eduarbo/flan/docs/frame-proposals.md

# Selected frames

[Open the mobile gallery](https://flankbd.com/frame-proposals/).

The collection contains only **Talavera, Game Boy, SNES, Phone, iPod and Hanafuda**. Their artwork and palettes remain unchanged. No new proposals await approval.

Each gallery card includes an enlarged preview, dimensions and a 1:1 SVG. All designs use solid colors and flush details on the current 24 × 56 mm frame.

All six designs are installed in the current assembly, explorer and print exports. The native archive retains earlier geometry. [Current selection record](../design/frame-selection.json).
