eduarbo/flan/ATTRIBUTION.md

# Credits and licenses

Flan36 is inspired by Piantor by beekeeb and keeps Piantor's 36 key centres and angles, translated per half without change. Flan42 and Flan54 add Piantor's outer pinky column (K00/K10/K20). That key layout is the part of Flan derived from Piantor, under GPL-3.0. The wireless PCBs and their routing, the case outline rule, the cases, frames, firmware and branding are original work by Eduardo Ruiz. Imported reference files and third-party component meshes are credited individually below. There is no implied affiliation or certification by beekeeb or component manufacturers.

| Material | Author / source | License and changes |
|---|---|---|
| `sources/piantor/*.kicad_pcb` | beekeeb / Leo, [Piantor](https://github.com/beekeeb/piantor), commit `cd847afb4f9a86e8c1c8e36f243140644013afb2` | GPL-3.0; unchanged original copies |
| Choc footprint `keyswitches:Kailh_socket_PG1350_optional` | daprice, [keyswitches.pretty](https://github.com/daprice/keyswitches.pretty) | CC-BY-SA-4.0; notice in [LICENSES/Keyswitches.md](LICENSES/Keyswitches.md) |
| `Keebio-Parts:TRRS-PJ-320A` footprint | [Keebio](https://github.com/keebio/Keebio-Parts.pretty), commit `063565dcba9a8ee807d49772de0ed75ecaedcc26` | MIT; copyright/permission in [LICENSES/Keebio-MIT.txt](LICENSES/Keebio-MIT.txt) |
| `RPi_Pico:RPi_Pico_SMD_TH` footprint | [TPCWare / Nicola Carandini](https://github.com/ncarandini/KiCad-RP-Pico), commit `dc6f9b9f213dc36eebce626aa9ee72a333fa0db3` | [TPCWare license](LICENSES/TPCWare-KiCad.txt): CC-BY-SA-4.0 with design exception |
| Standard KiCad footprints, including `Resistor_SMD:R_1206_3216Metric_Pad1.30x1.75mm_HandSolder` | [KiCad libraries](https://www.kicad.org/libraries/license/) | [CC-BY-SA-4.0 with design exception](LICENSES/KiCad-Libraries.md) |
| `design/layout.json`, layout diagram; outer-column centres in `design/variants.json` | Key centres and angles of [Piantor](https://github.com/beekeeb/piantor) by beekeeb / Leo, commit `cd847afb4f9a86e8c1c8e36f243140644013afb2`; `source_x`/`source_y` keep the original coordinates | GPL-3.0; translated per half, angles unchanged; Flan36 omits the outer column, Flan42/54 restore it upright |
| `keycaps/*.stl`, `keycaps/variants/*.stl`, KLP meshes in FCStd/viewer/GLB | [KLP Lamé by braindefender](https://github.com/braindefender/KLP-Lame-Keycaps), commit `4a67a824232d3054c61599ea047c56a340faaba2` | CC-BY-SA-4.0; unchanged meshes, placed and colored. RevG catalogs all 38 Choc-stem files, Choc/MX body sizes. [Original three sources](keycaps/sources.json), [complete pinned sources](keycaps/variants-source.json) |
| `docs/images/revE-*.png` through `revI-*.png`, including case screenshots, and `docs/images/viewer-*.png` | Original Flan36 CAD renders incorporating credited KLP Lamé meshes | CC-BY-SA-4.0; calculated from attributed meshes, no image retouching |
| `docs/marketing/assets/` product renders, cards and teaser videos; `docs/assets/home-og*.png` and `viewer/home/home-og.png` | Eduardo Ruiz / Flan CAD renders incorporating KLP Lamé by braindefender; composition and typography from `viewer/marketing/` | CC-BY-SA-4.0 for the rendered compositions, matching the existing CAD-render license; see [asset notice](docs/marketing/ASSET-LICENSE.md). Avatar/logo retain their existing GPL-3.0-or-later and trademark terms. |
| Original CAD, project tools and original documentation | Eduardo Ruiz / Flan36 contributors | GPL-3.0-or-later, except identified materials above |
| Embedded 3D engine | [Three.js](https://github.com/mrdoob/three.js), 0.180.0 | MIT; full [notice](LICENSES/Three-MIT.txt) also embedded in offline HTML |
| Home page model packs, `docs/assets/home-*.bin` | Viewer scene meshes, including KLP Lamé keycaps, simplified within a stated error with [meshoptimizer](https://github.com/zeux/meshoptimizer) 1.2.0 | Keycap meshes stay CC-BY-SA-4.0 as simplified adaptations; meshoptimizer is MIT ([notice](LICENSES/meshoptimizer-MIT.txt)); its decoder is bundled in the home page |
| Explorer mesh files, `docs/explore/assets/geometry-*.bin` | Viewer scene meshes, including KLP Lamé keycaps: positions and triangles unchanged, encoded with [meshoptimizer](https://github.com/zeux/meshoptimizer) 1.2.0; normals stored as 16-bit octahedral vectors | Keycap meshes stay CC-BY-SA-4.0; meshoptimizer is MIT ([notice](LICENSES/meshoptimizer-MIT.txt)); its decoder is bundled in the explorer |
| Home page fonts, `docs/assets/fonts/` | [Fraunces](https://github.com/undercasetype/Fraunces), [Inter](https://github.com/rsms/inter), [JetBrains Mono](https://github.com/JetBrains/JetBrainsMono): Google Fonts latin subsets, served locally | SIL OFL 1.1: [Fraunces](LICENSES/Fraunces-OFL.txt), [Inter](LICENSES/Inter-OFL.txt), [JetBrains Mono](LICENSES/JetBrainsMono-OFL.txt) |
| External product photos in the parts guide | Typeractive, Adafruit and respective rights holders | Linked/embedded from supplier listings; not copied into the asset tree or relicensed under the repository license |

The viewer retains source notices; exported GLB includes attribution and source/license links. Viewer code is under GPL-3.0-or-later; esbuild is a pinned build dependency. Gzip packaging does not alter the underlying geometry, and the explorer's mesh files keep every position and triangle byte for byte.

The three `docs/images/branding/flan36-*-concept.png` boards were generated with OpenAI's built-in image generation tool for Eduardo's Flan36 identity exploration. They are concept art, not renders of the measured CAD. Four additional Caramel refinements (`flan36-caramel-soft.png`, `flan36-caramel-drop.png`, `flan36-caramel-bold.png`, `flan36-caramel-outline.png`) use the selected Caramel board as their reference. Prompts and provenance are retained in `design/branding-prompts.json`, `design/branding-caramel-prompts.json` and `design/branding.json`; their reuse follows the repository's GPL-3.0-or-later terms to the extent applicable.

Full texts: [GPL](LICENSE), [CC-BY-SA-4.0](LICENSES/CC-BY-SA-4.0.txt). Original upstream hashes: [sources/manifest.json](sources/manifest.json).

Libraries under `hardware/revF/libraries` contain KiCad sources with the design exception, daprice’s Choc footprint under CC-BY-SA-4.0, and Flan36 symbols/footprints. STEP files under `hardware/revF/models` are original nominal envelopes, not manufacturer-certified models.

FreeCAD, StepUp, ZMK, Zephyr, nice!nano and nice!view retain their own names/licenses. FreeCAD/StepUp are installed separately; firmware candidates are distributed with pinned sources and [dependency notices](firmware/NOTICE.md). Supplier links do not imply sponsorship.

## Commercial component representations

KiSwitch Choc v1 source CAD is used under its MIT option (copyright 2019–2022 keyswitch-kicad-library contributors). KiCad PCM12, TL3342 and SOD-123 assets use CC-BY-SA-4.0 with the KiCad library exception. See [per-file sources, transformations and limits](components/README.md) and [asset hashes](components/sources.json). nice!nano v2 is an original nominal reconstruction referenced to official photographs and the Woovie community drawing; no official photograph is embedded or relicensed.

The Flan wordmark in `docs/branding/flan/` and on the revI back silkscreen is the word “flan” set in [Fraunces](https://github.com/undercasetype/Fraunces) by Undercase Type (Phaedra Charles and Flavia Zimbardi), © 2018 The Fraunces Project Authors, under the SIL Open Font License 1.1. It was converted to outlines; the font software is not redistributed. The tecla-flan mark is original work under the project's GPL-3.0-or-later.

The `docs/branding/outline/flan36-*.svg` artwork is a deterministic vector conversion of the selected Outline board’s monochrome reference. Letterforms are traced paths, not a bundled or substituted font. Source, reference hash and contour checks are recorded in `tools/build_outline_logo.py`, `validation/branding-outline-trace.json` and `design/branding-outline-vectors.json`. The preview and SVG kit follow GPL-3.0-or-later to the extent applicable.

## Trademarks

The GPL covers the logo artwork as files, not the right to use Flan's names and marks. As an additional term under GPL-3.0 section 7(e), the project's license grants no trademark rights to the names Flan, Flan36, Flan42, Flan46 and Flan54, the Flan wordmark or the tecla-flan mark. See [TRADEMARKS.md](TRADEMARKS.md).

Some theme and frame names refer to other products and works by name, such as Game Boy, NES, SNES, Walkman, iPod and the EVA units of Evangelion. They describe a color palette or a look. Those names belong to their owners; Flan is not affiliated with or endorsed by them, and uses none of their logos or artwork.

## CAD authorship correction · 2026-10-09

Earlier viewer credits, GLB metadata and project descriptions incorrectly described the whole CAD as derived from Piantor. Eduardo Ruiz clarified that the CAD is his original design and Piantor inspired the key count. Current descriptions and exports reflect that correction. Historical coordinate-reference metadata, archived upstream copies and third-party license notices are preserved; no geometry or license terms changed.

## Key layout provenance · 2026-10-18

The 2026-10-09 wording said Piantor only inspired the key count. That understated it: all 36 centres and angles in `design/layout.json` match Piantor's switch footprints in `sources/piantor/` after a constant per-half translation, and Flan42/54 reuse Piantor's outer column. Descriptions now say that the key layout comes from Piantor. The PCBs and routing, the revI case outline rule (`tools/outline.py`), cases, frames and firmware remain Eduardo's original work; only the early RevE case study (`tools/build_case.py`) traced Piantor's board exterior. No geometry or license terms changed.
