eduarbo/flan/docs/cases.md

# Pick a case

Flan42, Flan46 and Flan54 have the same four styles, built from this case; see [their cases](variants.md#cases).

[Open the 3D explorer](https://flankbd.com/explore/) → **Design → Case** → choose a thumbnail. **Per half** applies a style to one half, so the halves can differ.

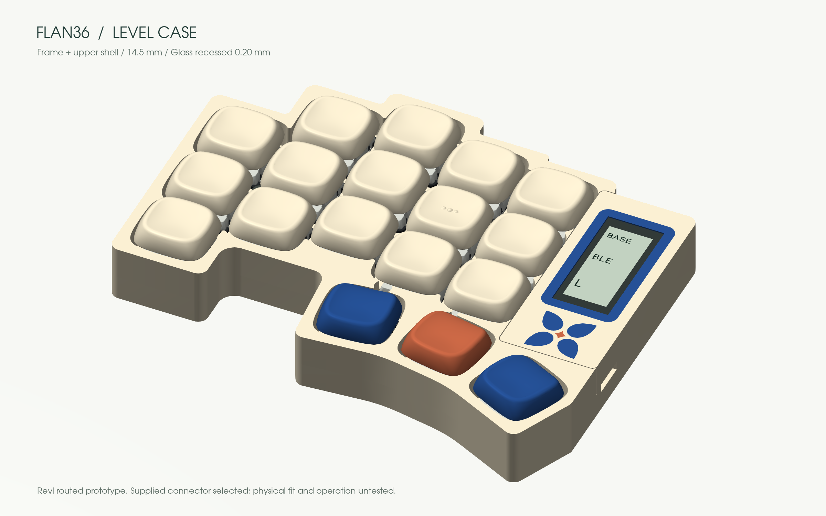
[picture p45: docs/images/revI-level.png]
Level case with flush glass and frame


| Solid | Color rim | Terrace |
|---|---|---|
| Solid | Color rim | Terrace |

| Design | Geometry | Suggested finish |
|---|---|---|
| **Level** | Switch-covering removable upper shell at the 14.50 mm frame plane | Match upper shell and frame |
| **Solid** | Full plate over a continuous sidewall | Deep teal |
| **Color rim** | 0.9 mm wide rim flush with the plate, 1.1 mm plate inset, 0.2 mm joint | Red base + black plate |
| **Terrace** | Two 0.25 mm deep, 0.6 mm high recessed side bands | Sage base + dark plate |

All four follow the same Flan36 key positions. Straight thumb faces stay parallel to their keys; tangent arcs soften their joins. Finger corners use up to R2.4, reduced locally at short steps. The pinky backbone remains 90°. No screw adds an outward bulge, and the thumb flank stays within the display-panel edge.

The shared outline is **116.75 × 94.57 mm per half**. Its 4.75 mm straight-face allowance protects the existing pads on both boards. The Color rim changes the visible plate edge without reducing that PCB budget. Terrace leaves at least 1.05 mm nominal sidewall away from intentional service openings; the 1.4 mm floor stays unchanged.

The **Level** upper shell and frame share the **14.50 mm** plane; the display glass is recessed 0.20 mm at **14.30 mm**. The original 1.3 mm switch-retaining plate is incorporated into the same removable part, using the three existing screws. Remove the caps to reach them. Upper openings are sized from the admitted KLP travel envelopes; the selected caps still reach about 17.87 mm. [Stack dimensions and connector qualification](level-stack.md).

## Open or covered

Uncheck **Printed display cover** to expose the current stack. The display, controller, battery and structural supports remain; the printed cover and its three Ø2 × 4 mm frame magnets are omitted. The three Ø2 × 3 mm base magnets stay in place. Choose any display frame to reinstall it. This is the wireless nice!nano/nice!view stack, not the Raspberry Pi Pico arrangement in the inspiration photo.

Color rim with the display stack exposed

**Eye / Solo** only change visibility. **Printed display cover** changes the saved assembly. Both choices are reversible, but only the assembly choice affects exported GLB and FreeCAD configuration.

## Edit and print

For Flan36, the optional [common M2 screw variant](common-fasteners.md) enlarges the hidden head pockets for ordinary socket-cap screws. Choose it in the explorer under **Build → Buy the parts → Screws**; the low-head reference screws remain the default.

Download [Flan36.FCStd](../mechanical/revI/Flan36.FCStd) and use the [FreeCAD guide](freecad.md). `ActiveTray` and `ActivePlate` link to native `Case_solid`, `Case_rim`, `Case_terrace` or `Case_level` bodies. Edit their source sketches and boolean operations under **Construction**. No custom Python proxy is needed to reopen the document.

[All case parts](../mechanical/revI) use `left-case-{solid,rim,terrace,level}-{base,plate}.{step,stl}` and matching `right-` names. Exported parts retain assembly coordinates. The viewer saves per-half case and cover choices in JSON; import that JSON with the configuration macro. JSON without case settings inherits the current default with covers installed. The assembled GLB includes the selected meshes, including when view layers are hidden.

Print the base and plate separately for contrasting colors; a multicolor printer is optional. Use the existing [fit coupons and rebuilding commands](cad.md) before a full shell. The raised rim and recessed bands are real geometry. Nominal CAD checks do not qualify their printed strength, snap or thread fit, magnetic holding force or actual electronics clearances.
