eduarbo/flan/docs/marketing/alt-text.md

# FLAN · Texto alternativo / Alt text

## ES

- `carousel-es-1.png`: Hazlo tuyo. Un teclado dividido y de código abierto. Casero, como un buen flan. PROTOTIPO · RENDER CAD.
- `carousel-es-2.png`: Pequeño. A tu manera. 36, 42, 46 o 54 teclas. Encuentra la distribución que quieres armar. PROTOTIPO · RENDER CAD.
- `carousel-es-3.png`: Un marco para tu estilo. Seis diseños de marco magnético. Cuatro carcasas. Elige tu combinación. PROTOTIPO · RENDER CAD.
- `carousel-es-4.png`: Cada capa. A la vista. Explora las piezas. Descarga PCB, firmware y archivos de impresión. El diseño es abierto. PROTOTIPO · RENDER CAD.
- `carousel-es-5.png`: De los píxeles a las piezas. Las piezas del primer Flan36 ya están encargadas. Siguen el armado y las pruebas físicas. PROTOTIPO · RENDER CAD.
- `carousel-es-6.png`: ¿Cómo sería el tuyo? 31 temas, colores por tecla y un explorador 3D. Empieza en flankbd.com. PROTOTIPO · RENDER CAD.

`share-es.png`: Render CAD de Flan36 con tema EVA-01, caja Color rim y marcos SNES / 2000s Phone. Pruebas físicas pendientes.

`square-es.png`, `story-es.png`, `youtube-es.png`, `render-hero.png`: Render CAD de Flan36, teclado dividido de 36 teclas, en crema y caramelo con marcos de pantalla Talavera. Prototipo; pruebas físicas pendientes.

## EN

- `carousel-en-1.png`: Make it yours. An open-source split keyboard. Homemade, like a good flan. PROTOTYPE · CAD RENDER.
- `carousel-en-2.png`: Small. Your kind of small. 36, 42, 46 or 54 keys. Find the layout you want to build. PROTOTYPE · CAD RENDER.
- `carousel-en-3.png`: A different frame of mind. Six magnetic display-frame designs. Four case styles. Choose your combination. PROTOTYPE · CAD RENDER.
- `carousel-en-4.png`: Every layer. Out in the open. Explore the parts. Get the PCB, firmware and print files. Build from open source. PROTOTYPE · CAD RENDER.
- `carousel-en-5.png`: From pixels to parts. The first Flan36 parts are ordered. Assembly, fit and wireless tests come next. PROTOTYPE · CAD RENDER.
- `carousel-en-6.png`: What would yours look like? 31 themes, per-key colors and a 3D explorer. Start at flankbd.com. PROTOTYPE · CAD RENDER.

`share-en.png`: CAD render of Flan36 with the EVA-01 theme, Color rim case and SNES / 2000s Phone frames. Physical tests pending.

`square-en.png`, `story-en.png`, `youtube-en.png`, `render-hero.png`: CAD render of Flan36, a 36-key split keyboard in cream and caramel with Talavera display frames. Prototype; physical tests pending.
