eduarbo/flan/docs/marketing/ASSET-LICENSE.md

# FLAN media assets · attribution

Product renders, cards, cover variants and teaser videos in this folder are **CC BY-SA 4.0**, consistent with the project's existing CAD-render license. They show the original Flan CAD by Eduardo Ruiz and include **KLP Lamé keycaps by braindefender**, placed and colored; the key layout follows **Piantor by beekeeb / Leo**. New work: explorer captures, colored backgrounds, typography, captions and sequencing. No physical product photograph is represented.

- Project and editable generation source: https://github.com/eduarbo/flan/tree/main/viewer/marketing
- Flan: https://flankbd.com/
- KLP Lamé: https://github.com/braindefender/KLP-Lame-Keycaps, pinned commit `4a67a824232d3054c61599ea047c56a340faaba2`.
- Piantor: https://github.com/beekeeb/piantor, pinned commit `cd847afb4f9a86e8c1c8e36f243140644013afb2`.
- CC BY-SA 4.0: https://creativecommons.org/licenses/by-sa/4.0/ and `LICENSES/CC-BY-SA-4.0.txt` in the downloadable kit.

Suggested credit / crédito sugerido:

> Flan by Eduardo Ruiz · CAD render with KLP Lamé keycaps by braindefender · CC BY-SA 4.0 · flankbd.com

Retain attribution and the applicable license, and explain edits. The artwork omits prototype labels at the designer’s request; accompanying project copy describes the first-build stage. Screen graphics are illustrative, not a firmware capture. The teaser has no music or borrowed typing sound.

`avatar.png` and the logo SVG kit reproduce the existing Flan mark: GPL-3.0-or-later artwork, with separate trademark terms in `TRADEMARKS.md`; no new trademark permission is granted. Typography uses Fraunces, Inter and JetBrains Mono; notices are in `LICENSES/`. Full component attribution is in the repository's `ATTRIBUTION.md` (included in the archive). That file also links source material which is available in the repository and is not all copied into this media archive.
