eduarbo/flan/docs/marketing/copy.md

# FLAN · Textos EN / ES

Borradores preparados; no publicados ni enviados. Origen: `viewer/marketing/copy.json`.

## ES

### Reddit / comunidad · versión en español

**[ad] Flan: un teclado dividido de código abierto; ya encargué las piezas del primer armado**

Soy Eduardo, el diseñador de Flan. Ya encargué las piezas del primer Flan36 y quiero compartir el diseño mientras llegan.

Es un teclado dividido de perfil bajo, con cuatro distribuciones: 36, 42, 46 y 54 teclas. Quería que su apariencia también fuera parte del proyecto: cuatro carcasas, seis diseños de marco magnético para las pantallas, 31 temas y colores por tecla. El explorador 3D permite probar una combinación, mirar sus piezas y descargar los archivos del prototipo.

Está diseñado para switches Choc v1 con sockets hot-swap, controladores nice!nano v2, ZMK y pantallas nice!view. Hay fuentes de KiCad y FreeCAD, Gerbers, archivos de impresión y firmware compilado. Flan36 conserva las posiciones de teclas de Piantor y usa keycaps KLP Lamé; los créditos están en el repositorio.

Las imágenes son renders CAD. Todavía no he armado ni probado un Flan físico: faltan comprobar ajuste, carga, conexión inalámbrica y autonomía. No estoy ofreciendo kits ni una compra grupal.

¿Qué te gustaría ver comprobado en la bitácora del primer armado?

Explorador: https://flankbd.com/explore/?size=flan36&theme=flan&case=rim&keys=original&frame=talavera
Fuentes y guía: https://github.com/eduarbo/flan

Uso: Usa esta versión en comunidades de habla hispana que permitan proyectos. Para r/ErgoMechKeyboards está preparada la versión EN, con prefijo [ad] y flair de vendor; no más de una promoción cada 14 días.

### Instagram · texto del carrusel

**Hazlo tuyo. Este es Flan.**

Piezas encargadas. Sigue el primer armado.

Este es Flan, un teclado dividido y de código abierto que estoy construyendo: cuatro tamaños, marcos magnéticos para las pantallas y una apariencia que puedes hacer tuya. Desliza para ver las distribuciones, las capas y en qué etapa va.

Las imágenes son renders CAD; el armado y las pruebas físicas vienen después. Ya puedes explorar el diseño y sus archivos en flankbd.com — enlace en mi perfil.

¿Cuántas teclas tendría el tuyo: 36, 42, 46 o 54?

#TecladosMecanicos #SplitKeyboard #DIYKeyboard #OpenSourceHardware #FlanKeyboard

Uso: Sube carousel-es-1 a carousel-es-6, en orden. Coloca flankbd.com como enlace del perfil; una URL en el texto de Instagram no equivale a un enlace pulsable.

### Instagram · Reel / YouTube Short

**Ya encargué las piezas de mi primer Flan**

Un teclado dividido para hacerlo tuyo. Este es Flan: archivos abiertos, cuatro tamaños y marcos magnéticos para las pantallas.

Las piezas del primer Flan36 ya están encargadas. Esto es un render CAD; siguen el armado y las pruebas físicas.

Explora el diseño en flankbd.com.

#TecladosMecanicos #DIYKeyboard #FlanKeyboard

Uso: Archivo: teaser-es.mp4, vertical 1080 × 1920, 30 segundos y sin audio; el texto ya está dentro del video. Subtítulos opcionales: teaser-es.srt. No representa hardware funcionando.

### YouTube · video de presentación

**Flan: así diseñé mi primer teclado dividido de código abierto**

Soy Eduardo y este es Flan: un diseño de teclado dividido y de perfil bajo, con cuatro tamaños y marcos magnéticos. Ya encargué las piezas del primer Flan36. En este video recorro el diseño, el explorador 3D y las pruebas que faltan para el primer armado físico.

Explora: https://flankbd.com/
Fuentes, créditos y guía: https://github.com/eduarbo/flan
Pruebas del primer armado: https://github.com/eduarbo/flan/blob/main/docs/first-build.md

Todas las imágenes del teclado en esta presentación son renders CAD. Todavía no hay un Flan físico armado y probado. No hay kits, preventa ni compra grupal.

Diseño: Eduardo Ruiz. Las posiciones de Flan36 siguen Piantor de beekeeb. Keycaps KLP Lamé de braindefender. Créditos y licencias completos en el repositorio.

#TecladosMecanicos #DIYKeyboard #OpenSourceHardware

Uso: Portada: youtube-es.png. El guion para grabar el video largo está en video.md; el teaser ya entregado dura 30 segundos. Los capítulos se añaden con los tiempos reales de la edición final.

### Grupo de teclados / makers

**Flan · presentación del primer armado**

Hola, soy Eduardo. Estoy diseñando Flan, un teclado dividido de código abierto con carcasas personalizables y marcos magnéticos para las pantallas. Ya encargué las piezas del primer Flan36 y me gustaría compartir el proceso si aquí se permiten publicaciones de proyectos.

Estas imágenes son renders CAD; el teclado físico todavía está pendiente de armado y pruebas. El explorador y los archivos están en https://flankbd.com/. Me interesa saber qué mediciones o fotos serían más útiles durante el primer armado.

Uso: Borrador para el espacio de proyectos autorizado por cada grupo. No se ha verificado membresía ni permiso de administradores y no se ha enviado ningún mensaje.

### Creador / medio · propuesta preparada

**Flan: un proyecto de teclado abierto para documentar su primer armado**

Hola, soy Eduardo Ruiz, el diseñador de Flan. Es un teclado dividido de código abierto con cuatro tamaños, carcasas imprimibles y marcos magnéticos para las pantallas. Tiene un explorador 3D para personalizarlo y descargar los archivos del prototipo.

Ya encargué las piezas del primer Flan36. Las imágenes disponibles son renders y todavía faltan el armado y las pruebas físicas. Si el proceso encaja con tu contenido, aquí puedes revisar el proyecto y su material; más adelante podré compartir resultados medidos cuando existan.

Proyecto: https://flankbd.com/
Fuentes: https://github.com/eduarbo/flan
Material visual: https://flankbd.com/marketing/

Eduardo

Uso: Borrador sin enviar. Personaliza el motivo concreto de relevancia para el destinatario al autorizar el contacto. No promete una muestra, patrocinio, fecha ni resultados de pruebas.

### Biografía · Instagram

**Flan Keyboard**

Teclado dividido de código abierto.
Hazlo tuyo en 3D.
Primer armado: piezas encargadas.
Del render a las piezas.

Uso: Enlace del perfil: https://flankbd.com/. No se han creado cuentas ni se ha verificado la disponibilidad de un handle.

### Respuesta fijada · estado del proyecto

**En qué etapa está**

Estado actual: ya encargué las piezas del primer Flan36. Las imágenes son renders CAD y el armado físico sigue pendiente. Los archivos están disponibles para construir prototipos; no estoy tomando pedidos de kits. Compartiré las mediciones cuando existan. Para reportar un problema del diseño o una configuración: https://github.com/eduarbo/flan/issues

Uso: Úsala cuando alguien interprete la presentación como un producto terminado o una venta.

## EN

### Reddit · r/ErgoMechKeyboards

**[ad] Flan: an open-source split with magnetic display frames — first build parts ordered**

I’m Eduardo, the designer of Flan. I’ve ordered the parts for the first Flan36 build, and I’m sharing the design while I wait for them to arrive.

Flan is a low-profile split keyboard with four layouts: 36, 42, 46 and 54 keys. I wanted the appearance to be something you can change as part of the build: four case styles, six magnetic display-frame designs, 31 themes and per-key colors. The browser explorer lets you try a combination, inspect its parts and download the corresponding prototype files.

The intended hardware is Choc v1 hot-swap, nice!nano v2 controllers, ZMK and nice!view displays. Editable KiCad and FreeCAD sources, Gerbers, print files and compiled firmware are available. Flan36 follows the Piantor key positions; keycaps use KLP Lamé. Credits and licenses are in the repository.

These images are CAD renders. I have not assembled or tested a physical Flan yet, so fit, charging, wireless behavior and battery life are still open. There is no kit or group buy on offer.

What would you want to see checked in the first assembly log?

Explorer: https://flankbd.com/explore/?size=flan36&theme=flan&case=rim&keys=original&frame=talavera
Source and build guide: https://github.com/eduarbo/flan

Uso: Prepared draft. Apply the vendor flair for this promotional post. The verified rule allows at most one promotional post per rolling 14 days and four promotional comments per rolling seven days. No cross-post blast. Check the rules and account eligibility again when posting.

### Instagram · carousel caption

**Make it yours. Meet Flan.**

Parts ordered. First build next.

This is Flan, an open-source split keyboard I’m building: four sizes, magnetic display frames and a look you can make your own. Swipe to see the layouts, the layers and where the project stands.

The images are CAD renders; physical assembly and testing are still ahead. You can already explore the design and its prototype files at flankbd.com — link in bio.

Which layout would you try: 36, 42, 46 or 54 keys?

#SplitKeyboard #MechanicalKeyboard #DIYKeyboard #OpenSourceHardware #FlanKeyboard

Uso: Use carousel-en-1 through carousel-en-6, in order. The caption URL is plain text: put the real destination in the profile link. Hashtags are descriptive choices, not a reach guarantee.

### Instagram · Reel / YouTube Short

**I ordered the parts for my first Flan keyboard**

A split keyboard you can make your own. This is Flan: open-source files, four sizes and magnetic display frames.

The first Flan36 parts are ordered. These are CAD renders; assembly and physical tests come next.

Explore the design at flankbd.com.

#SplitKeyboard #DIYKeyboard #FlanKeyboard

Uso: Upload teaser-en.mp4: 1080 × 1920, 30 seconds, silent, text already visible. Optional captions: teaser-en.srt. This is a rendered teaser, not footage of working hardware. Use a profile link on IG; on YouTube say the domain aloud if adding narration.

### YouTube · first design video

**Flan: designing my first open-source split keyboard**

I’m Eduardo, and this is Flan: an open-source, low-profile split keyboard design with four sizes and magnetic display frames. I’ve ordered the parts for the first Flan36 build. In this video I walk through the design, the 3D explorer and the tests the first physical build still needs.

Explore: https://flankbd.com/
Source, credits and build guide: https://github.com/eduarbo/flan
First-build checklist: https://github.com/eduarbo/flan/blob/main/docs/first-build.md

All keyboard visuals in this design preview are CAD renders. No physical Flan has been assembled and tested yet. No kits, preorder or group buy are available.

Design: Eduardo Ruiz. Flan36 key positions follow Piantor by beekeeb. KLP Lamé keycaps by braindefender. Full third-party attribution and licensing are in the repository.

#SplitKeyboard #DIYKeyboard #OpenSourceHardware

Uso: Use youtube-en.png for the design-video thumbnail. The longer video is a recording script in video.md; the delivered playable teaser is 30 seconds. Add chapters only after the final recording has actual timings.

### Community / maker group

**Flan · first-build preview**

Hi, I’m Eduardo and I’m sharing a keyboard I designed: Flan, an open-source split with customizable cases and magnetic display frames. The parts for my first Flan36 are ordered. I’d like to document the build here if project posts are welcome.

The images are CAD renders, and the hardware is still untested. The files and 3D explorer are at https://flankbd.com/. I’m interested in practical feedback about what to measure or photograph during the first assembly.

Uso: Use only in a group whose rules permit project promotion. Group access and admin permission are not verified; no message has been sent. Do not send unsolicited individual DMs.

### KBD.news · prepared editorial pitch

**Flan: open-source split keyboard with interchangeable magnetic display frames**

Hi, I’m Eduardo Ruiz, the designer of Flan. I’m sharing an open-source keyboard project that may fit your prototype/design coverage.

Flan combines four split layouts (36/42/46/54 keys), four printable case styles and six magnetic display-frame designs with a browser-based 3D explorer. The source includes KiCad, FreeCAD, Gerbers, printable parts and ZMK firmware.

I’ve ordered the first Flan36 parts; the design is still awaiting physical assembly and testing. The media kit clearly labels its CAD renders, and I would be happy to provide a measured build update once it exists.

Project: https://flankbd.com/
Source: https://github.com/eduarbo/flan
Images and project summary: https://flankbd.com/marketing/

Thanks,
Eduardo

Uso: Draft only. The publisher’s contact page invites keyboard-project submissions; direct page access was blocked during this review, so verify the current contact method before sending. No sample, sponsorship, launch date or coverage commitment is offered.

### Profile bio · Instagram

**Flan Keyboard**

Open-source split keyboard.
Make it yours in 3D.
First build: parts ordered.
CAD renders → real build next.

Uso: Profile link: https://flankbd.com/. Existing account names, handles and access have not been verified; this is copy, not a created account.

### Pinned reply · project status

**Where the project stands**

Quick status: the first Flan36 parts are ordered. The images here are CAD renders, and physical assembly/testing is still pending. The files are available for prototype builders; I’m not taking orders for kits. I’ll report measured results as the build progresses. Technical issues with a design/configuration: https://github.com/eduarbo/flan/issues

Uso: Use as the first clarification when a post is mistaken for a finished product or sale.
