eduarbo/flan/docs/marketing/video.md

# Video y captura

**Entregado:** `teaser-en.mp4` y `teaser-es.mp4`, 30 segundos, 1080 × 1920, H.264/yuv420p, sin sonido. Seis escenas de renders CAD con texto visible; subtítulos SRT separados. No es una demostración de un teclado funcionando. Los gráficos de pantalla del render son ilustrativos, no una captura del firmware.

## Voz opcional para el teaser

**ES:** «Este es Flan, un teclado dividido de código abierto para hacerlo tuyo. Puedes elegir entre cuatro tamaños, personalizar la carcasa y cambiar los marcos de las pantallas. El explorador muestra las piezas y permite descargar los archivos del prototipo. Ya encargué las piezas del primer Flan36. Ahora vienen el armado y las pruebas físicas. Mientras tanto, puedes probar tu combinación en flankbd.com.»

**EN:** “This is Flan, an open-source split keyboard you can make your own. Choose from four sizes, customize the case and change the display frames. The explorer shows the parts and lets you download the prototype files. I’ve ordered the parts for the first Flan36. Assembly and physical testing come next. Meanwhile, you can try your own combination at flankbd.com.”

Grabar con la voz real de Eduardo, ajustando el ritmo a los 30 segundos. El teaser funciona sin voz: no hace falta posponerlo ni agregar música para usarlo.

## Video de diseño · guion de 2–3 minutos

| Bloque | Imagen a grabar | ES | EN |
|---|---|---|---|
| Apertura | Eduardo o render completo, con rótulo de prototipo | «Quería un teclado pequeño que pudiera construir y personalizar. Este es Flan. Ya encargué las piezas del primer armado.» | “I wanted a small keyboard I could build and make my own. This is Flan. The first build’s parts are ordered.” |
| Distribución | Cambiar 36 → 42 → 46 → 54 en el sitio | «El diseño tiene cuatro tamaños. Flan36 será mi primer armado; los otros tamaños todavía necesitan sus propias pruebas.» | “There are four sizes. Flan36 is my first build; the others still need their own hardware tests.” |
| Apariencia | Talavera/Hanafuda, un tema, un color por tecla | «Puedo elegir carcasa, marco magnético y colores por tecla. Esta combinación se puede guardar y compartir.» | “I can choose the case, magnetic frame and individual key colors, then save or share the combination.” |
| Construcción | Abrir Parts, separar capas y abrir Build | «Aquí se ven las piezas, la lista de compra y los archivos. Las fuentes están disponibles para quien quiera explorar el diseño o construir un prototipo.» | “Here are the parts, shopping list and files. The sources are available to explore or build a prototype.” |
| Estado | Volver al teclado completo; rótulo «pruebas pendientes» | «Todavía tengo que comprobar el ajuste, el teclado, las pantallas, la carga y la conexión inalámbrica. No tengo una cifra de autonomía medida.» | “I still need to test fit, every key, the displays, charging and wireless behavior. I don’t have a measured battery-life figure.” |
| Cierre | Dominio legible, una sola invitación | «Puedes probar tu diseño en flankbd.com. Voy a documentar lo que funcione y lo que tenga que corregir.» | “Try your design at flankbd.com. I’ll document what works and what needs fixing.” |

Esta tabla es un guion preparado, no una grabación terminada. Usa la portada YouTube del idioma correspondiente y la descripción del kit. No añadir sonido de tipeo hasta grabar el teclado real. Los capítulos requieren los tiempos del montaje final.

## Cuando lleguen las piezas

Fotografiar/filmar con luz lateral suave, fondo limpio y una regla en las tomas de medidas. Tomar: ambas PCB por cada cara; componentes antes del montaje; una unión de soldadura en detalle; cupones/ajuste de impresión; polaridad antes de conectar batería; primer USB/tecla; ambas mitades y pantallas; encaje y retirada del marco; teclado completo sobre la mesa; una secuencia de tipeo sin música. Ocultar etiquetas de envío y datos de pedido.

Mantener los archivos originales. Registrar el ID de build, configuración y la prueba realizada junto a cada resultado en [first-build.md](../first-build.md). Una foto de encendido no acredita autonomía ni fiabilidad BLE. Tras la aceptación física, sustituir el render principal por una foto real y actualizar únicamente las afirmaciones medidas.
