eduarbo/flan/docs/proposals/home-r2/a.html

Flan

Flan Keyboard

# Make it yours.Hazlo tuyo.

A low-profile wireless split keyboard. Pick a size, a theme, a case and keycaps; every part is open, from PCB to print.Un teclado dividido inalámbrico de perfil bajo. Elige tamaño, tema, caja y keycaps; cada pieza es abierta, del PCB a la impresión.

Explore this in 3D →Explorar esto en 3D →

### SizeTamaño

### ThemeTema

### Case

### Keycaps

14.5 mmLow profile: Choc v1 hot-swap under a flush frame.Perfil bajo: Choc v1 hot-swap bajo un marco al ras.

WirelessInalámbriconice!nano v2 and ZMK, a nice!view on each half.nice!nano v2 y ZMK, una nice!view en cada mitad.

36–54Keys in four sizes, with the same thumbs.Teclas en cuatro tamaños, con los mismos pulgares.

28Themes, plus six magnetic display frames.Temas, más seis marcos magnéticos para la pantalla.

OpenAbiertoKiCad, FreeCAD, Gerbers and print files. GPL-3.0.KiCad, FreeCAD, Gerbers y archivos de impresión. GPL-3.0.

bypor eduarbo (https://eduarbo.com) PartsPiezas (https://github.com/eduarbo/flan/blob/main/docs/parts.md)Order PCBsPedir PCB (https://github.com/eduarbo/flan/blob/main/docs/electronics.md#order-the-two-pcbs)Firmware (https://github.com/eduarbo/flan/blob/main/docs/firmware.md)GitHub (https://github.com/eduarbo/flan) Digital prototype: routed PCBs, printable cases and compiled firmware. Physical tests in progress.Prototipo digital: PCB ruteados, cajas imprimibles y firmware compilado. Pruebas físicas en curso.
