eduarbo/flan/docs/proposals/home-r2/b.html

Flan

Flan Keyboard · open hardwarehardware abierto

# One keyboard, every way you like it.Un teclado, como más te guste.

Low-profile, wireless and split. Try a size, theme, case and keycaps here, then open your build in 3D.Perfil bajo, inalámbrico y dividido. Prueba aquí tamaño, tema, caja y keycaps, y abre tu versión en 3D.

Open in 3D →Abrir en 3D →

### SizeTamaño

### ThemeTema

### Case

### Keycaps

Frame planePlano del marco14.50 mmChoc v1 hot-swap, flush glass.Choc v1 hot-swap, cristal al ras.

ControllerControladornice!nano v2Bluetooth, ZMK, nice!view display.Bluetooth, ZMK, pantalla nice!view.

LooksEstilos28 · 6 · 4Themes, magnetic frames, case styles.Temas, marcos magnéticos, estilos de caja.

SourcesFuentesKiCad · FreeCADGerbers, STEP, STL and 3MF. GPL-3.0.Gerbers, STEP, STL y 3MF. GPL-3.0.

bypor eduarbo (https://eduarbo.com) PartsPiezas (https://github.com/eduarbo/flan/blob/main/docs/parts.md)Order PCBsPedir PCB (https://github.com/eduarbo/flan/blob/main/docs/electronics.md#order-the-two-pcbs)Firmware (https://github.com/eduarbo/flan/blob/main/docs/firmware.md) Digital prototype · physical tests in progressPrototipo digital · pruebas físicas en curso
