eduarbo/flan/docs/proposals/home-r1/a.html

Flan

# Small keyboard. Personal by design.Teclado pequeño. Personal por diseño.

A low-profile wireless split keyboard you can print, build and make yours. Open hardware, in four sizes.Un teclado dividido inalámbrico de perfil bajo que puedes imprimir, armar y hacer tuyo. Hardware abierto, en cuatro tamaños.

Choose your sizeElige tu tamaño Explore in 3DExplorar en 3D

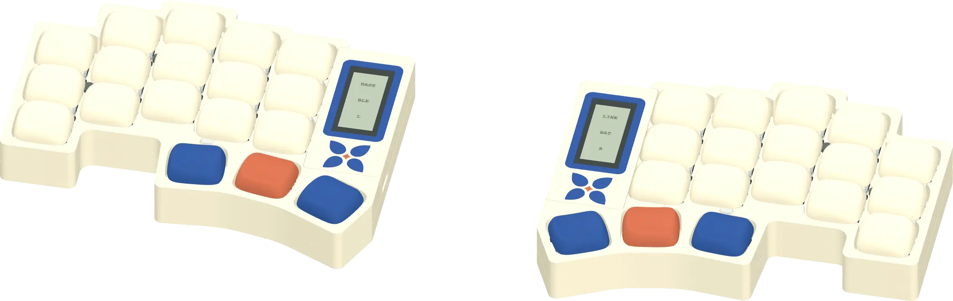
[picture p49: docs/images/home/flan36-3d.webp]
Flan36, both halves, in the Level case with Talavera frames


14.5 mmLow profile: Choc v1 hot-swap under a flush frame.Perfil bajo: Choc v1 hot-swap bajo un marco al ras.

WirelessInalámbriconice!nano v2 and ZMK, a nice!view on each half.nice!nano v2 y ZMK, una nice!view en cada mitad.

36–54Keys, in four sizes with the same thumbs.Teclas, en cuatro tamaños con los mismos pulgares.

4 · 6 · 28Case styles, magnetic frames and themes.Estilos de caja, marcos magnéticos y temas.

OpenAbiertoKiCad, FreeCAD, Gerbers and print files. GPL-3.0.KiCad, FreeCAD, Gerbers y archivos de impresión. GPL-3.0.

## Choose your FlanElige tu Flan

Every size keeps the same thumbs, electronics and display. Pick one to open it in 3D.Todos los tamaños comparten pulgares, electrónica y pantalla. Elige uno para abrirlo en 3D.

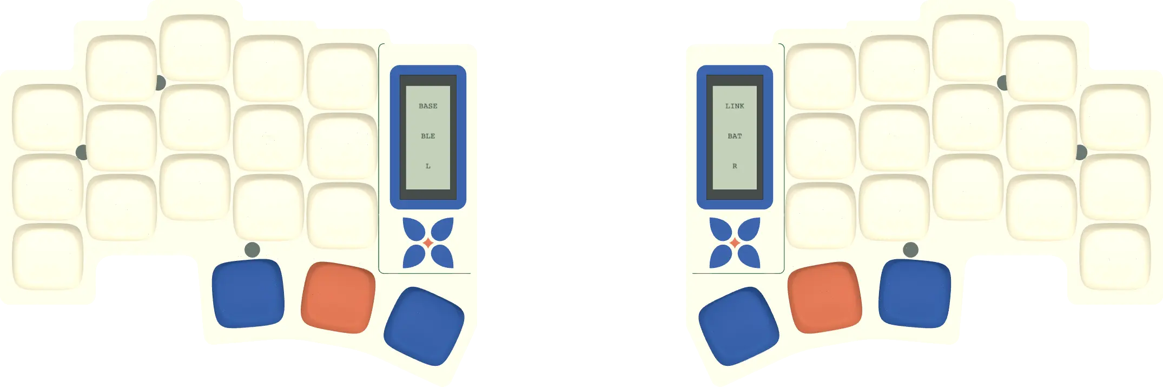
[picture p50: docs/images/home/flan36-top.webp]


Flan3636 keysteclas · 3 × 5 + 3The essential split.El esencial.Explore →Explorar →

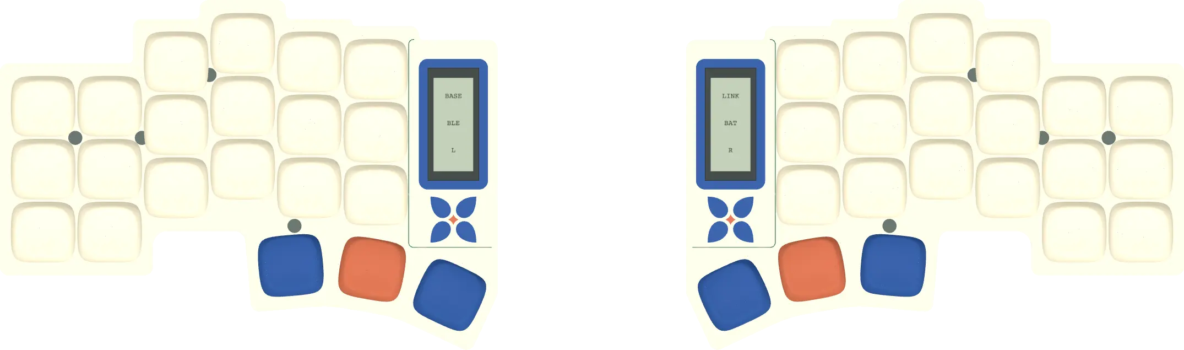
[picture p51: docs/images/home/flan42-top.webp]


Flan4242 keysteclas · 3 × 6 + 3Adds an outer pinky column.Suma una columna exterior para el meñique.Explore →Explorar →

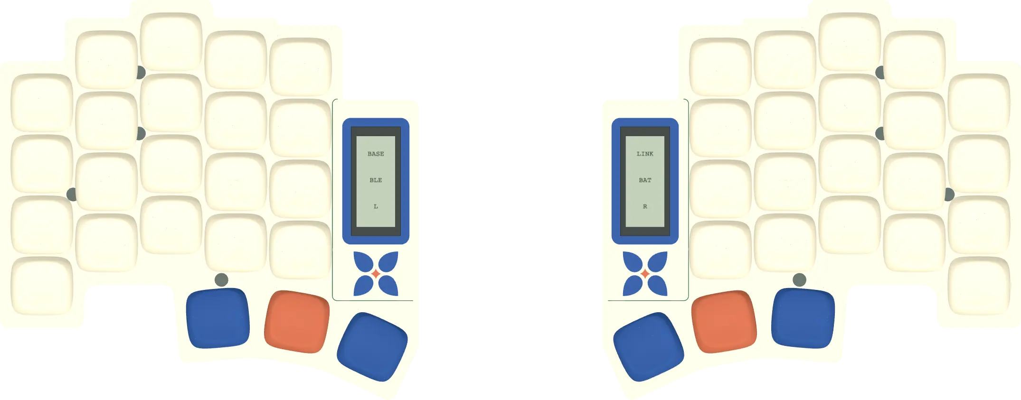
[picture p52: docs/images/home/flan46-top.webp]


Flan4646 keysteclas · 4 × 5 + 3Adds a number row.Suma una fila de números.Explore →Explorar →

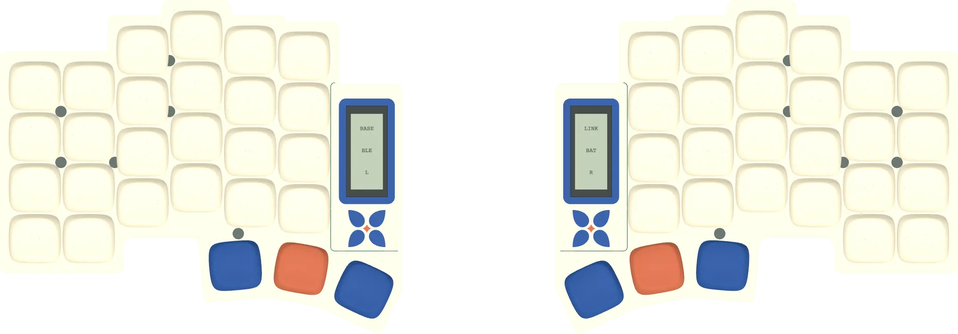
[picture p53: docs/images/home/flan54-top.webp]


Flan5454 keysteclas · 4 × 6 + 3Number row and outer column.Fila de números y columna exterior.Explore →Explorar →

bypor eduarbo (https://eduarbo.com) PartsPiezas (https://github.com/eduarbo/flan/blob/main/docs/parts.md)Order PCBsPedir PCB (https://github.com/eduarbo/flan/blob/main/docs/electronics.md#order-the-two-pcbs)Firmware (https://github.com/eduarbo/flan/blob/main/docs/firmware.md)GitHub (https://github.com/eduarbo/flan) Digital prototype: routed PCBs, printable cases and compiled firmware. Physical tests in progress.Prototipo digital: PCB ruteados, cajas imprimibles y firmware compilado. Pruebas físicas en curso.
