eduarbo/flan/docs/proposals/home-r1/b.html

Flan

Open hardware · Rev IHardware abierto · Rev I

# Low, wireless, split. Drawn to the millimetre.Bajo, inalámbrico, dividido. Dibujado al milímetro.

Flan is a split keyboard with routed PCBs, printable cases and ZMK firmware. Every part is open, measured and ready to build.Flan es un teclado dividido con PCB ruteados, cajas imprimibles y firmware ZMK. Cada pieza es abierta, está medida y lista para armar.

Choose a sizeElige un tamaño GitHub (https://github.com/eduarbo/flan)

Flan36 in the Level case

Flan36 · Level · Talavera116.75 × 94.57 mm

Frame planePlano del marco14.50 mmChoc v1 hot-swap, flush glass.Choc v1 hot-swap, cristal al ras.

ControllerControladornice!nano v2Bluetooth, ZMK, nice!view display.Bluetooth, ZMK, pantalla nice!view.

SizesTamaños36 · 42 · 46 · 54Same thumbs, bay and battery.Mismos pulgares, bahía y batería.

SourcesFuentesKiCad · FreeCADGerbers, STEP, STL and 3MF. GPL-3.0.Gerbers, STEP, STL y 3MF. GPL-3.0.

The familyLa familia

## Pick a size to explore in 3DElige un tamaño para explorarlo en 3D

Flan36  3 × 5 + 3 · 36 keysteclas116.75 × 94.57 mmOpen →Abrir → Flan42  3 × 6 + 3 · 42 keysteclas134.75 × 94.57 mmOpen →Abrir → Flan46  4 × 5 + 3 · 46 keysteclas116.75 × 111.57 mmOpen →Abrir → Flan54  4 × 6 + 3 · 54 keysteclas134.75 × 111.57 mmOpen →Abrir →

bypor eduarbo (https://eduarbo.com) PartsPiezas (https://github.com/eduarbo/flan/blob/main/docs/parts.md)Order PCBsPedir PCB (https://github.com/eduarbo/flan/blob/main/docs/electronics.md#order-the-two-pcbs)Firmware (https://github.com/eduarbo/flan/blob/main/docs/firmware.md) Digital prototype · physical tests in progressPrototipo digital · pruebas físicas en curso
