eduarbo/flan/docs/proposals/home-r1/c.html

Flan ENES

# Pick your Flan.Elige tu Flan.

A low-profile wireless split keyboard, open from PCB to case. Four sizes, the same thumbs. Open one in 3D and make it yours.Un teclado dividido inalámbrico de perfil bajo, abierto del PCB a la caja. Cuatro tamaños, los mismos pulgares. Abre uno en 3D y hazlo tuyo.

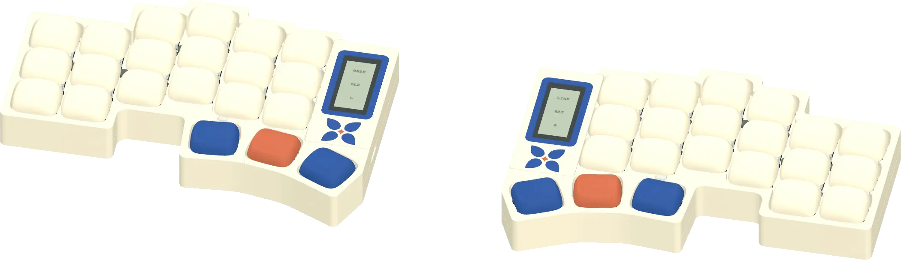
[picture p54: docs/images/home/flan42-3d.webp]
Flan42
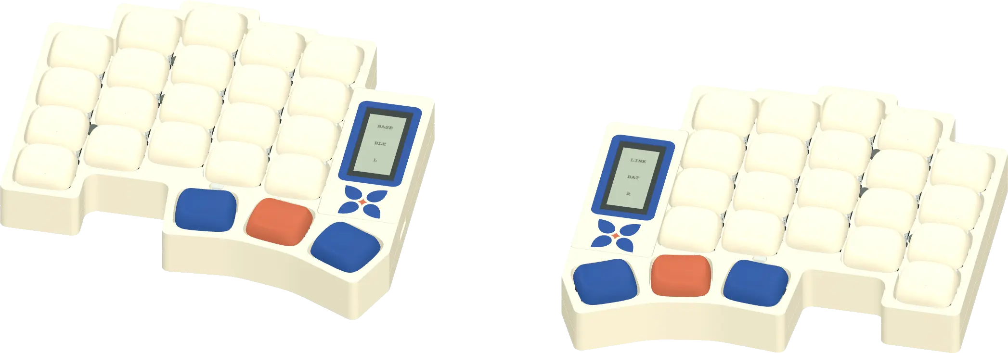
[picture p55: docs/images/home/flan46-3d.webp]
Flan46
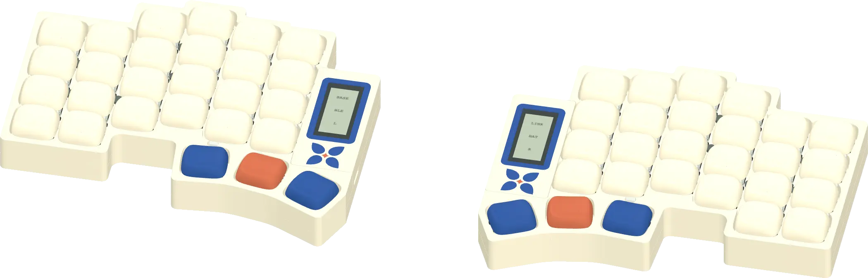
[picture p56: docs/images/home/flan54-3d.webp]
Flan54
Start hereEmpieza aquí Flan36 Flan3636 keysteclas · 3 × 5 + 3Explore in 3D →Explorar en 3D →  Flan4242 keys · outer pinky columnteclas · columna exteriorExplore in 3D →Explorar en 3D →  Flan4646 keys · number rowteclas · fila de númerosExplore in 3D →Explorar en 3D →  Flan5454 keys · bothteclas · ambasExplore in 3D →Explorar en 3D →

14.5 mm low profilede perfil Bluetooth · ZMK · nice!view Choc v1 hot-swap 4 casescajas · 6 magnetic framesmarcos magnéticos · 28 themestemas Open sourceCódigo abierto · KiCad · FreeCAD

bypor eduarbo (https://eduarbo.com) Build guideGuía de armado (https://github.com/eduarbo/flan/blob/main/docs/build.md)Order PCBsPedir PCB (https://github.com/eduarbo/flan/blob/main/docs/electronics.md#order-the-two-pcbs)GitHub (https://github.com/eduarbo/flan) Digital prototype: physical tests in progress.Prototipo digital: pruebas físicas en curso.
