eduarbo/flan/docs/launch.md

# Flan · kit de lanzamiento

**Listo para preparar la primera presentación del proyecto.** Piezas del primer Flan36 encargadas; armado y pruebas físicas pendientes. Este kit no constituye una preventa ni una campaña publicada.

**[Abrir el kit visual y copiar textos →](https://flankbd.com/marketing/)** · **[Descargar todos los archivos →](https://flankbd.com/marketing/flan-launch-kit.zip)** · **[Textos EN/ES](marketing/copy.md)**

## Usar ahora

1. Abrir el kit y elegir EN o ES. El render principal muestra Flan36 en crema/caramelo y marco Talavera; [abre esa combinación](https://flankbd.com/explore/?size=flan36&theme=flan&case=rim&keys=original&frame=talavera).
2. Elegir el canal. Instagram: seis imágenes de carrusel en orden, caption y enlace del perfil. Reddit: post técnico con autoría, estado y reglas al lado. Reel/Short: MP4 vertical de 30 segundos, sin sonido. YouTube largo: portada, descripción y guion para grabar.
3. Usar la [secuencia por hitos](marketing/plan.md), registrar el enlace y atender las preguntas. Ver [canales y reglas](marketing/channels.md) antes de publicar. No hay publicaciones, envíos, cuentas nuevas ni anuncios pagados realizados por esta preparación.

## Material

| Entrega | Archivos |
|---|---|
| Vista al compartir · EVA-01 | `assets/share-en.png`, `assets/share-es.png` · 1200×630 |
| Carrusel | `assets/carousel-{en,es}-{1…6}.png` · 1080×1350 |
| Feed cuadrado | `assets/square-{en,es}.png` · 1080×1080 |
| Story / portada vertical | `assets/story-{en,es}.png` · 1080×1920 |
| Teaser | `assets/teaser-{en,es}.mp4` · 1080×1920, 30 s; SRT separado |
| Portada YouTube | `assets/youtube-{en,es}.png` · 1280×720 |
| Avatar | `assets/avatar.png` · 800×800 |
| Renders sin texto | `assets/render-*.png` · capturas del explorador, fondo transparente |
| Copy y operación | [Textos](marketing/copy.md), [FAQ](marketing/faq.md), [guion y tomas](marketing/video.md), [canales](marketing/channels.md), [plan y registro](marketing/plan.md) |

Los nombres de la tabla se resuelven dentro de `docs/marketing/`. Por petición de Eduardo, las imágenes no llevan rótulo de prototipo; el texto que las acompaña conserva el estado del primer armado. Los renders proceden de la geometría real del explorador; sus gráficos de pantalla son ilustrativos. El video entregado es un teaser con renders, no una grabación de hardware funcionando. No se usó música ni sonido de tipeo ajeno.

## Posicionamiento y límites

Flan es un diseño abierto de teclado dividido y de perfil bajo, con cuatro tamaños y personalización de carcasas, marcos y colores. El primer armado será Flan36. Invitar a explorar, seguir el proceso y dar feedback técnico. No afirmar duración de batería, ajuste impreso, comodidad, carga o fiabilidad BLE antes de medirlos; tampoco ofrecer kits ni una fecha de envío. La altura nominal de 14.50 mm describe el techo de Level/marco y excluye patas y keycaps; no es la altura total del teclado.

Las fuentes, licencias y créditos están en [ATTRIBUTION.md](../ATTRIBUTION.md). El nombre/logo se rige por [TRADEMARKS.md](../TRADEMARKS.md). Las referencias visuales a otros productos no implican afiliación. Conservar atribución a Piantor y KLP Lamé cuando corresponda.

## Destino y seguimiento

Entrada principal: [flankbd.com](https://flankbd.com/). Acción: explorar una combinación. Progreso real: [primer armado](first-build.md). Feedback reproducible: [GitHub Issues](https://github.com/eduarbo/flan/issues). No se agregó una lista de correo, píxel ni servicio de analítica. Los resultados se anotan manualmente con las métricas que sí expone cada plataforma.

El sitio contiene metadatos Open Graph/X, dirección canónica, datos estructurados sin oferta de venta, robots y sitemap. La tarjeta se publica con un nombre derivado de sus bytes; se conserva la dirección anterior para consumidores que ya la tengan en caché. [Verificación técnica y reproducción](marketing/verification.md). La vista exacta en apps de terceros sólo se considera verificada cuando se observe allí; el HTTP correcto no demuestra que una caché ajena se haya actualizado.

**Variantes de portada:** EVA-01/Color rim, Matcha/Terrace, Hanafuda/Level y Flan/Solid, con marcos distintos. [Ver combinaciones](marketing/variants/README.md) · [Descargar variantes](https://flankbd.com/marketing/flan-cover-variants.zip).
