eduarbo/flan/docs/marketing/channels.md

# Canales y reglas

**Primera etapa: compartir el diseño y documentar el primer Flan36.** Revisión pública: 13 de noviembre de 2026. No se han publicado posts, contactado administradores ni verificado cuentas. La prioridad es una hipótesis de afinidad, no una promesa de alcance.

| Prioridad | Lugar | Pieza y propósito | Regla / evidencia / siguiente paso |
|---|---|---|---|
| 1 | [r/ErgoMechKeyboards](https://www.reddit.com/r/ErgoMechKeyboards/) | Post técnico EN con render, autoría, estado real y una pregunta de pruebas. | [Reglas oficiales](https://www.reddit.com/r/ErgoMechKeyboards/wiki/rules/): el split es pertinente; autopromoción con prefijo `[ad]` y flair de vendor; máximo una promoción cada 14 días y cuatro comentarios promocionales cada siete días. No compraventa. Confirmar flair y elegibilidad antes de publicar. |
| 1 | Instagram propio | Carrusel de seis imágenes; Reel de 30 s; story con enlace al explorador. | Material EN/ES listo. Handle y acceso no verificados. Usar el idioma habitual de la cuenta y un enlace real en el perfil. Los grupos privados requieren sus reglas y acceso: no se consideran canales ya habilitados. |
| 1 | YouTube propio | Short del diseño ahora; bitácora del primer armado después. | [YouTube](https://support.google.com/youtube/answer/15424877?hl=en) admite Shorts cuadrados o verticales de hasta tres minutos; entregado 9:16 de 30 s. El video largo necesita grabación/voz real. Sin música ni audio ajeno en los archivos. |
| 2 | [KeebTalk](https://www.keebtalk.com/) | Un diario de proyecto que se actualice con resultados y fotos. | [Guía oficial](https://www.keebtalk.com/guidelines): categoría pertinente, contexto y nada de spam. Confirmar la categoría vigente para proyectos; no abrir duplicados del mismo diario. |
| 2 | [KBD.news](https://kbd.news/contact) | Propuesta editorial corta + kit de renders, identificando la etapa. | Su resultado de búsqueda oficial invita proyectos de teclados; la página directa respondió 403 durante la revisión. Método de envío actual pendiente de verificar. Borrador listo, no enviado. Mejor seguimiento: primer armado documentado. |
| 2 | [LatamKeys](https://linktr.ee/latamkeys) | Comunidad de habla hispana; post de proceso en el canal de proyectos permitido. | El directorio oficial enlaza Instagram y Discord. Membresía, invitación vigente y reglas internas no verificadas. No asumir que una cuenta de IG ofrece un grupo abierto. |
| 3 | [Ben Vallack](https://benvallack.com/) / [Joe Scotto](https://ko-fi.com/joe_scotto) | Posibles interlocutores para diseño/DIY después de obtener pruebas y fotos reales. | Afinidad temática observada en sus páginas; no se ha verificado disposición a cubrir Flan, recibir muestras ni canal de contacto. No prometer cobertura o mandar una muestra. |
| En reserva | [r/MechanicalKeyboards](https://www.reddit.com/r/MechanicalKeyboards/) | Evaluar cuando exista el primer armado. | [Anuncio oficial](https://www.reddit.com/r/MechanicalKeyboards/comments/1niq537/rules_update_media_only_post_typing_apps_games/): las imágenes requieren contexto y los builds, componentes. [Moderación reciente](https://www.reddit.com/r/MechanicalKeyboards/comments/1xmozcl/removed/) rechaza código/contenido generado con IA. Este kit tiene asistencia de IA: no pegarlo allí ni disimular su origen; confirmar elegibilidad del proyecto antes de preparar una publicación para ese destino. |
| Descartado para la primera ola | r/olkb, r/mechmarket, grupos generales masivos | Sin pieza inicial. | Flan usa ZMK y es columnar, no un lanzamiento de OLKB/QMK; no hay producto en venta para mechmarket. El encaje de un contenido técnico futuro se revisa por separado. |

## Publicación y conversación

Publicar primero en un solo espacio, responder las preguntas concretas y corregir cualquier dato equivocado en el mismo hilo. No repetir el mismo anuncio en varias comunidades el mismo día. En r/ErgoMechKeyboards respetar la ventana de 14 días incluso si el plan propone antes otra pieza para Instagram o YouTube. No pedir votos, inventar testimonios ni presentar un render como una foto.

La ayuda de IA en textos/herramientas no acredita ni invalida por sí sola el diseño: las reglas del destino deciden qué permiten. Si lo preguntan, describir la asistencia real sin ocultarla. Los renders provienen del modelo CAD del proyecto; no son imágenes de hardware generado por IA.

## Destinos

Usar el enlace limpio `https://flankbd.com/` en comunidades; el explorador del look mostrado está enlazado en el kit. Instagram necesita enlace de perfil o sticker de story. Un parámetro UTM no crea medición: actualmente no se ha instalado analítica ni captación de correo. Registrar los resultados nativos en [plan.md](plan.md); añadir instrumentación requiere una decisión posterior sobre herramienta y privacidad.
