eduarbo/flan/docs/marketing/plan.md

# Secuencia de lanzamiento

**Preparación para publicar, sin publicaciones programadas.** La llegada de piezas no tiene fecha confirmada. Las fases siguientes dependen de evidencia, no de un calendario automático. Responsable editorial: Eduardo; soporte de archivos y mediciones: agente del proyecto.

| Momento | Acción preparada | Material | Resultado que observar |
|---|---|---|---|
| Día de presentación elegido | Un post técnico en r/ErgoMechKeyboards, sujeto a flair y reglas actuales. | Texto EN, render completo y capas. | Preguntas de construcción concretas; registrar URL y dudas. |
| Siguiente día disponible | Carrusel en Instagram propio, en el idioma de su audiencia. | Seis imágenes + caption. | Guardados, visitas al perfil y preguntas sobre tamaños. |
| 2–4 días después | Reel/Short del diseño y story con enlace. | Teaser 30 s + portada + caption. | Retención nativa del video y personas que preguntan por el proyecto. |
| Tras las primeras respuestas | Contestar en el hilo original y convertir la duda más frecuente en una story. | FAQ y respuestas. | Si la aclaración resuelve la duda; actualizar la página si era confusa. |
| Al recibir las piezas | Unboxing breve y fotos reales; sin afirmar funcionamiento. | Shot list de video.md. | Inventario recibido y condición visible. |
| Primer montaje y pruebas | Bitácora de una prueba concreta, con resultados y fallos. | Guía de primer armado y guion. | Evidencia registrada por cada gate físico. |
| Tras aceptación física | Video largo de armado, fotos del teclado y propuesta editorial. | Guion, portada y pitch de KBD.news. | Evidencia pública de funcionamiento y feedback útil. |

La secuencia no autoriza otro anuncio en el mismo subreddit dentro de los 14 días. Actualizar el hilo original con información pertinente y responder preguntas concretas; no usar comentarios como anuncios encubiertos. Reservar 15–20 minutos al publicar para atender la conversación, y una revisión breve a las 48 horas y a los siete días. Son revisiones manuales sugeridas, no recordatorios creados.

## Registro mínimo

No hay datos iniciales ni objetivos de conversión inventados. Crear una fila al publicar; `—` significa no disponible, no cero. Recoger solamente cifras agregadas y enlaces públicos, sin datos personales.

| Fecha | Canal / URL pública | Pieza / idioma | Vistas nativas | Guardados | Preguntas útiles | Visitas/clics si la plataforma los muestra | Próxima mejora |
|---|---|---|---:|---:|---:|---:|---|
| Pendiente | — | — | — | — | — | — | — |

Comparar por canal, formato y tiempo transcurrido; vistas de distintas plataformas no son la misma métrica. Priorizar los comentarios que revelen confusión de estado, dificultad de montaje o interés por un tamaño. No inferir ventas, visitas al sitio o intención de compra a partir de likes. Repetir una pieza sólo si aporta algo nuevo y lo permiten las reglas. Sin datos propios no se promete «la mejor hora».

## Preparado frente a pendiente

Preparado: archivos visuales, teaser, copy EN/ES, bios, FAQ, lista de destinos, plan y guion. El sitio y el kit se verifican en la entrega técnica.

Dependencias reales: cuentas de publicación y sus handles no comprobados; acceso/permisos de grupos privados no comprobados; grabación del video largo y fotos reales dependen de Eduardo y del armado; funcionamiento físico se acepta con docs/first-build.md. Publicar, enviar pitches, abrir cuentas, comprar anuncios o tomar preventas no forma parte de esta preparación.
