eduarbo/flan/docs/proposals/home-r1/index.html

# Home page · R1

Tres direcciones para la página de inicio de Flan. Todas en inglés con botón ES, logo arriba, capacidades sin ruido y un selector de tamaño que abre el visor con esa variante. Las imágenes son renders reales del visor.

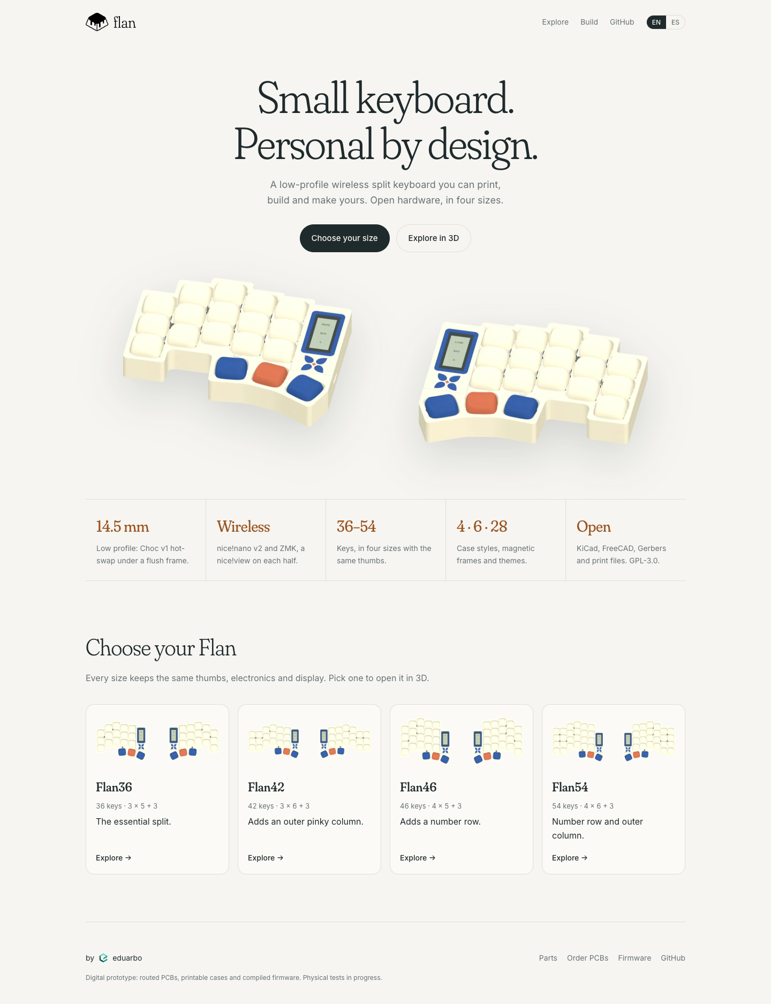
[picture p60: docs/proposals/home-r1/shots/a-desktop.png]
Propuesta A


## A · Quiet product

Cálida y editorial. El teclado al centro, cinco cifras clave y cuatro tarjetas para elegir tamaño.

AbrirTeléfonoES

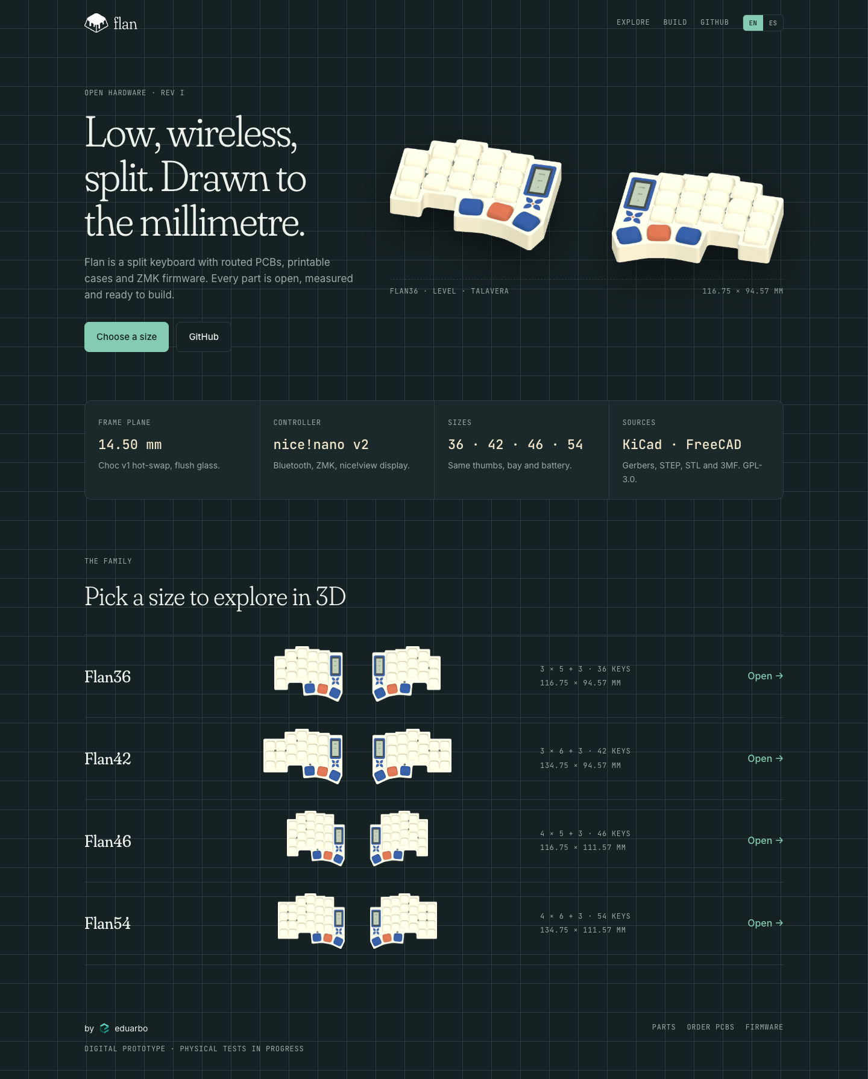
[picture p61: docs/proposals/home-r1/shots/b-desktop.png]
Propuesta B


## B · Blueprint

Oscura y técnica: retícula, medidas reales en monoespaciada y la familia como lista de planos.

AbrirTeléfono

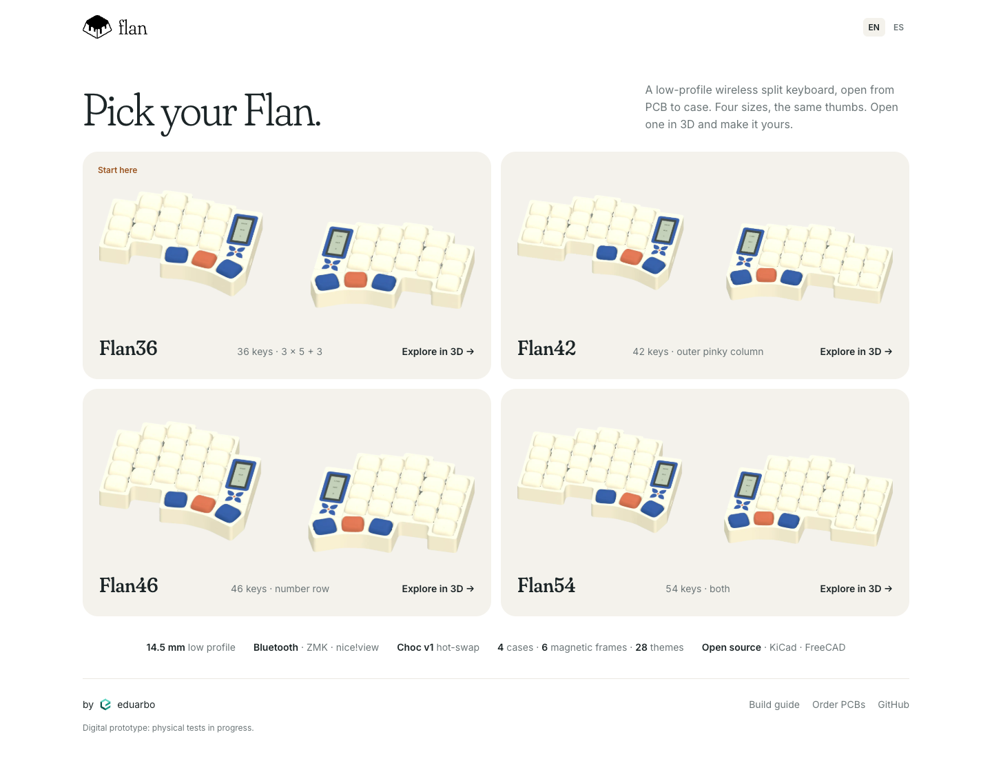
[picture p62: docs/proposals/home-r1/shots/c-desktop.png]
Propuesta C


## C · Choose first

La más directa: un titular y cuatro mosaicos grandes para entrar al visor. Las capacidades caben en una línea.

AbrirTeléfono

## Al elegir una

1. El home pasa a la raíz del sitio y el visor a /explore/. Elegir un tamaño abre /explore/#flan42, ya con esa variante cargada, y los enlaces actuales al visor se redirigen.
2. El visor muestra el logo de Flan en su barra, con enlace al home.
3. Cambiar de tamaño se vuelve rápido: las mallas de cada variante se preparan al construir el sitio, no en tu navegador, y la variante del enlace se carga mientras abre el visor.
4. En el visor, el selector de tamaño queda visible fuera de la pestaña Case.
