eduarbo/flan/design/proposals/explorer-r1/assets/pcb-sayagata.png

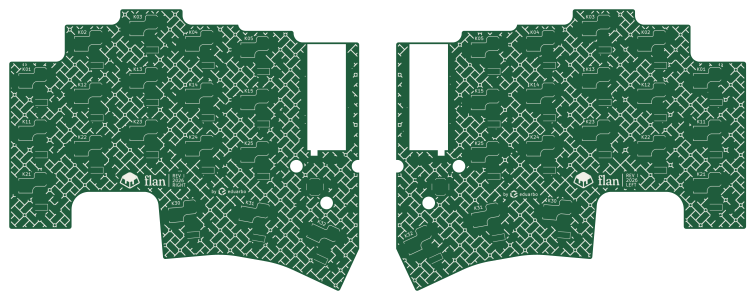
design/proposals/explorer-r1/assets/pcb-sayagata.png
