eduarbo/flan/design/proposals/explorer-r1/assets/phone-art-art-display.png

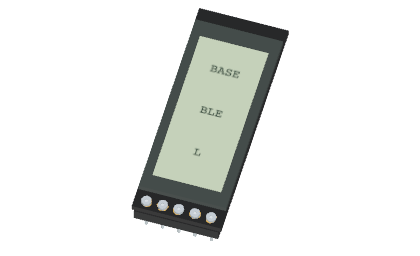
design/proposals/explorer-r1/assets/phone-art-art-display.png
