eduarbo/flan/design/proposals/explorer-r1/assets/phone-art-art-frames.png

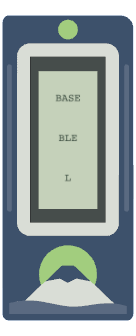
design/proposals/explorer-r1/assets/phone-art-art-frames.png
