eduarbo/flan/design/proposals/explorer-r1/assets/phone-art-art-layout.png

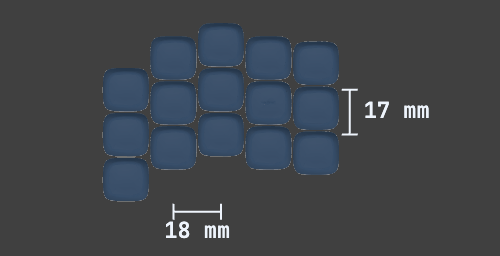
design/proposals/explorer-r1/assets/phone-art-art-layout.png
