eduarbo/flan/design/proposals/explorer-r1/assets/phone-art-art-pcb.png

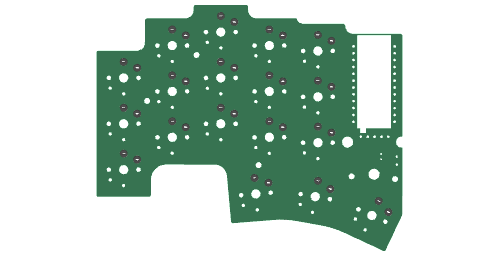
design/proposals/explorer-r1/assets/phone-art-art-pcb.png
