eduarbo/flan/design/proposals/explorer-r1/assets/phone-art-art-profile.png

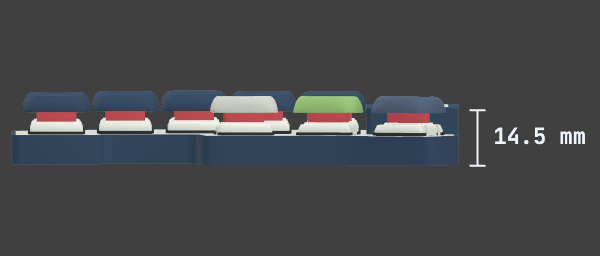
design/proposals/explorer-r1/assets/phone-art-art-profile.png
