eduarbo/flan/design/proposals/explorer-r1/assets/phone-art-art-stack.png

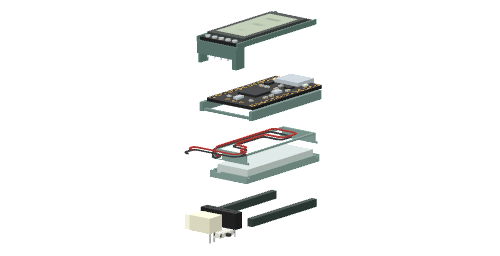
design/proposals/explorer-r1/assets/phone-art-art-stack.png
