eduarbo/flan/design/proposals/explorer-r1/assets/phone-case-level.png

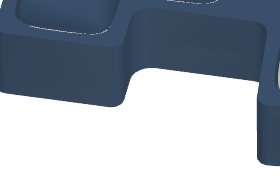
design/proposals/explorer-r1/assets/phone-case-level.png
