eduarbo/flan/design/proposals/explorer-r1/assets/phone-case-rim.png

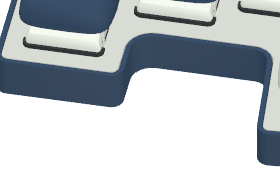
design/proposals/explorer-r1/assets/phone-case-rim.png
