eduarbo/flan/design/proposals/explorer-r1/assets/phone-case-solid.png

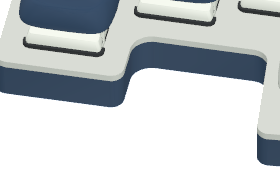
design/proposals/explorer-r1/assets/phone-case-solid.png
