eduarbo/flan/design/proposals/explorer-r1/assets/phone-frame-gameboy.png

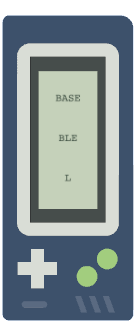
design/proposals/explorer-r1/assets/phone-frame-gameboy.png
