eduarbo/flan/design/proposals/explorer-r1/assets/phone-frame-phone.png

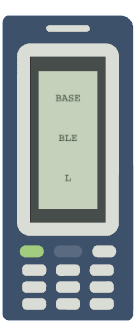
design/proposals/explorer-r1/assets/phone-frame-phone.png
