eduarbo/flan/design/proposals/explorer-r1/assets/phone-frame-snes.png

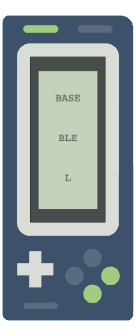
design/proposals/explorer-r1/assets/phone-frame-snes.png
