eduarbo/flan/design/proposals/explorer-r1/assets/phone-frame-talavera.png

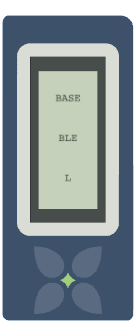
design/proposals/explorer-r1/assets/phone-frame-talavera.png
