eduarbo/flan/design/proposals/explorer-r1/assets/phone-keys-normal.png

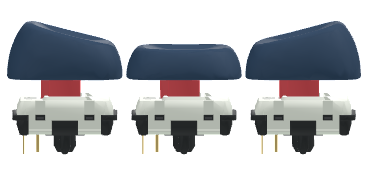
design/proposals/explorer-r1/assets/phone-keys-normal.png
