eduarbo/flan/design/proposals/explorer-r1/assets/phone-keys-original.png

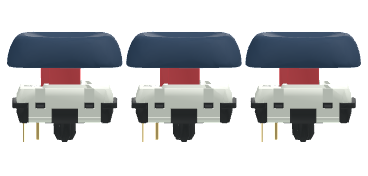
design/proposals/explorer-r1/assets/phone-keys-original.png
