eduarbo/flan/design/proposals/explorer-r1/assets/phone-model-apart.png

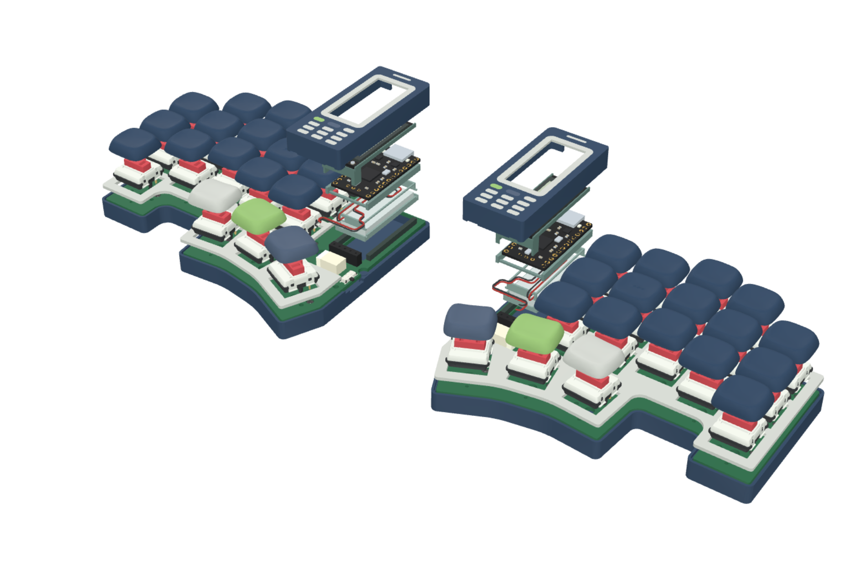
design/proposals/explorer-r1/assets/phone-model-apart.png
