eduarbo/flan/design/proposals/explorer-r1/assets/phone-model-together.png

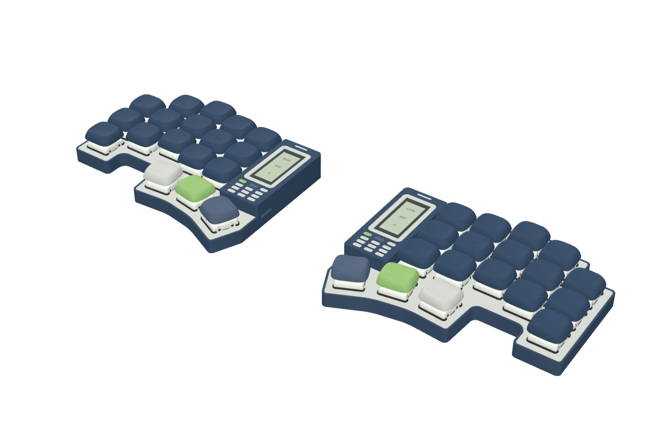
design/proposals/explorer-r1/assets/phone-model-together.png
