eduarbo/flan/design/proposals/explorer-r1/assets/phone-size-flan36.png

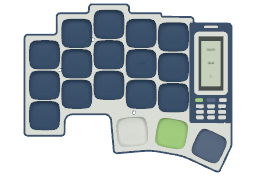
design/proposals/explorer-r1/assets/phone-size-flan36.png
