eduarbo/flan/design/proposals/explorer-r1/assets/phone-size-flan42.png

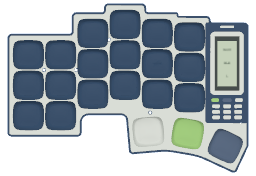
design/proposals/explorer-r1/assets/phone-size-flan42.png
