eduarbo/flan/design/proposals/explorer-r1/assets/phone-size-flan46.png

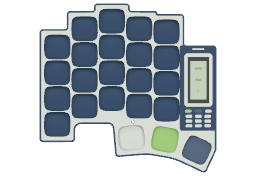
design/proposals/explorer-r1/assets/phone-size-flan46.png
