eduarbo/flan/design/proposals/explorer-r1/assets/phone-size-flan54.png

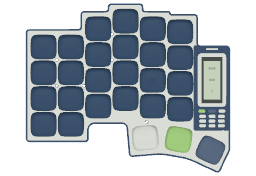
design/proposals/explorer-r1/assets/phone-size-flan54.png
