eduarbo/flan/design/proposals/explorer-r1/assets/snes-art-art-controller.png

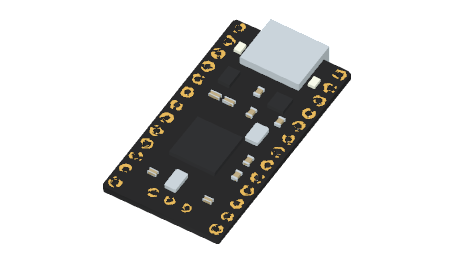
design/proposals/explorer-r1/assets/snes-art-art-controller.png
