eduarbo/flan/design/proposals/explorer-r1/assets/snes-art-art-frames.png

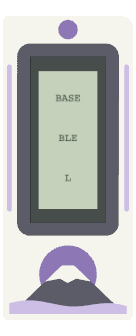
design/proposals/explorer-r1/assets/snes-art-art-frames.png
