eduarbo/flan/design/proposals/explorer-r1/assets/snes-art-art-layout.png

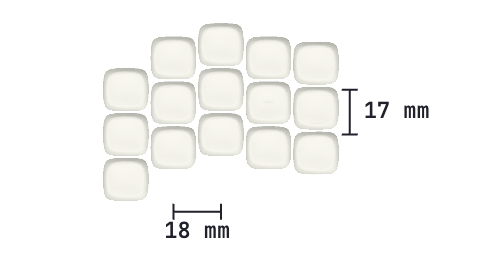
design/proposals/explorer-r1/assets/snes-art-art-layout.png
