eduarbo/flan/design/proposals/explorer-r1/assets/snes-art-art-profile.png

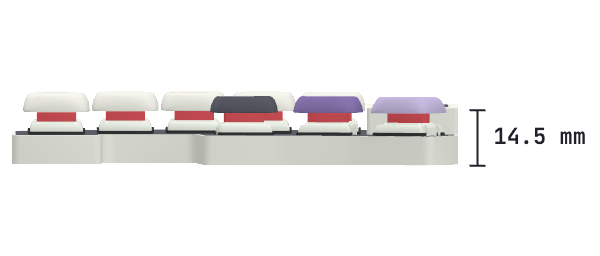
design/proposals/explorer-r1/assets/snes-art-art-profile.png
