eduarbo/flan/design/proposals/explorer-r1/assets/snes-case-level.png

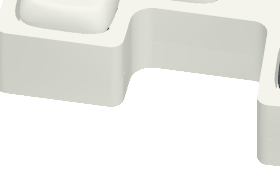
design/proposals/explorer-r1/assets/snes-case-level.png
