eduarbo/flan/design/proposals/explorer-r1/assets/snes-case-rim.png

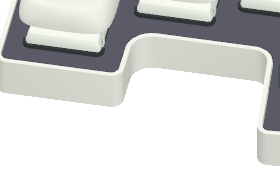
design/proposals/explorer-r1/assets/snes-case-rim.png
