eduarbo/flan/design/proposals/explorer-r1/assets/snes-case-solid.png

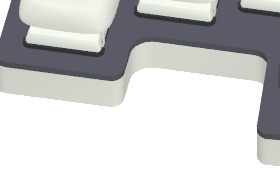
design/proposals/explorer-r1/assets/snes-case-solid.png
