eduarbo/flan/design/proposals/explorer-r1/assets/snes-frame-gameboy.png

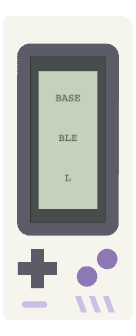
design/proposals/explorer-r1/assets/snes-frame-gameboy.png
