eduarbo/flan/design/proposals/explorer-r1/assets/snes-frame-phone.png

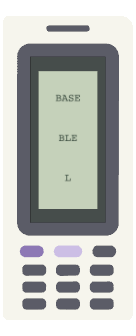
design/proposals/explorer-r1/assets/snes-frame-phone.png
