eduarbo/flan/design/proposals/explorer-r1/assets/snes-frame-snes.png

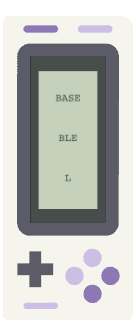
design/proposals/explorer-r1/assets/snes-frame-snes.png
