eduarbo/flan/design/proposals/explorer-r1/assets/snes-frame-talavera.png

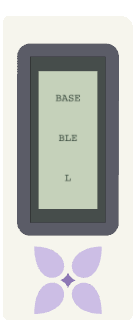
design/proposals/explorer-r1/assets/snes-frame-talavera.png
