eduarbo/flan/design/proposals/explorer-r1/assets/snes-model-apart.png

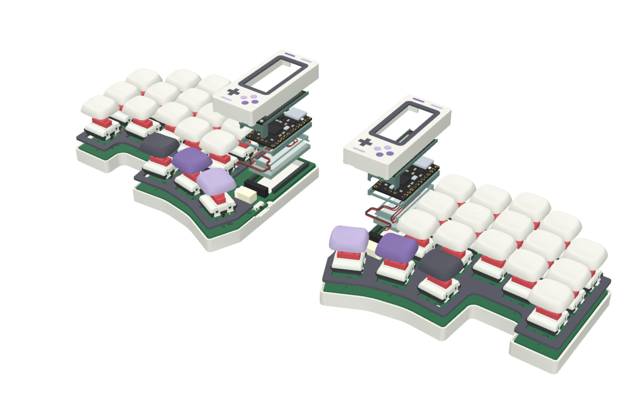
design/proposals/explorer-r1/assets/snes-model-apart.png
