eduarbo/flan/design/proposals/explorer-r1/assets/snes-model-together.png

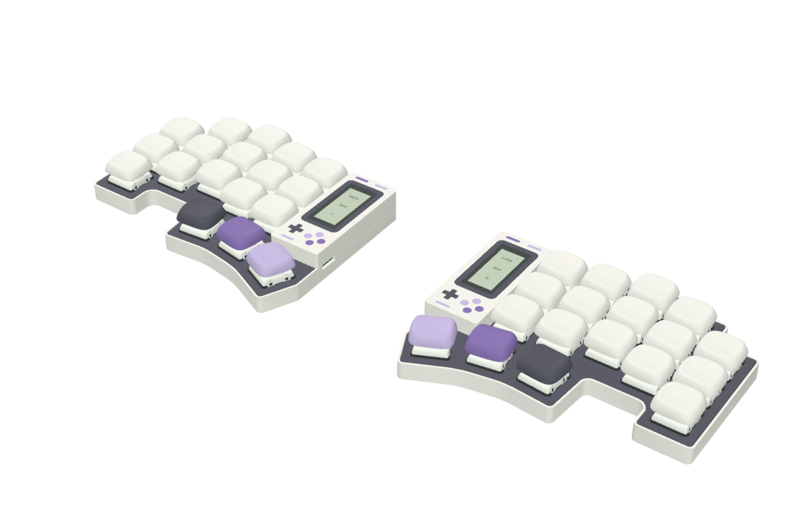
design/proposals/explorer-r1/assets/snes-model-together.png
