eduarbo/flan/design/proposals/explorer-r1/assets/snes-size-flan36.png

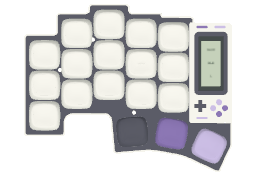
design/proposals/explorer-r1/assets/snes-size-flan36.png
