eduarbo/flan/design/proposals/explorer-r1/assets/snes-size-flan42.png

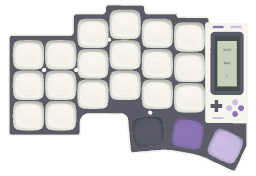
design/proposals/explorer-r1/assets/snes-size-flan42.png
