eduarbo/flan/design/proposals/explorer-r1/assets/snes-size-flan46.png

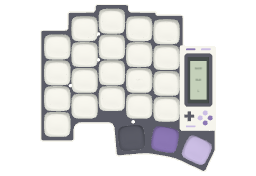
design/proposals/explorer-r1/assets/snes-size-flan46.png
