eduarbo/flan/design/proposals/explorer-r1/assets/snes-size-flan54.png

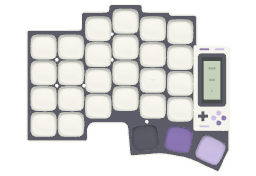
design/proposals/explorer-r1/assets/snes-size-flan54.png
