eduarbo/flan/design/proposals/home-r3/a-dock.png

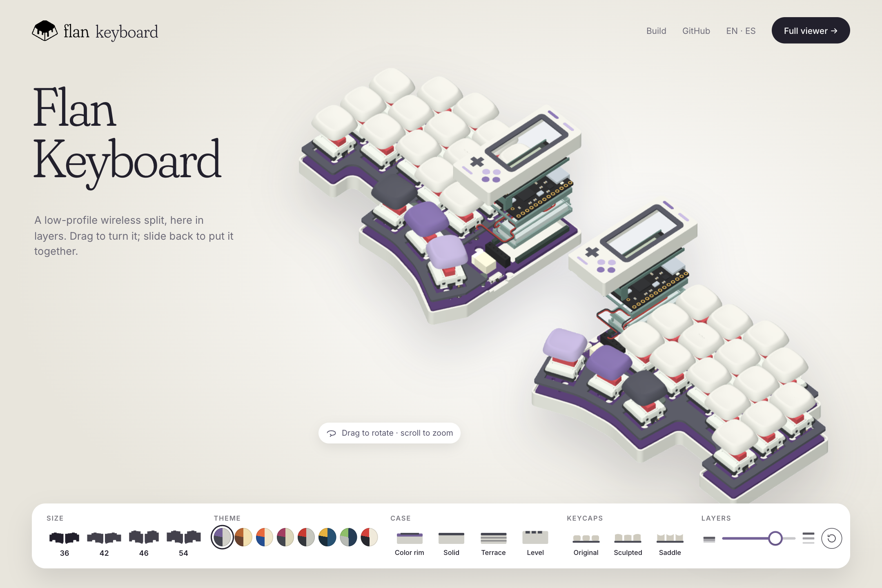
design/proposals/home-r3/a-dock.png
