eduarbo/flan/design/proposals/home-r3/assets/anim-1.png

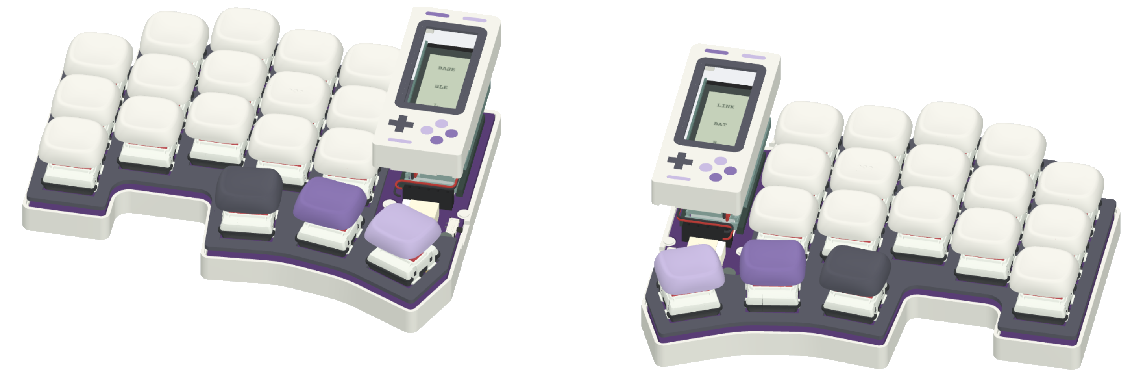
design/proposals/home-r3/assets/anim-1.png
