eduarbo/flan/design/proposals/home-r3/assets/anim-2.png

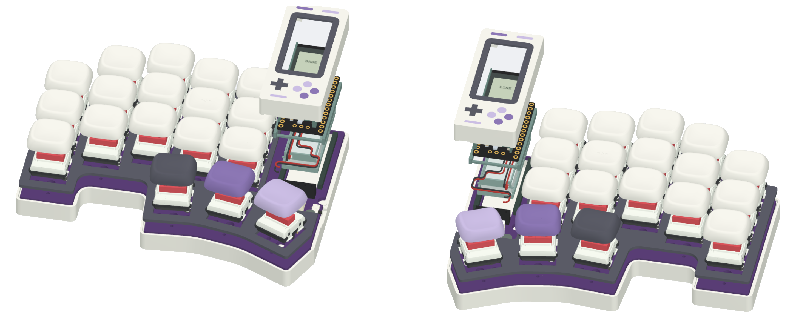
design/proposals/home-r3/assets/anim-2.png
