eduarbo/flan/design/proposals/home-r3/assets/anim-3.png

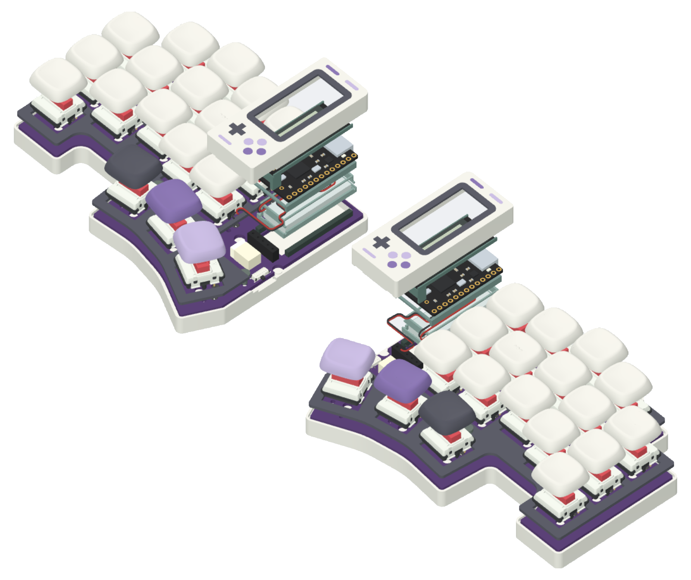
design/proposals/home-r3/assets/anim-3.png
