eduarbo/flan/design/proposals/home-r3/b-rail.png

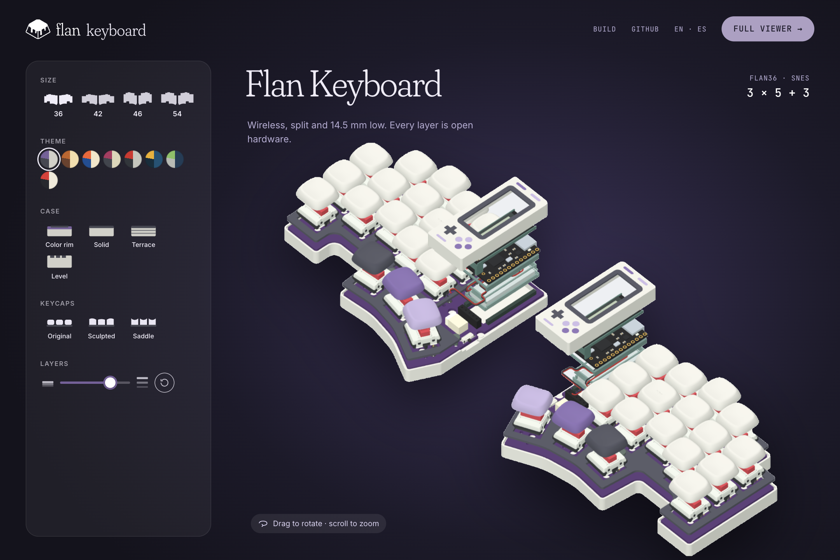
design/proposals/home-r3/b-rail.png
