eduarbo/flan/design/proposals/home-r3/c-immersive.png

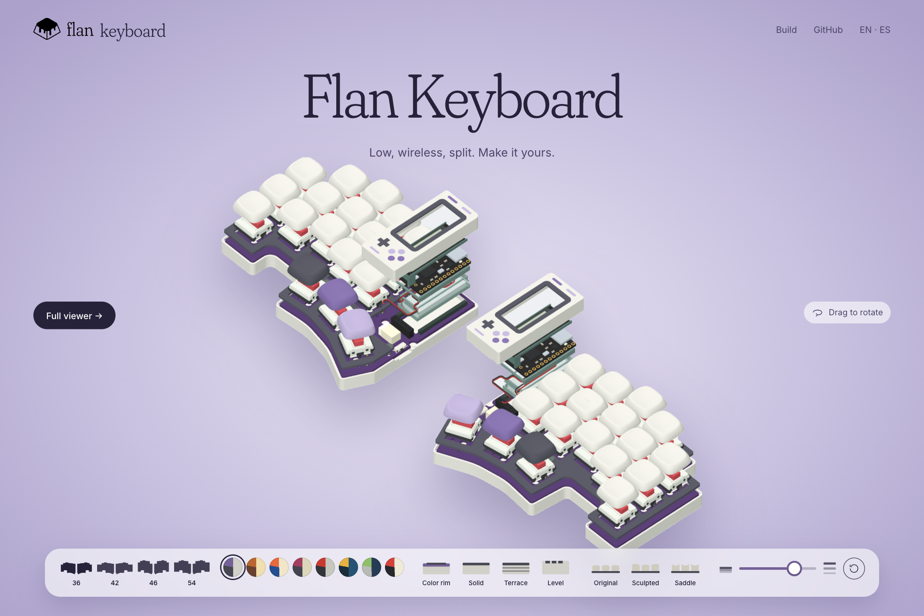
design/proposals/home-r3/c-immersive.png
