eduarbo/flan/design/proposals/home-r3/d-storyboard.png

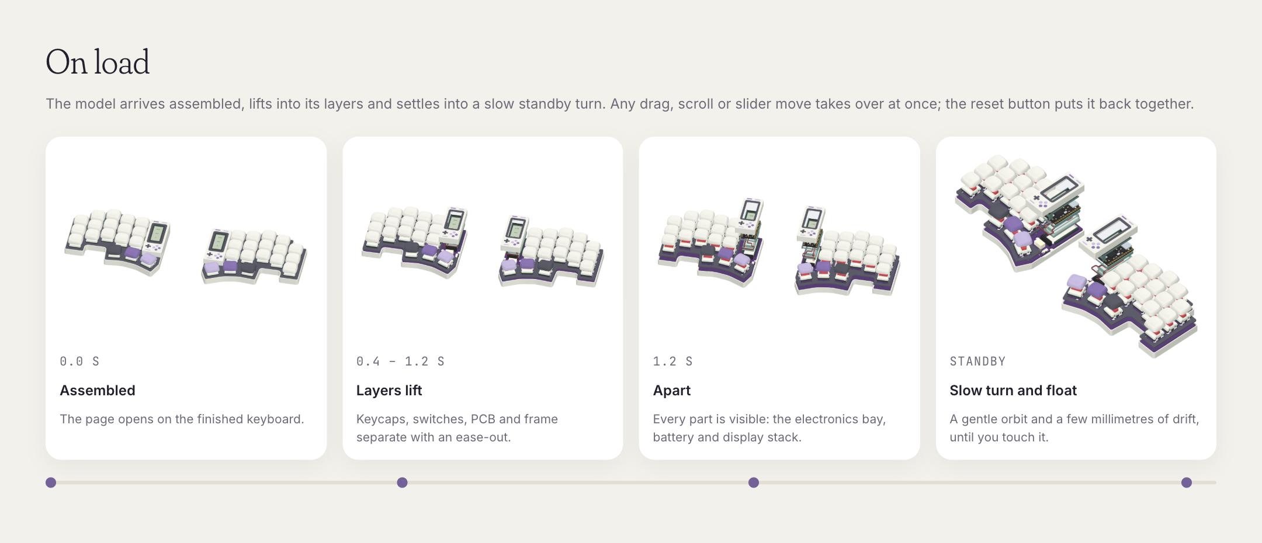
design/proposals/home-r3/d-storyboard.png
