eduarbo/flan/design/proposals/home-r3/e-phone.png

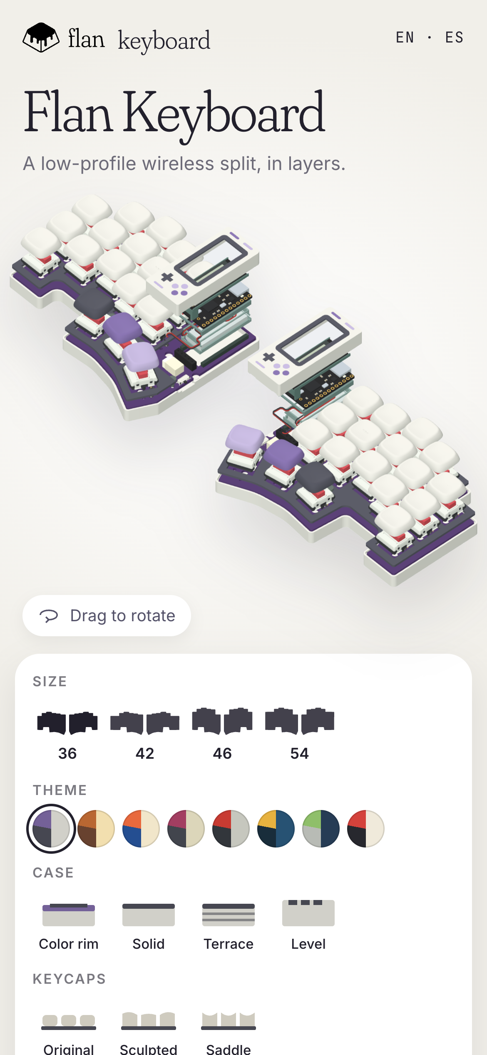
design/proposals/home-r3/e-phone.png
