eduarbo/flan/design/proposals/home-r4/assets/case-gameboy-level.png

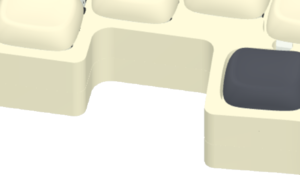
design/proposals/home-r4/assets/case-gameboy-level.png
