eduarbo/flan/design/proposals/home-r4/assets/case-gameboy-rim.png

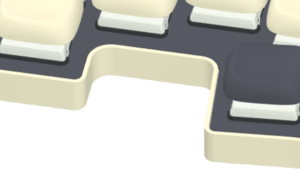
design/proposals/home-r4/assets/case-gameboy-rim.png
