eduarbo/flan/design/proposals/home-r4/assets/case-snes-level.png

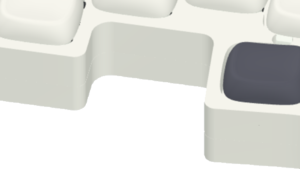
design/proposals/home-r4/assets/case-snes-level.png
