eduarbo/flan/design/proposals/home-r4/assets/frame-gameboy-gameboy.png

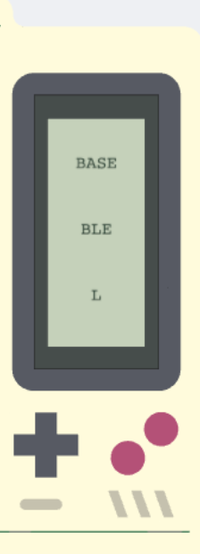
design/proposals/home-r4/assets/frame-gameboy-gameboy.png
