eduarbo/flan/design/proposals/home-r4/assets/frame-gameboy-hanafuda.png

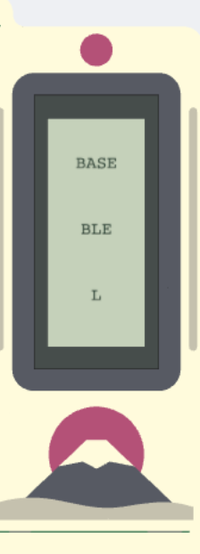
design/proposals/home-r4/assets/frame-gameboy-hanafuda.png
