eduarbo/flan/design/proposals/home-r4/assets/frame-gameboy-ipod.png

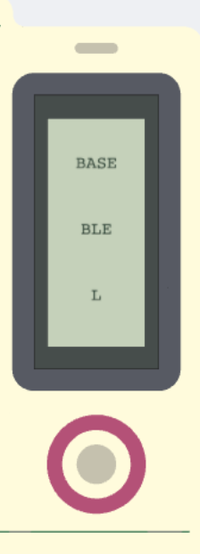
design/proposals/home-r4/assets/frame-gameboy-ipod.png
