eduarbo/flan/design/proposals/home-r4/assets/frame-gameboy-phone.png

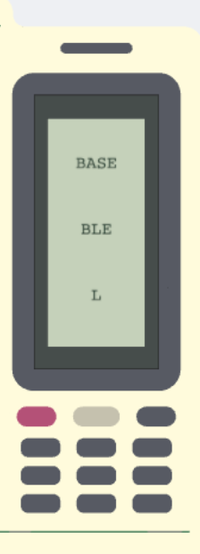
design/proposals/home-r4/assets/frame-gameboy-phone.png
