eduarbo/flan/design/proposals/home-r4/assets/frame-gameboy-snes.png

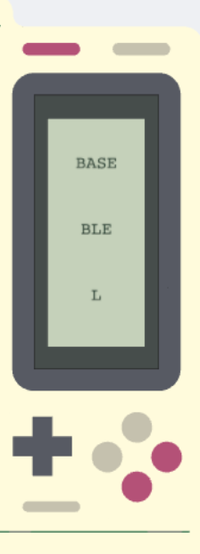
design/proposals/home-r4/assets/frame-gameboy-snes.png
