eduarbo/flan/design/proposals/home-r4/assets/frame-gameboy-talavera.png

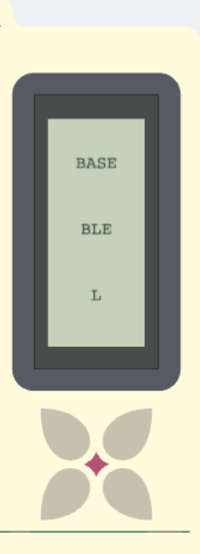
design/proposals/home-r4/assets/frame-gameboy-talavera.png
