eduarbo/flan/design/proposals/home-r4/assets/frame-snes-gameboy.png

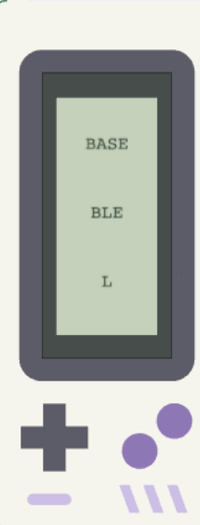
design/proposals/home-r4/assets/frame-snes-gameboy.png
