eduarbo/flan/design/proposals/home-r4/assets/frame-snes-hanafuda.png

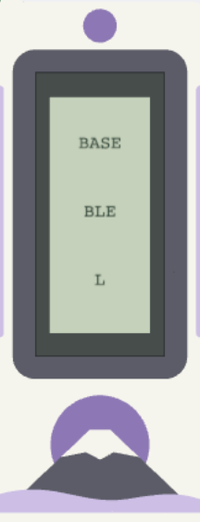
design/proposals/home-r4/assets/frame-snes-hanafuda.png
