eduarbo/flan/design/proposals/home-r4/assets/frame-snes-ipod.png

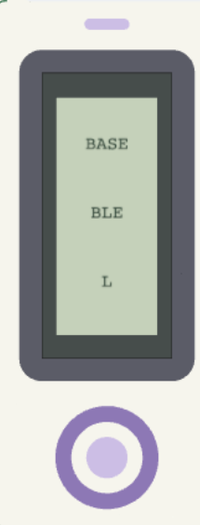
design/proposals/home-r4/assets/frame-snes-ipod.png
