eduarbo/flan/design/proposals/home-r4/assets/frame-snes-phone.png

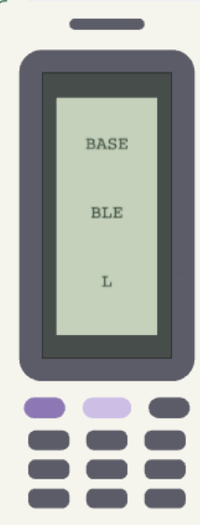
design/proposals/home-r4/assets/frame-snes-phone.png
