eduarbo/flan/design/proposals/home-r4/assets/size-gameboy-flan36.png

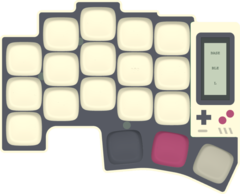
design/proposals/home-r4/assets/size-gameboy-flan36.png
