eduarbo/flan/design/proposals/home-r4/assets/size-gameboy-flan42.png

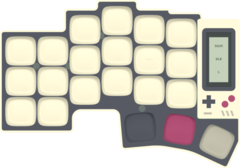
design/proposals/home-r4/assets/size-gameboy-flan42.png
