eduarbo/flan/design/proposals/home-r4/assets/size-gameboy-flan46.png

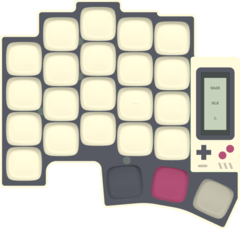
design/proposals/home-r4/assets/size-gameboy-flan46.png
