eduarbo/flan/design/proposals/home-r4/assets/size-gameboy-flan54.png

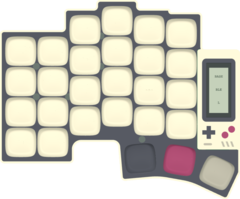
design/proposals/home-r4/assets/size-gameboy-flan54.png
