eduarbo/flan/design/proposals/home-r4/assets/size-snes-flan42.png

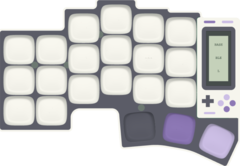
design/proposals/home-r4/assets/size-snes-flan42.png
