eduarbo/flan/design/proposals/home-r4/assets/size-snes-flan54.png

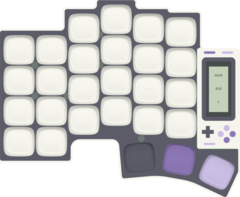
design/proposals/home-r4/assets/size-snes-flan54.png
