eduarbo/flan/design/proposals/silkscreen-r1/barrido-left-front.png

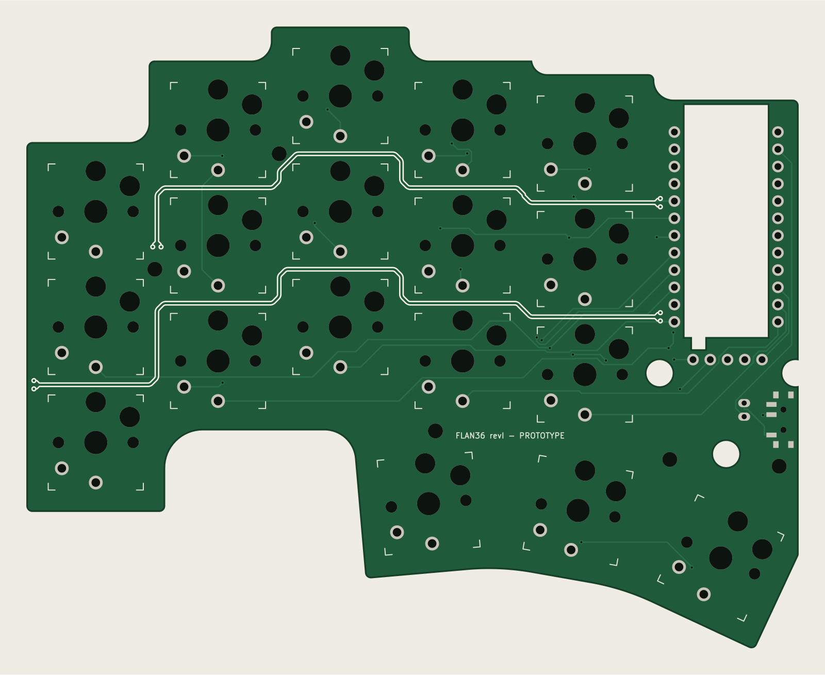
design/proposals/silkscreen-r1/barrido-left-front.png
