eduarbo/flan/design/proposals/silkscreen-r1/barrido-right-front.png

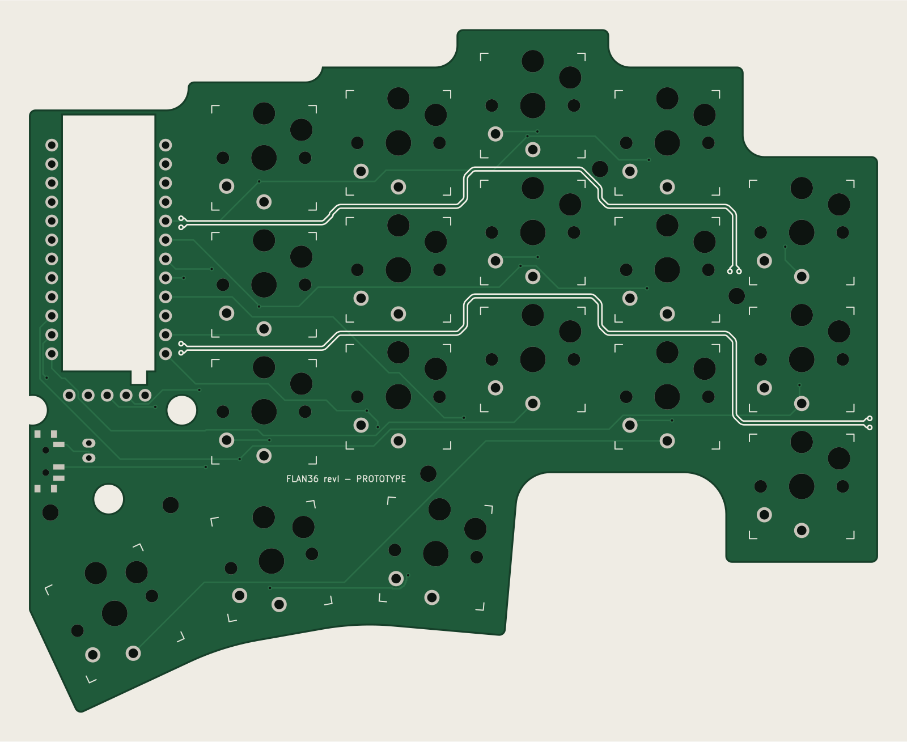
design/proposals/silkscreen-r1/barrido-right-front.png
