eduarbo/flan/design/proposals/silkscreen-r1/caramelo-left-front.png

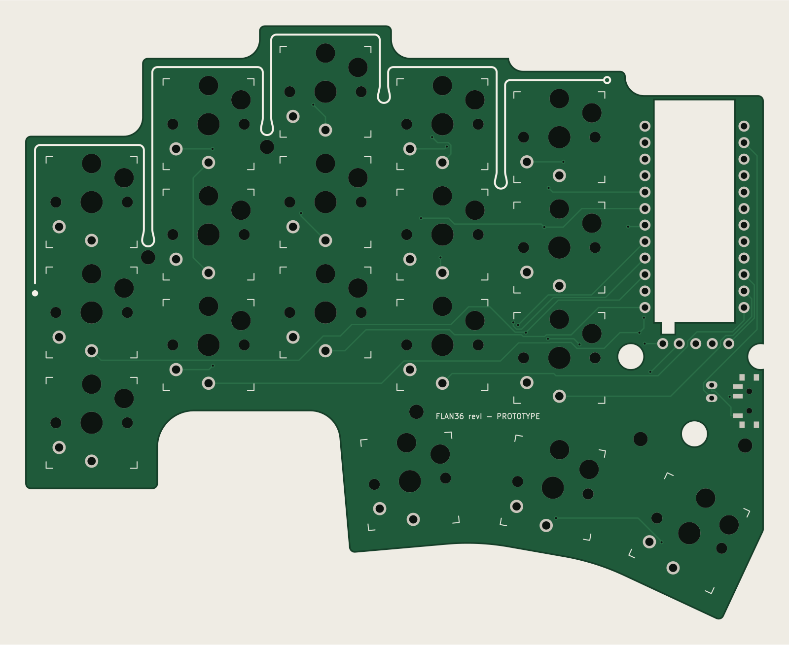
design/proposals/silkscreen-r1/caramelo-left-front.png
