eduarbo/flan/design/proposals/silkscreen-r1/contorno-left-front.png

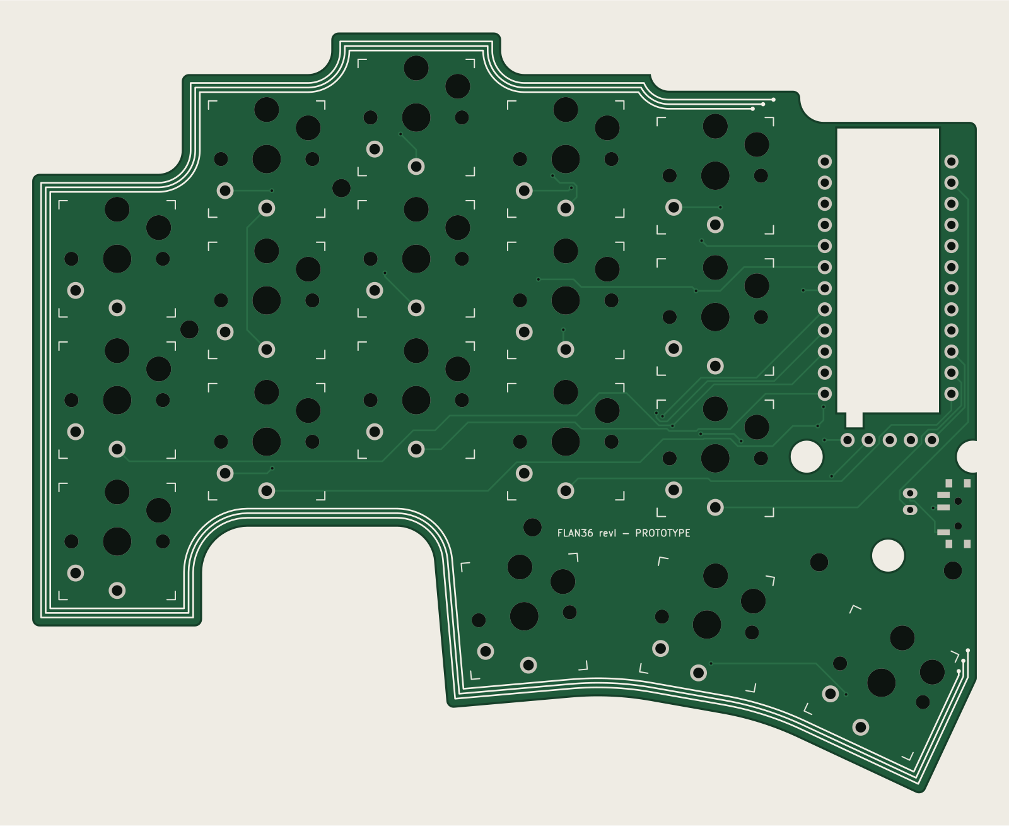
design/proposals/silkscreen-r1/contorno-left-front.png
