eduarbo/flan/design/proposals/silkscreen-r1/contorno-right-front.png

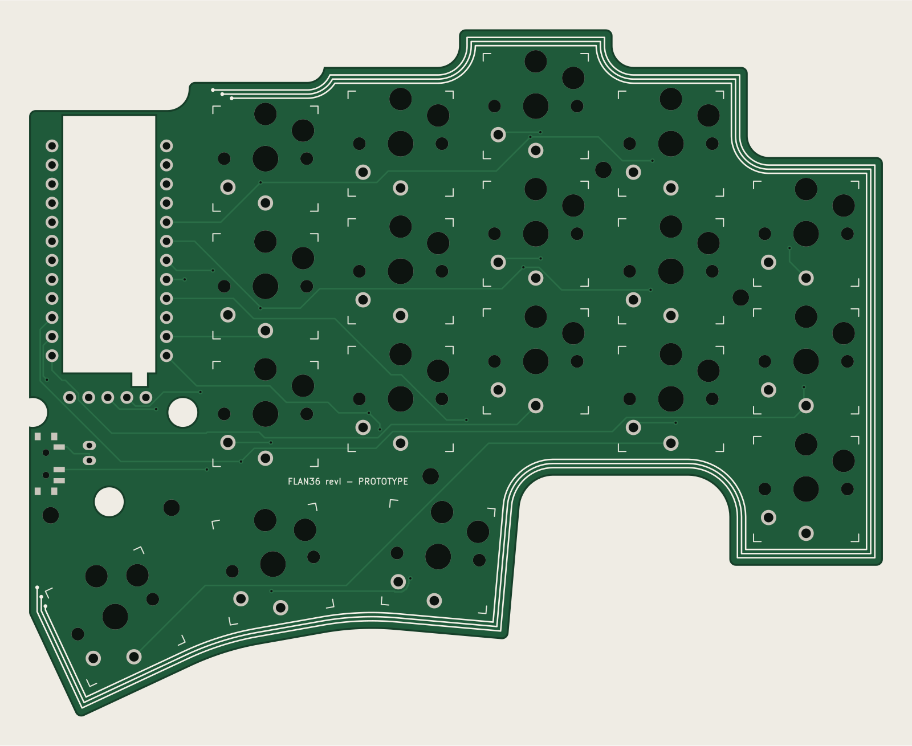
design/proposals/silkscreen-r1/contorno-right-front.png
