eduarbo/flan/design/proposals/silkscreen-r1/plate-left-back.png

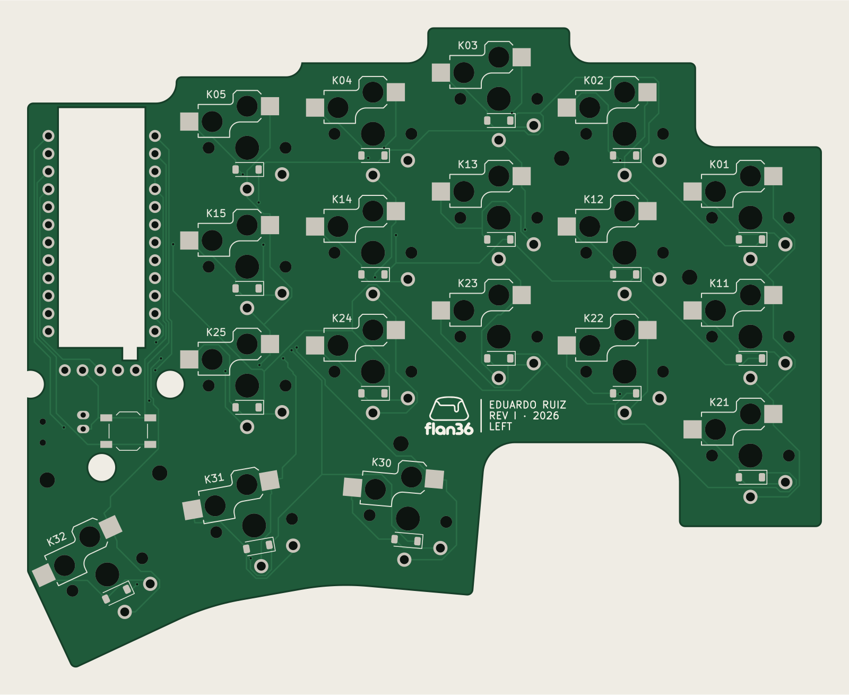
design/proposals/silkscreen-r1/plate-left-back.png
