eduarbo/flan/design/proposals/silkscreen-r1/plate-right-back.png

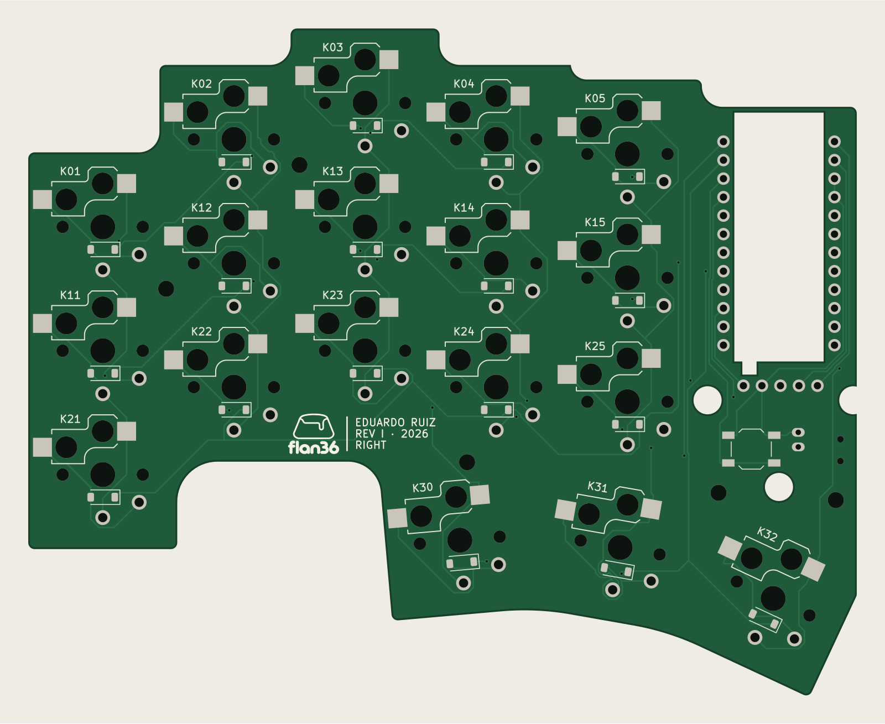
design/proposals/silkscreen-r1/plate-right-back.png
