eduarbo/flan/docs/assets/home-poster-800.webp

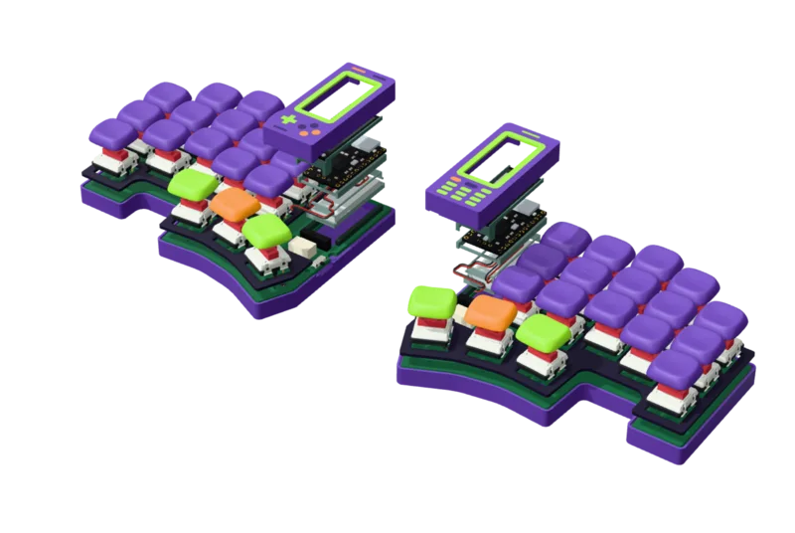
docs/assets/home-poster-800.webp
