eduarbo/flan/docs/images/editions/flan42/meandro.png

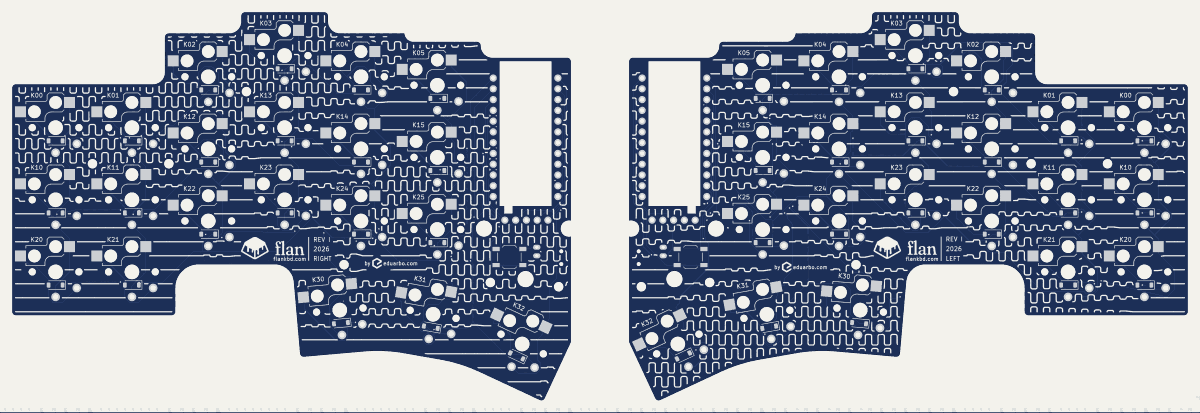
docs/images/editions/flan42/meandro.png
