eduarbo/flan/docs/images/editions/flan42/vias.png

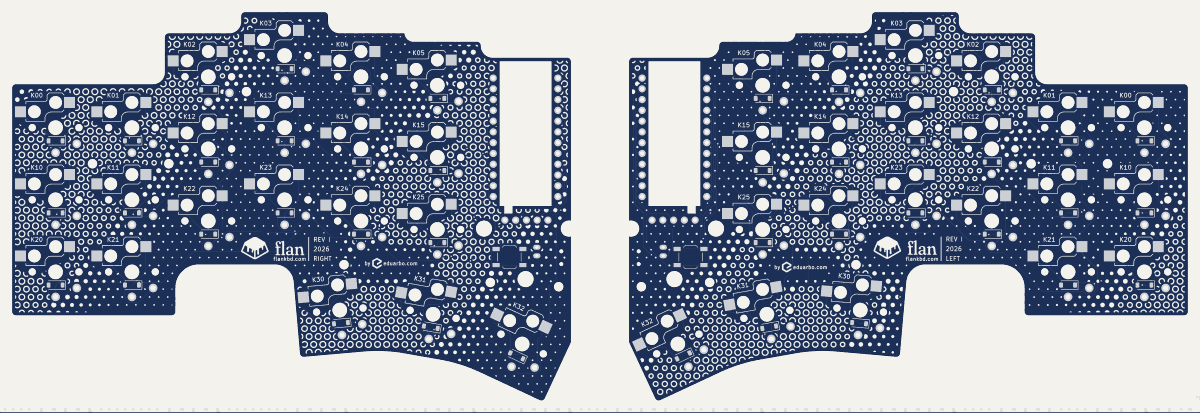
docs/images/editions/flan42/vias.png
