eduarbo/flan/docs/images/editions/flan46/kikko.png

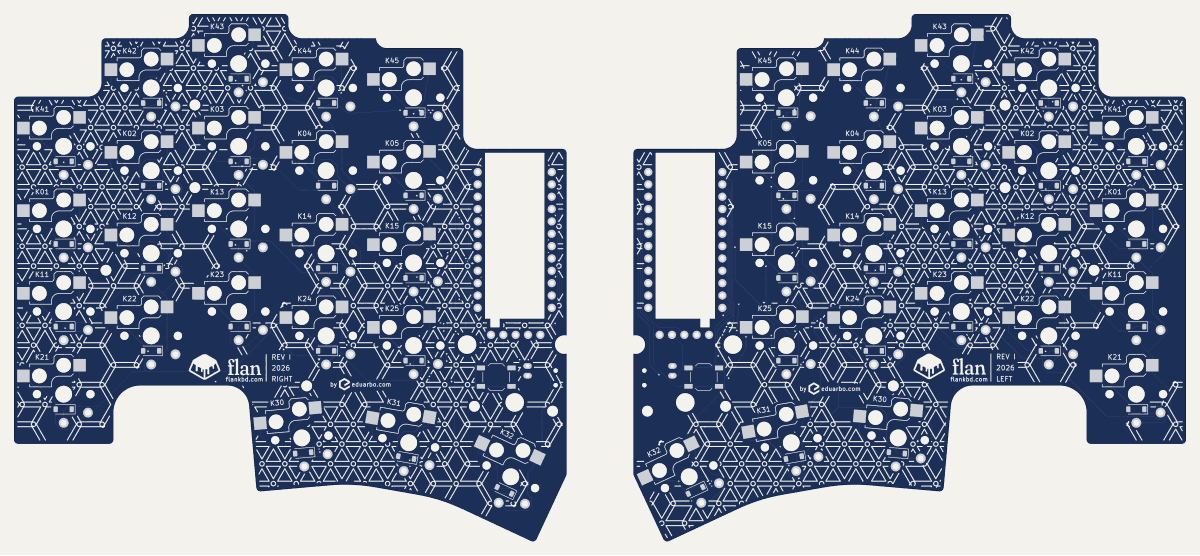
docs/images/editions/flan46/kikko.png
