eduarbo/flan/docs/images/editions/flan54/seigaiha.png

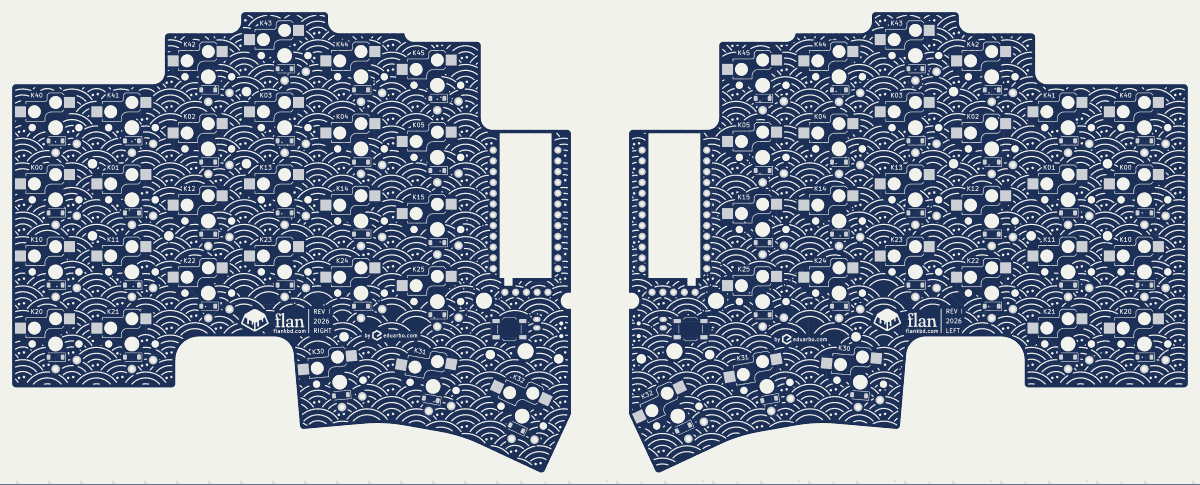
docs/images/editions/flan54/seigaiha.png
