eduarbo/flan/docs/images/editions/flan54/vias.png

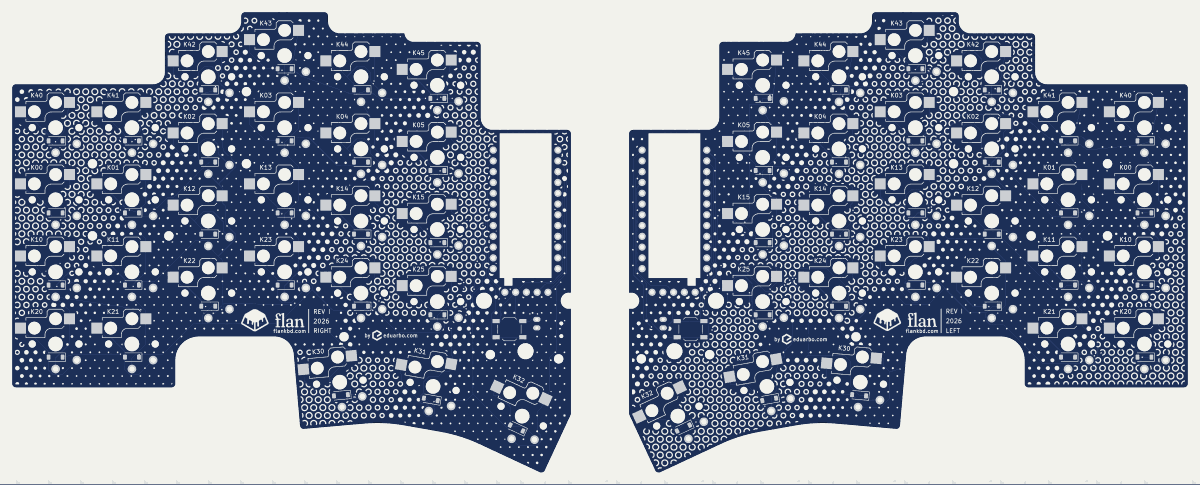
docs/images/editions/flan54/vias.png
