eduarbo/flan/docs/images/revI-detail.png

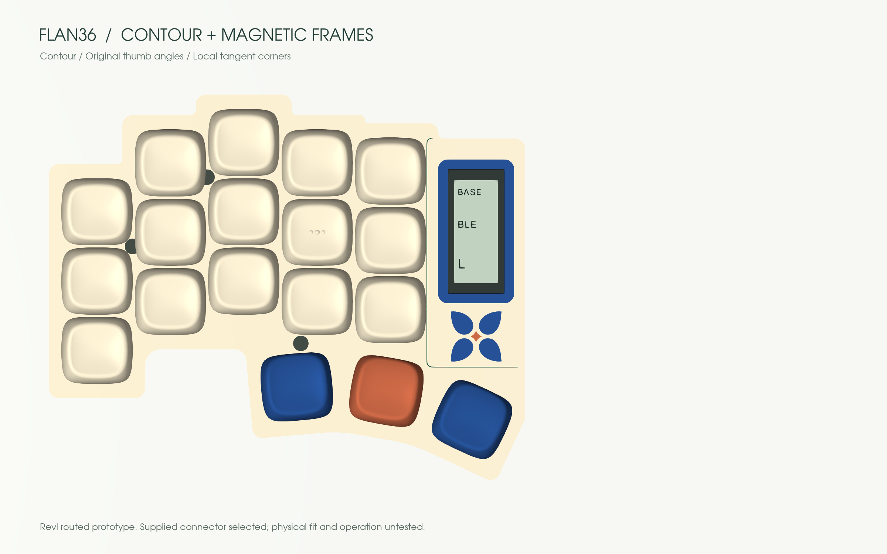
docs/images/revI-detail.png
