eduarbo/flan/docs/images/showcase/flan36/flan-original-level.webp

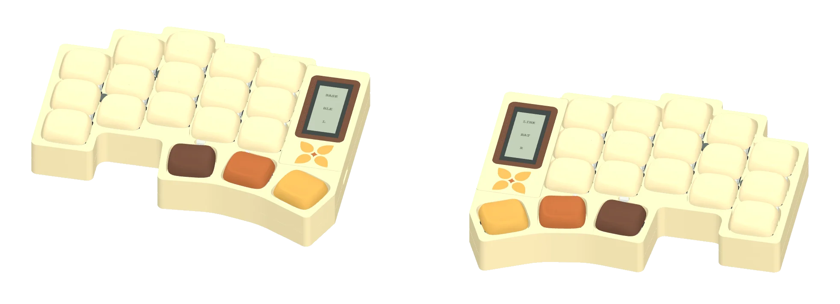
docs/images/showcase/flan36/flan-original-level.webp
