eduarbo/flan/docs/images/showcase/flan36/flan-original-solid.webp

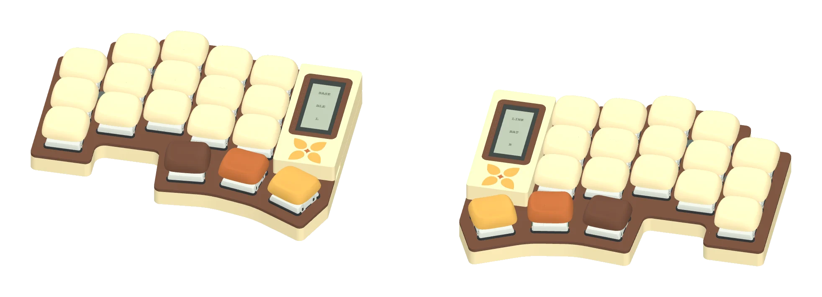
docs/images/showcase/flan36/flan-original-solid.webp
