eduarbo/flan/docs/images/showcase/flan36/flan-saddle-level.webp

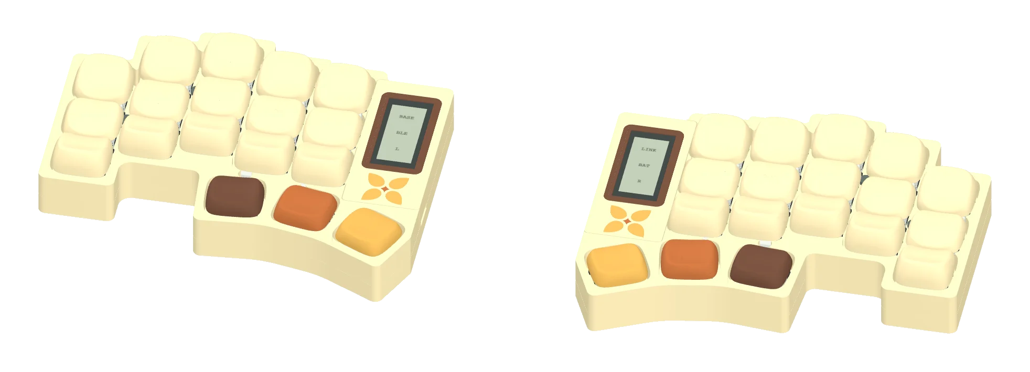
docs/images/showcase/flan36/flan-saddle-level.webp
