eduarbo/flan/docs/images/showcase/flan36/phone-normal-rim.webp

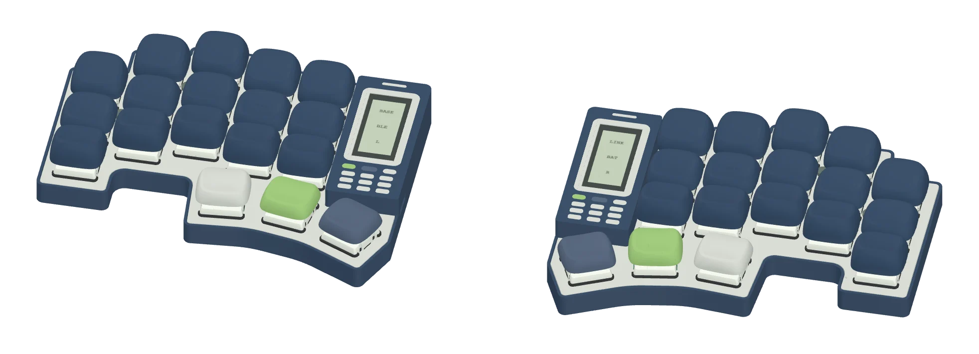
docs/images/showcase/flan36/phone-normal-rim.webp
