eduarbo/flan/docs/images/showcase/flan36/phone-saddle-level.webp

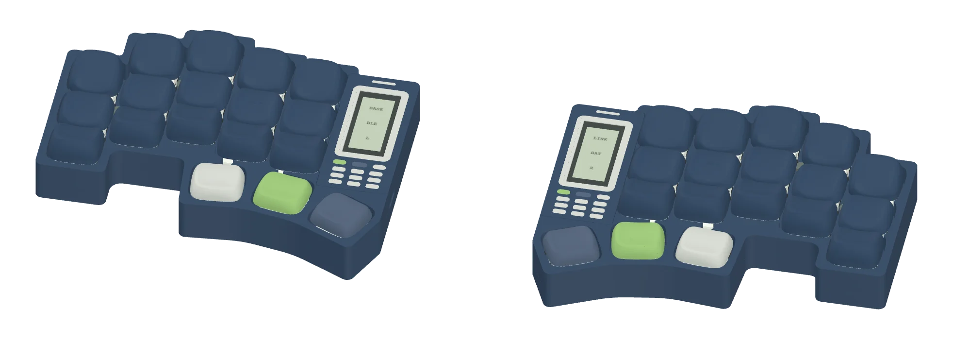
docs/images/showcase/flan36/phone-saddle-level.webp
