eduarbo/flan/docs/images/showcase/flan36/walkman-original-rim.webp

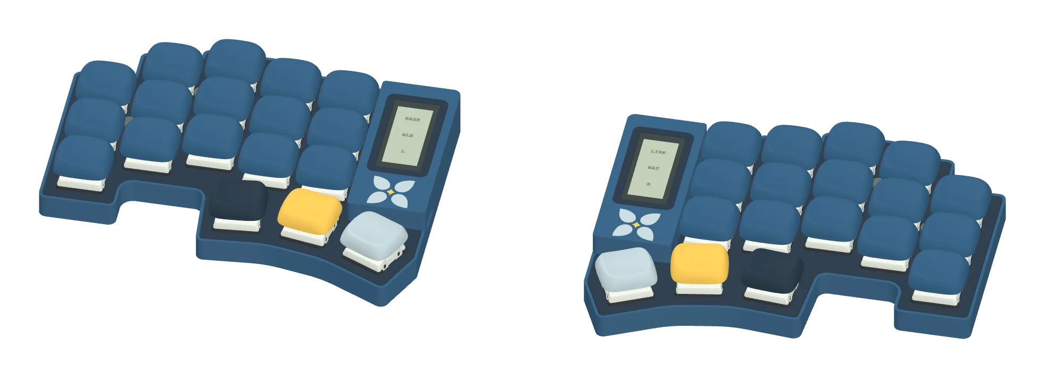
docs/images/showcase/flan36/walkman-original-rim.webp
