eduarbo/flan/docs/images/showcase/flan42/flan-normal-solid.webp

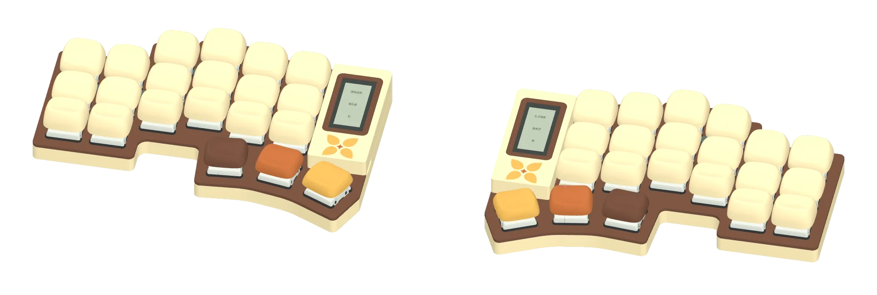
docs/images/showcase/flan42/flan-normal-solid.webp
