eduarbo/flan/docs/images/showcase/flan42/flan-original-level.webp

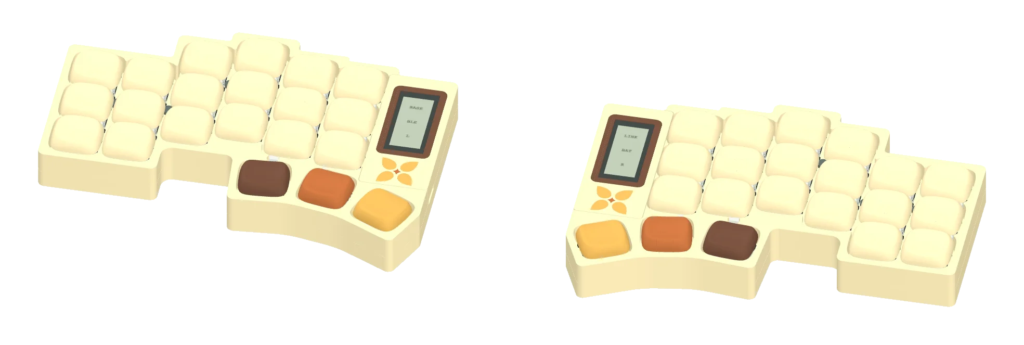
docs/images/showcase/flan42/flan-original-level.webp
