eduarbo/flan/docs/images/showcase/flan42/phone-normal-rim.webp

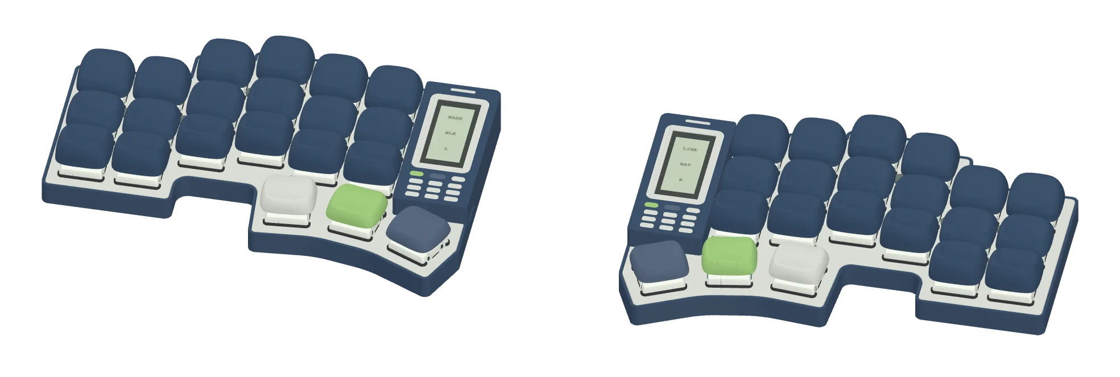
docs/images/showcase/flan42/phone-normal-rim.webp
