eduarbo/flan/docs/images/showcase/flan42/walkman-original-level.webp

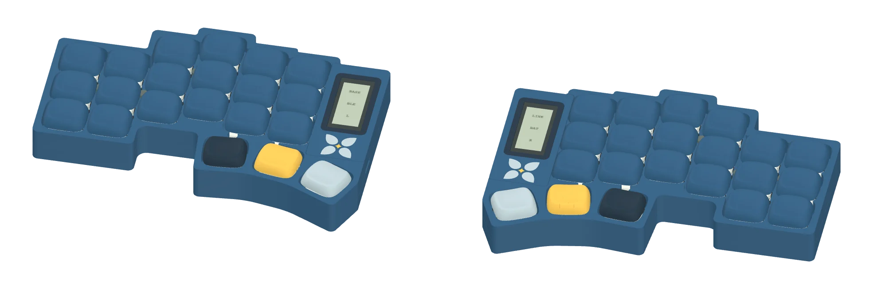
docs/images/showcase/flan42/walkman-original-level.webp
