eduarbo/flan/docs/images/showcase/flan46/flan-normal-level.webp

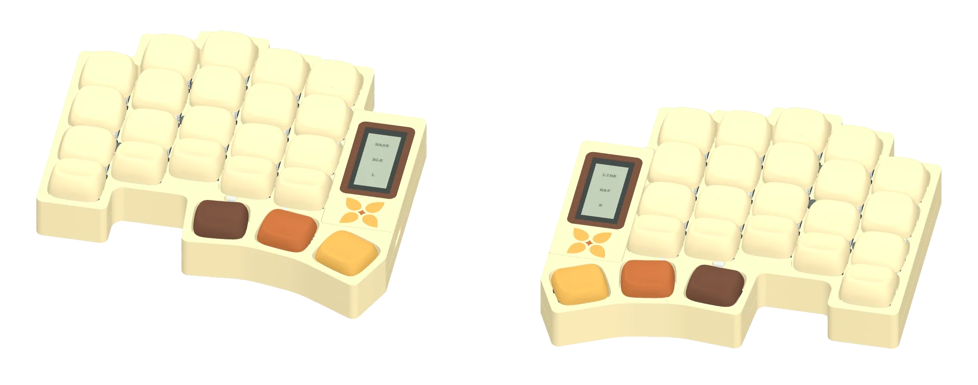
docs/images/showcase/flan46/flan-normal-level.webp
