eduarbo/flan/docs/images/showcase/flan46/gameboy-normal-terrace.webp

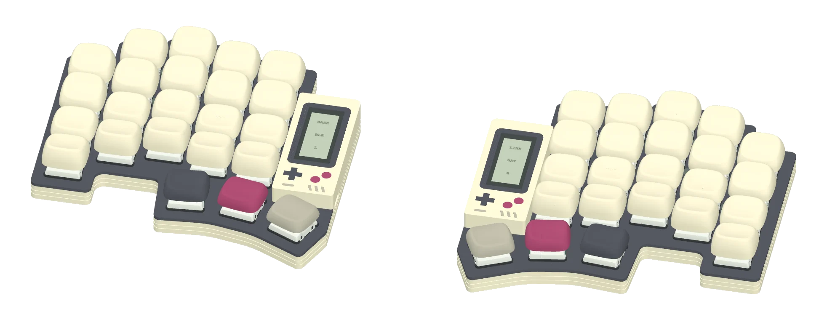
docs/images/showcase/flan46/gameboy-normal-terrace.webp
