eduarbo/flan/docs/images/showcase/flan46/phone-saddle-level.webp

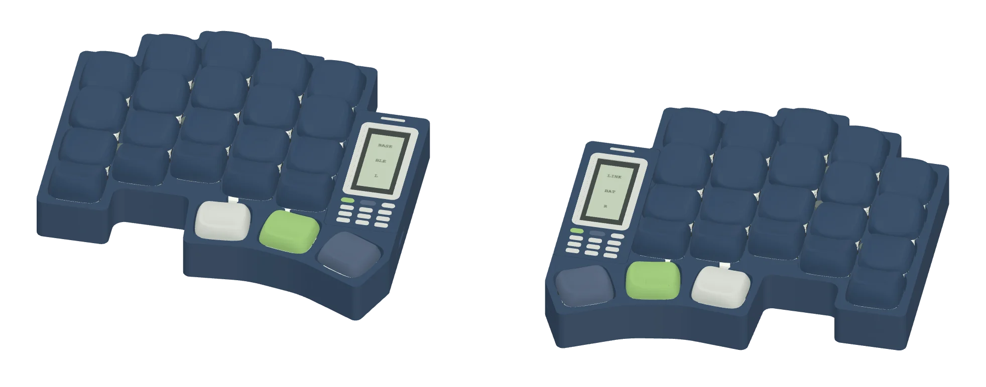
docs/images/showcase/flan46/phone-saddle-level.webp
