eduarbo/flan/docs/images/showcase/flan46/phone-saddle-solid.webp

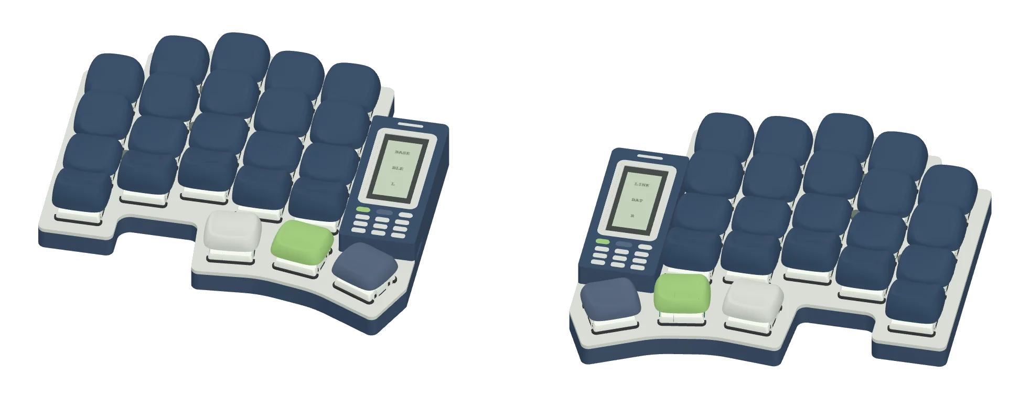
docs/images/showcase/flan46/phone-saddle-solid.webp
