eduarbo/flan/docs/images/showcase/flan46/talavera-normal-level.webp

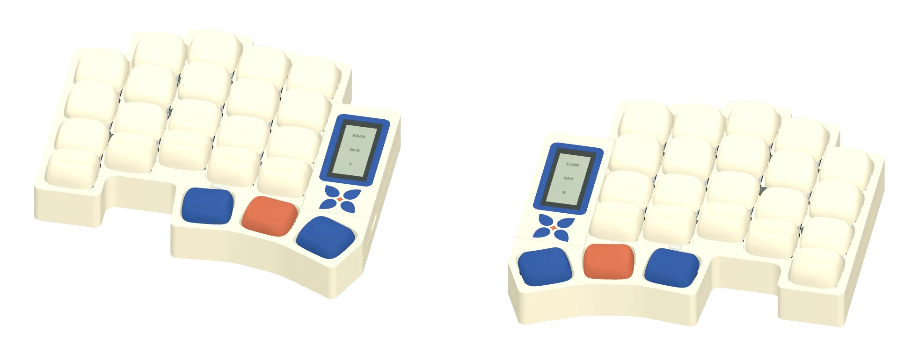
docs/images/showcase/flan46/talavera-normal-level.webp
