eduarbo/flan/docs/images/showcase/flan54/flan-original-terrace.webp

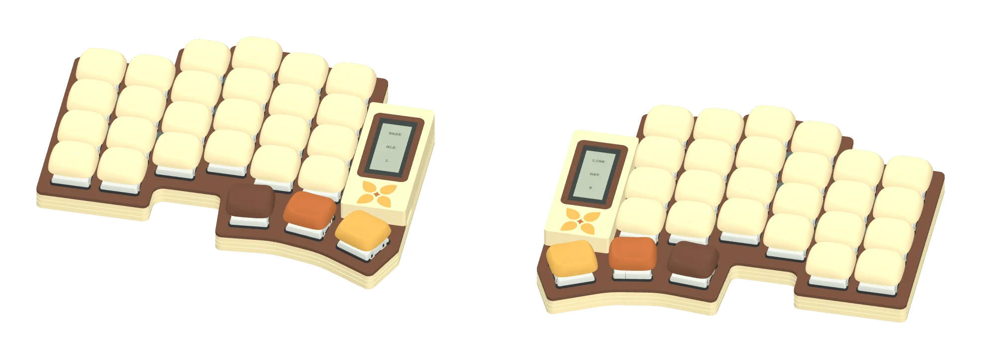
docs/images/showcase/flan54/flan-original-terrace.webp
