eduarbo/flan/docs/images/showcase/flan54/gameboy-saddle-level.webp

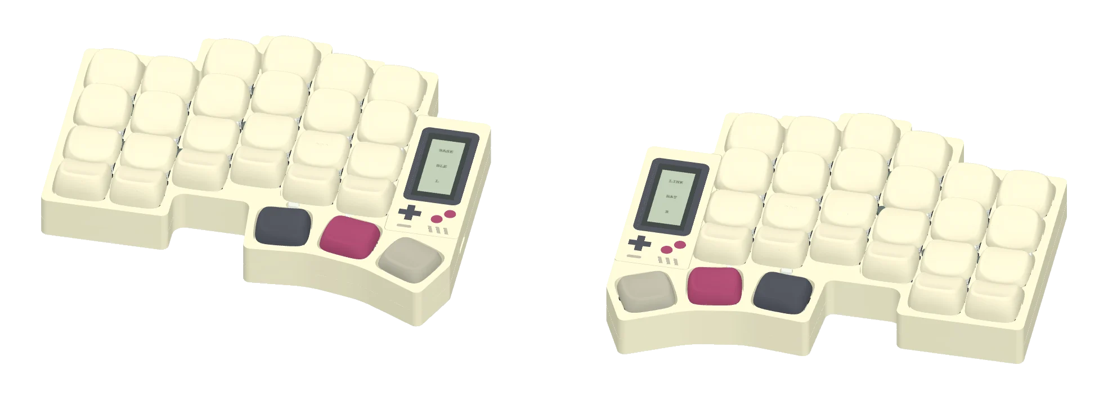
docs/images/showcase/flan54/gameboy-saddle-level.webp
