eduarbo/flan/docs/images/showcase/flan54/phone-normal-rim.webp

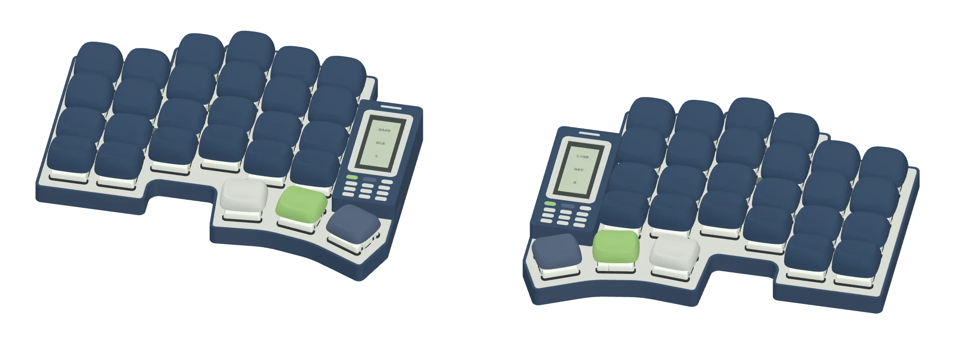
docs/images/showcase/flan54/phone-normal-rim.webp
