eduarbo/flan/docs/images/showcase/flan54/snes-original-level.webp

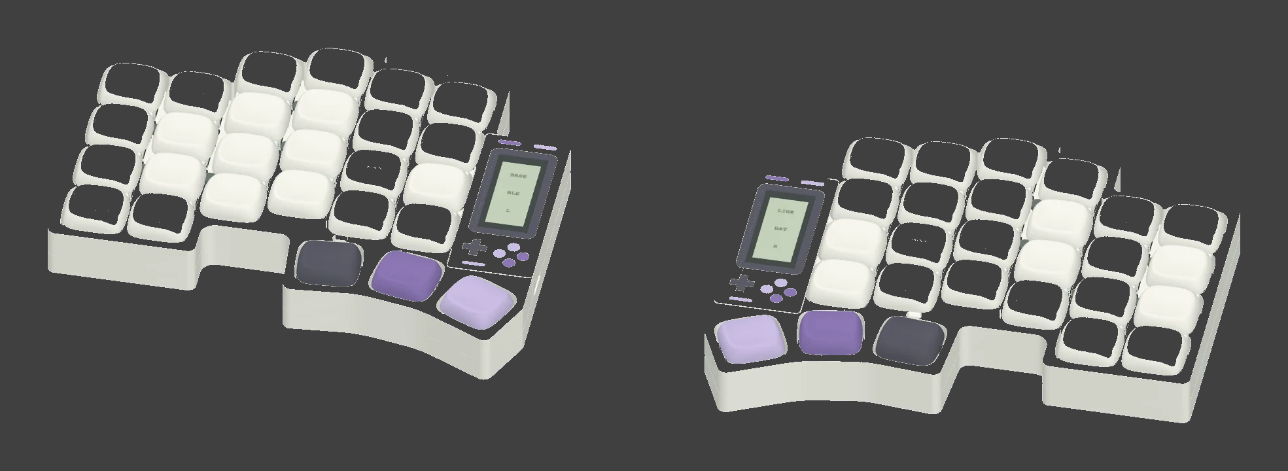
docs/images/showcase/flan54/snes-original-level.webp
