eduarbo/flan/docs/marketing/assets/carousel-en-2.png

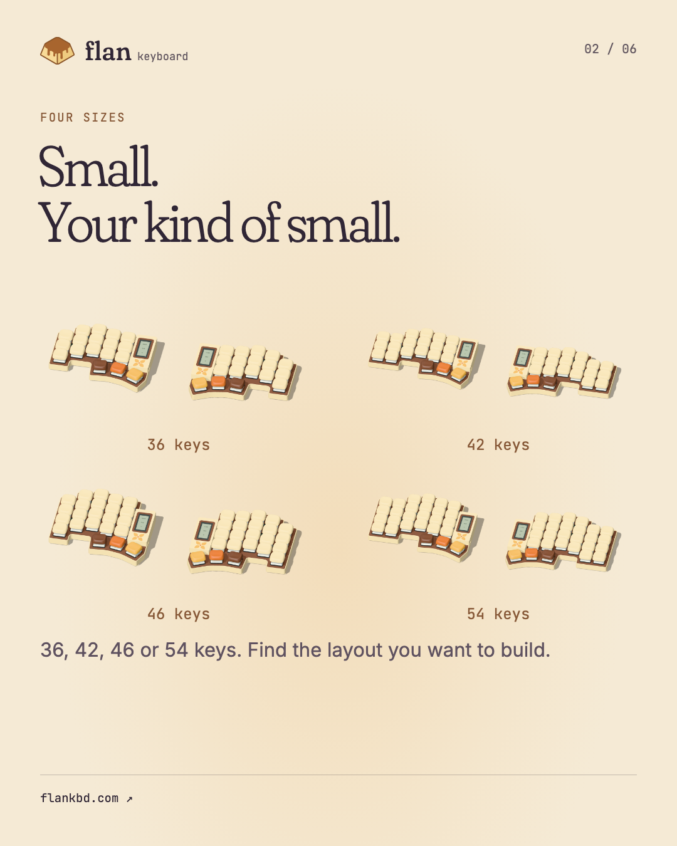
docs/marketing/assets/carousel-en-2.png
