eduarbo/flan/docs/marketing/assets/carousel-es-2.png

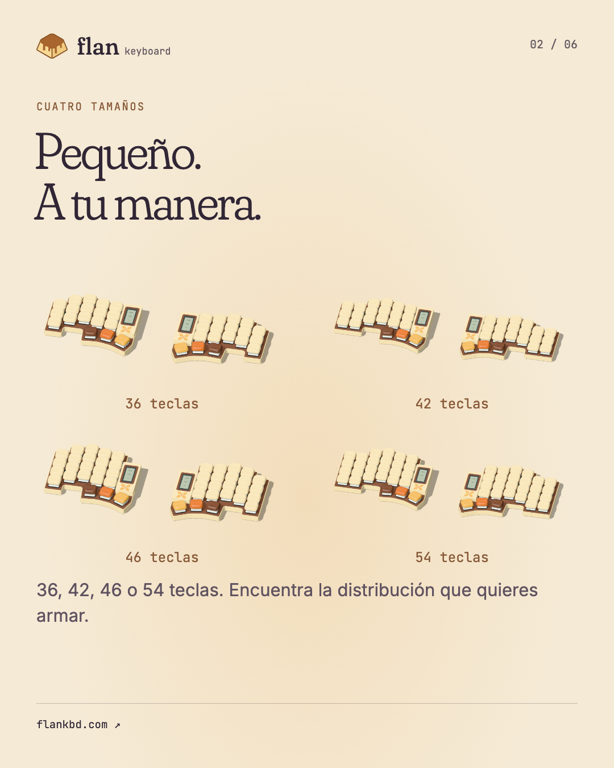
docs/marketing/assets/carousel-es-2.png
