eduarbo/flan/docs/marketing/assets/carousel-es-3.png

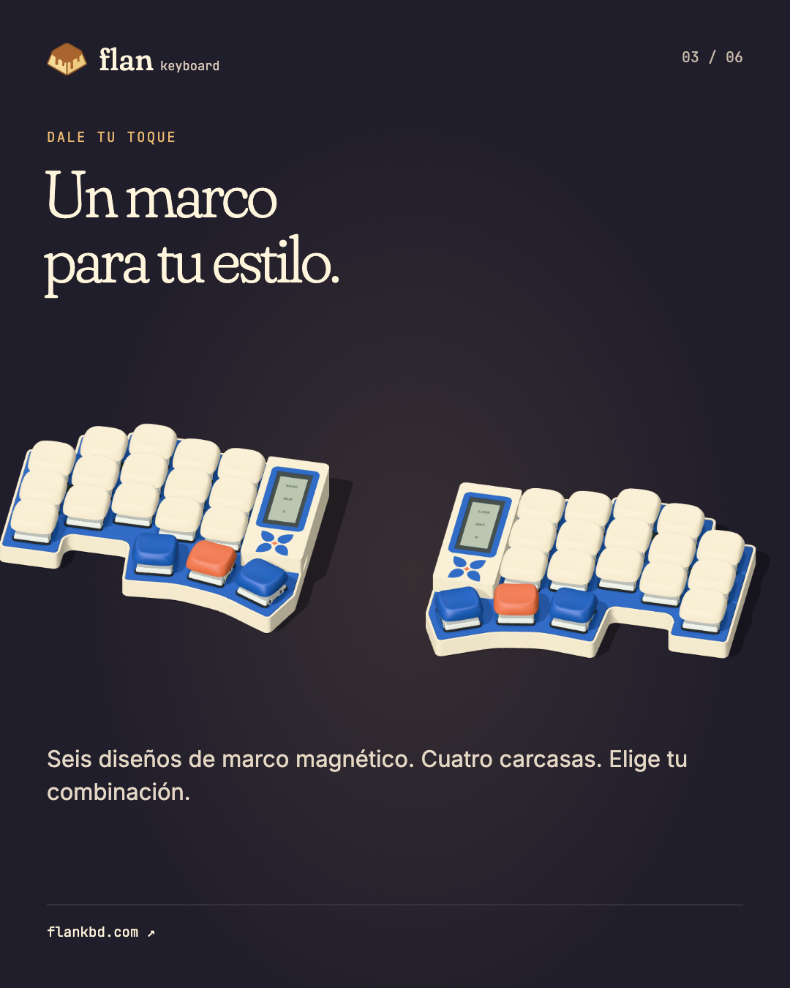
docs/marketing/assets/carousel-es-3.png
