eduarbo/flan/docs/marketing/assets/carousel-es-5.png

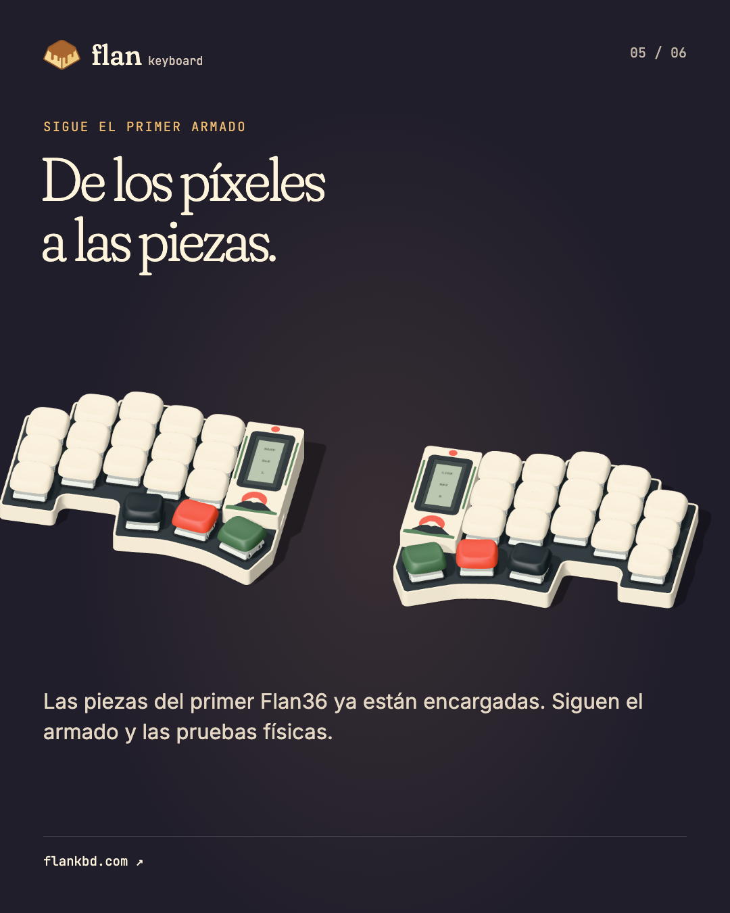
docs/marketing/assets/carousel-es-5.png
