eduarbo/flan/docs/marketing/assets/carousel-es-6.png

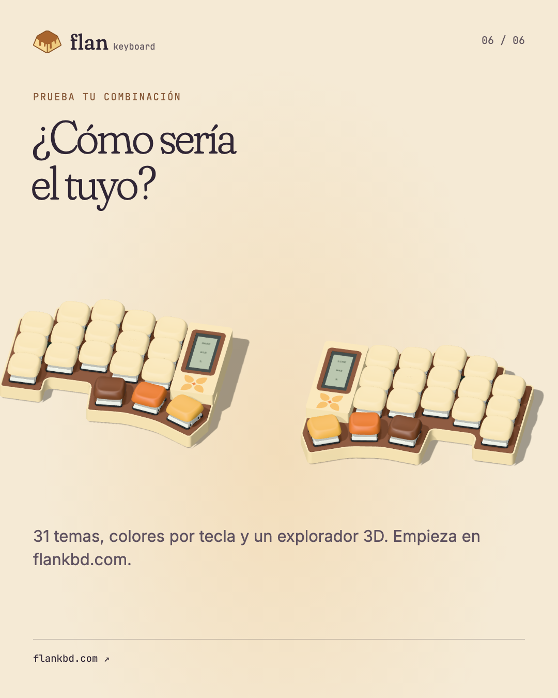
docs/marketing/assets/carousel-es-6.png
