eduarbo/flan/docs/marketing/assets/render-layers.png

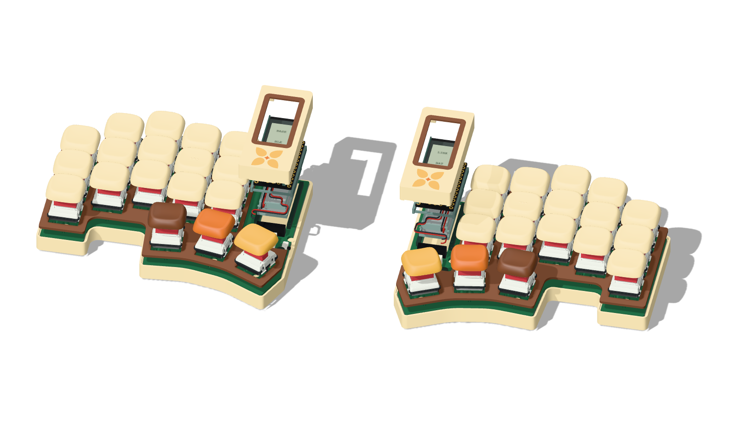
docs/marketing/assets/render-layers.png
