eduarbo/flan/docs/marketing/assets/render-talavera.png

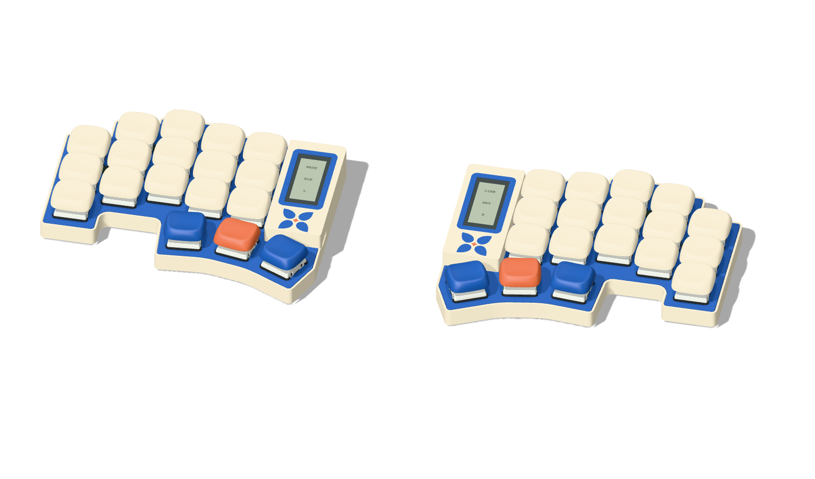
docs/marketing/assets/render-talavera.png
