eduarbo/flan/docs/marketing/assets/square-es.png

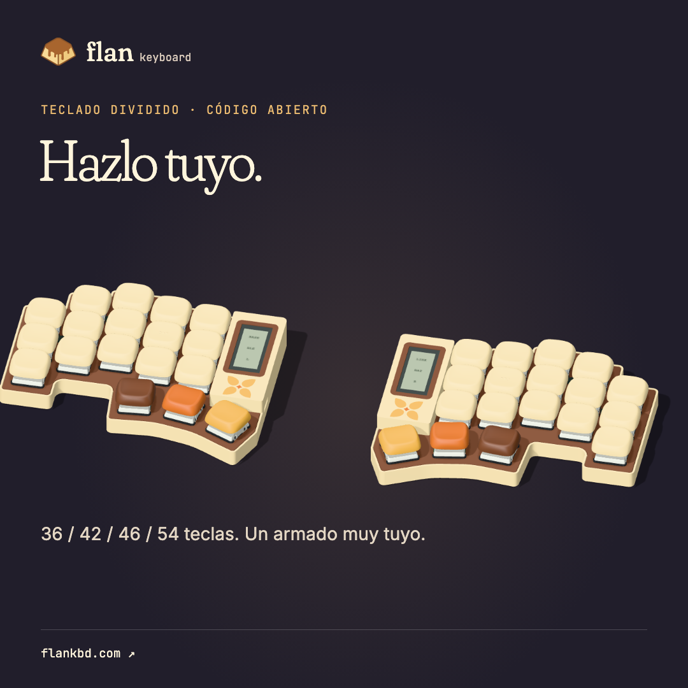
docs/marketing/assets/square-es.png
