eduarbo/flan/docs/marketing/assets/story-es.png

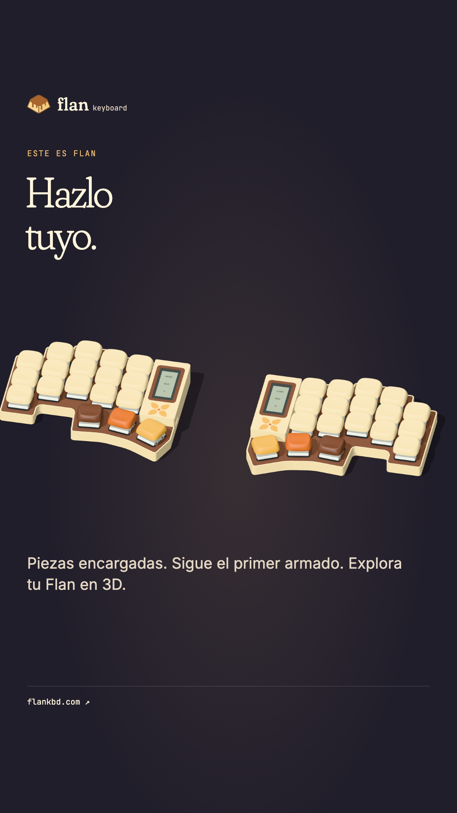
docs/marketing/assets/story-es.png
