eduarbo/flan/docs/marketing/variants/card-matcha-es.png

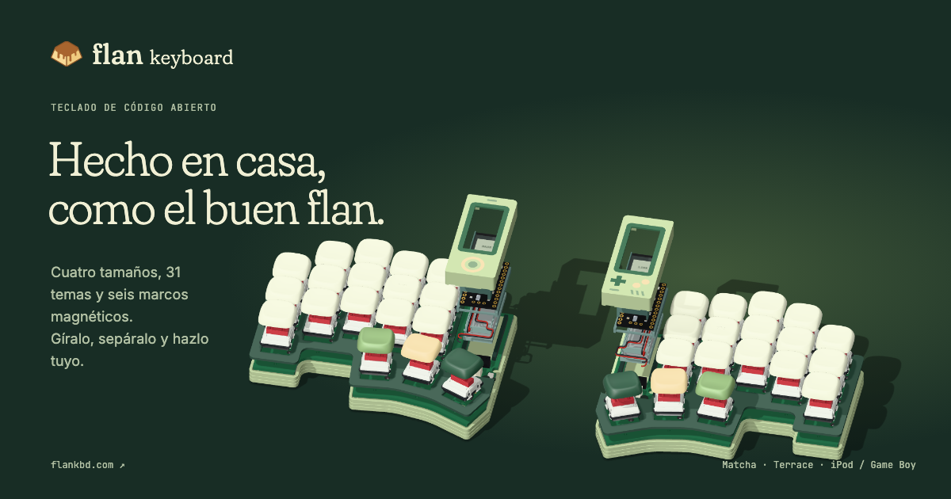
docs/marketing/variants/card-matcha-es.png
