eduarbo/flan/docs/marketing/variants/cover-eva-01-es.png

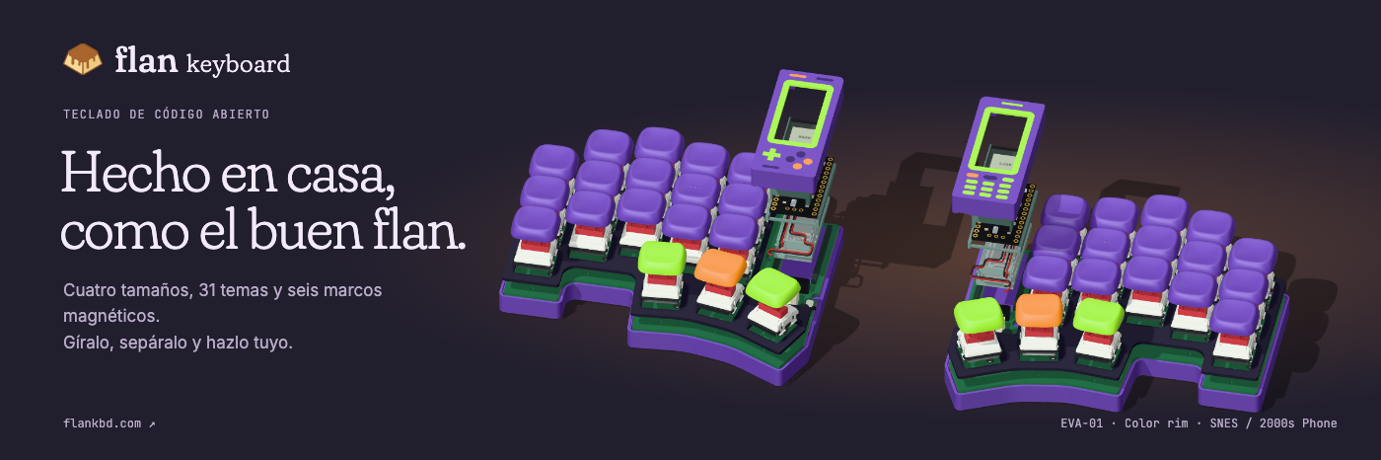
docs/marketing/variants/cover-eva-01-es.png
