eduarbo/flan/docs/marketing/variants/cover-flan-en.png

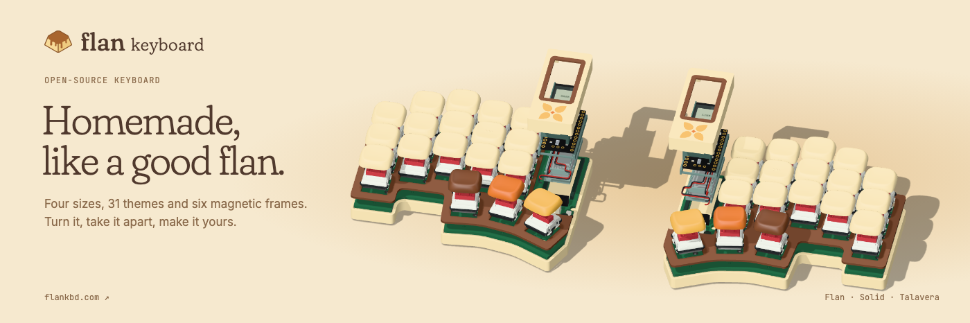
docs/marketing/variants/cover-flan-en.png
