eduarbo/flan/docs/marketing/variants/cover-hanafuda-en.png

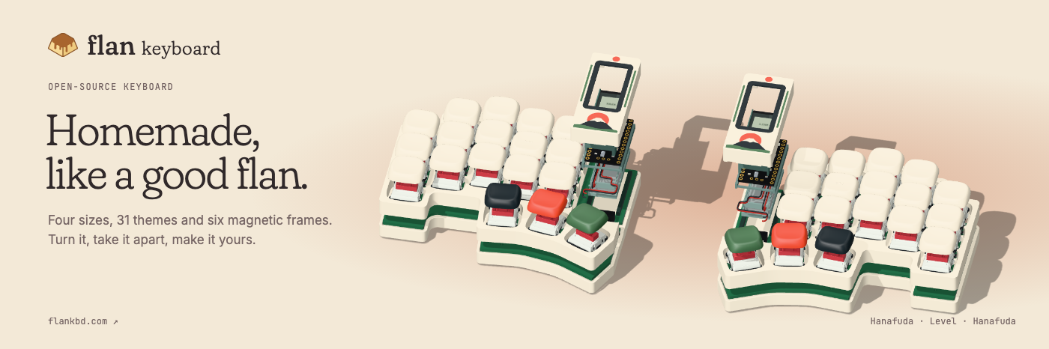
docs/marketing/variants/cover-hanafuda-en.png
