eduarbo/flan/docs/proposals/home-r1/shots/a-desktop-es.png

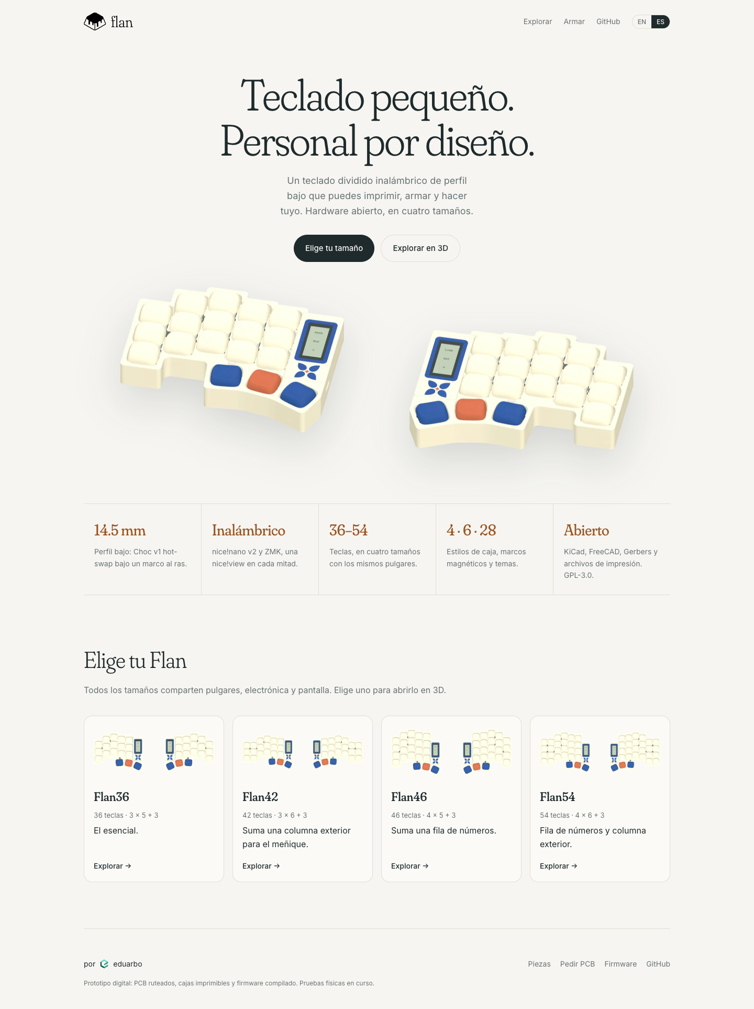
docs/proposals/home-r1/shots/a-desktop-es.png
