eduarbo/flan/docs/proposals/home-r1/shots/a-phone.png

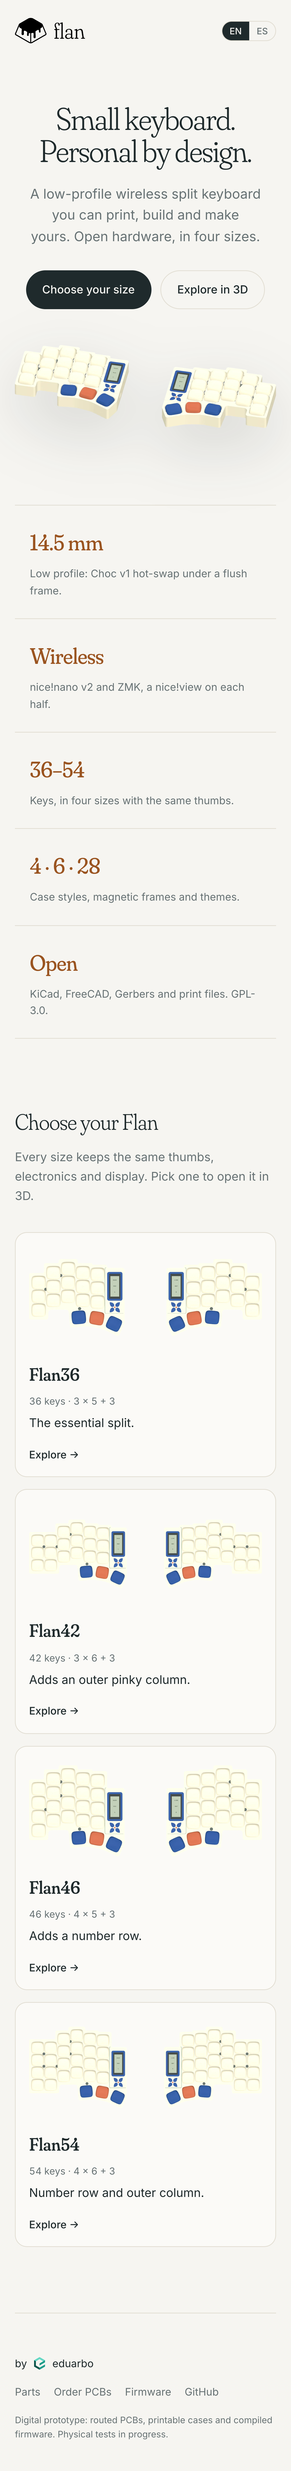
docs/proposals/home-r1/shots/a-phone.png
