eduarbo/flan/docs/proposals/home-r1/shots/b-phone.png

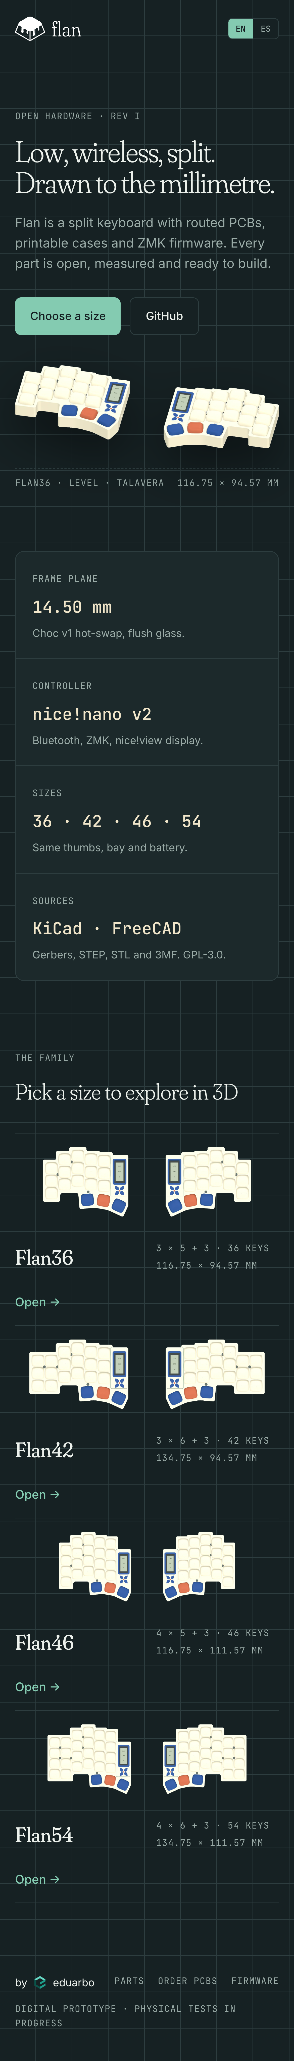
docs/proposals/home-r1/shots/b-phone.png
