eduarbo/flan/docs/proposals/home-r1/shots/c-phone.png

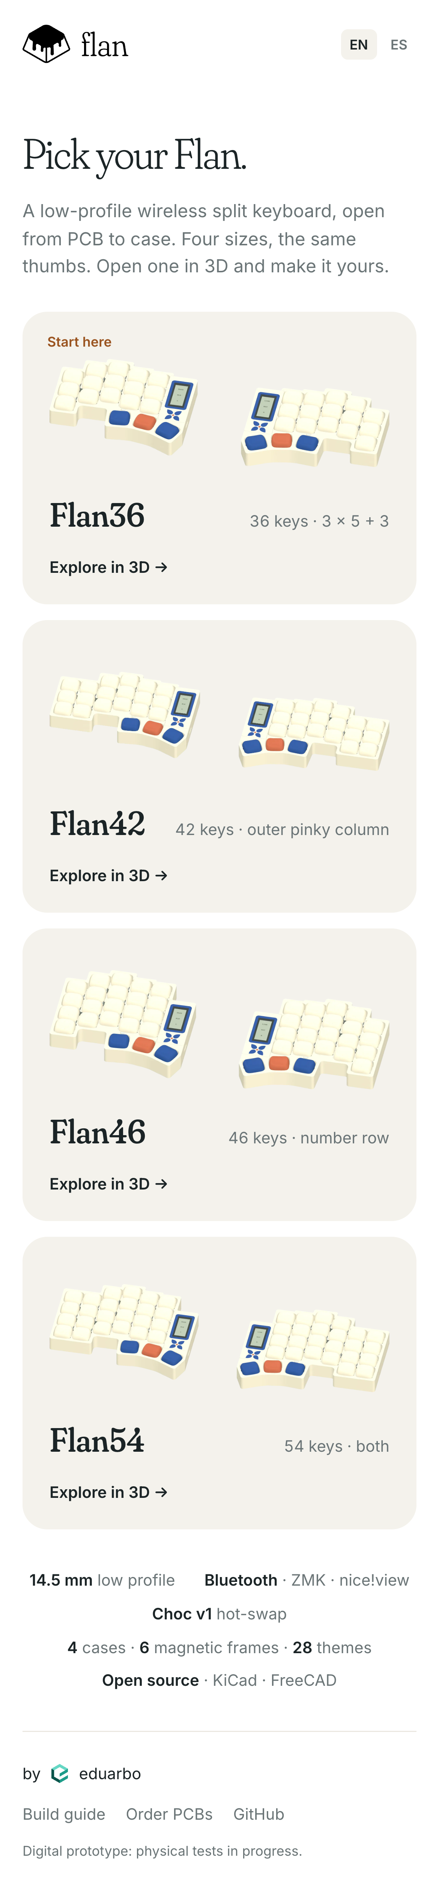
docs/proposals/home-r1/shots/c-phone.png
