eduarbo/flan/docs/proposals/home-r2/shots/a-desktop-gameboy.png

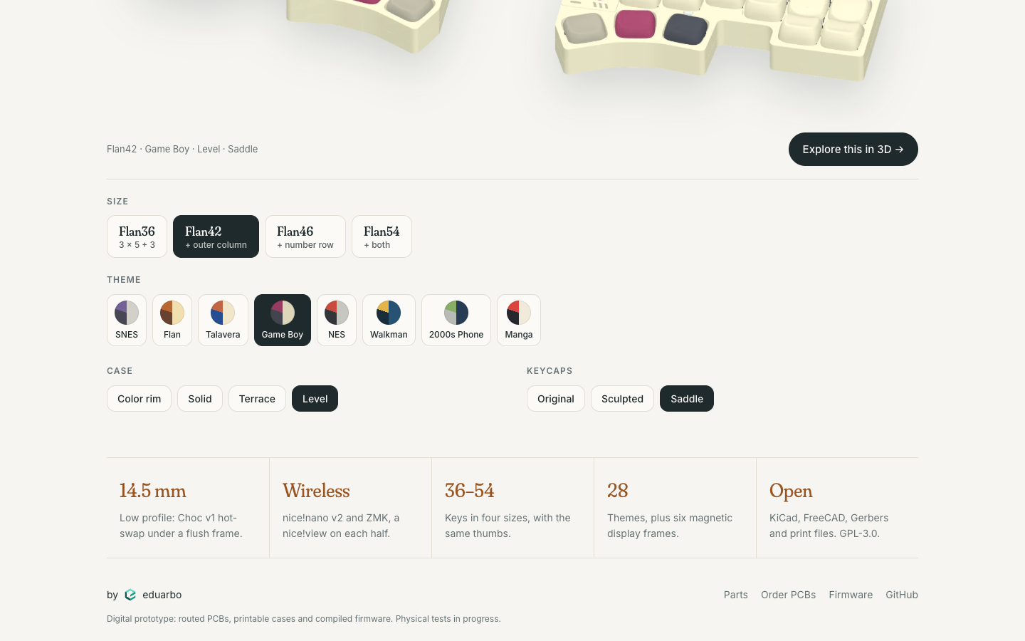
docs/proposals/home-r2/shots/a-desktop-gameboy.png
