eduarbo/flan/docs/proposals/home-r2/shots/a-phone.png

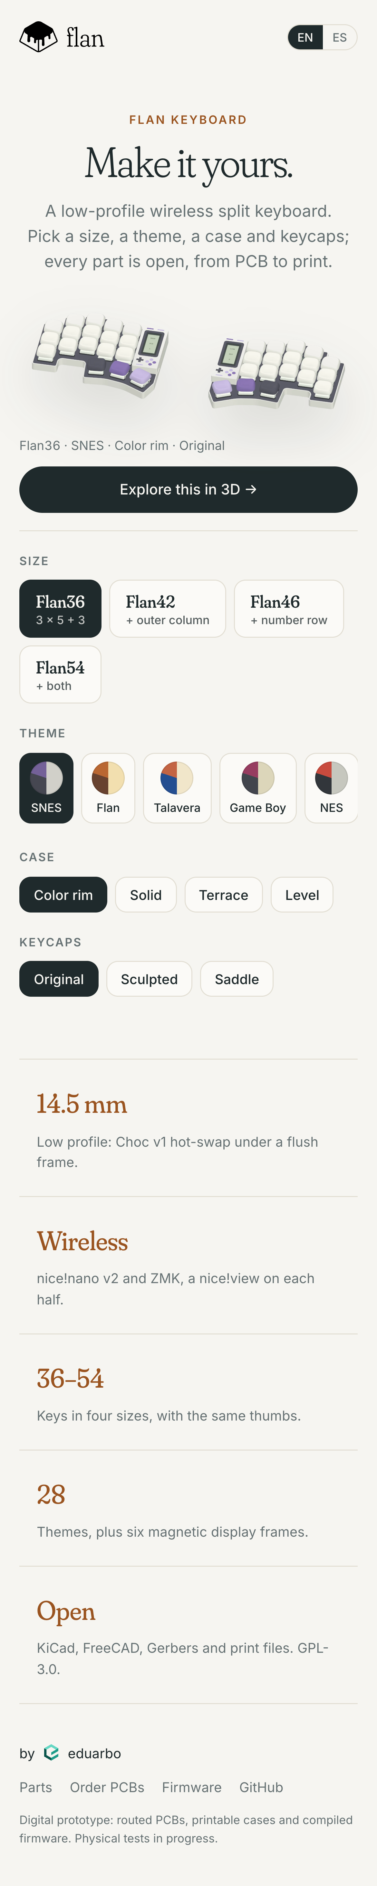
docs/proposals/home-r2/shots/a-phone.png
