eduarbo/flan/docs/proposals/home-r2/shots/b-desktop-gameboy.png

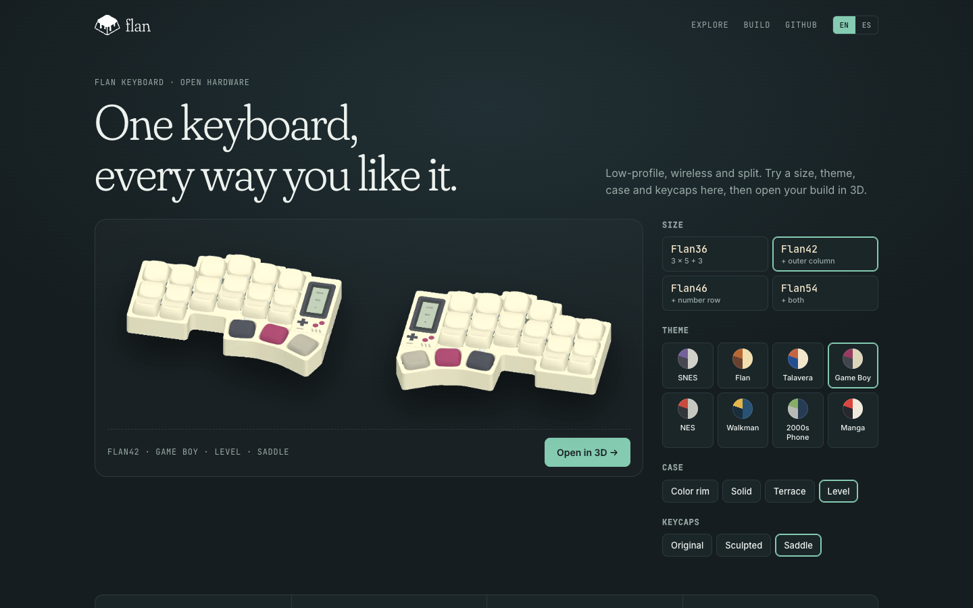
docs/proposals/home-r2/shots/b-desktop-gameboy.png
