eduarbo/flan/docs/proposals/home-r2/shots/b-phone.png

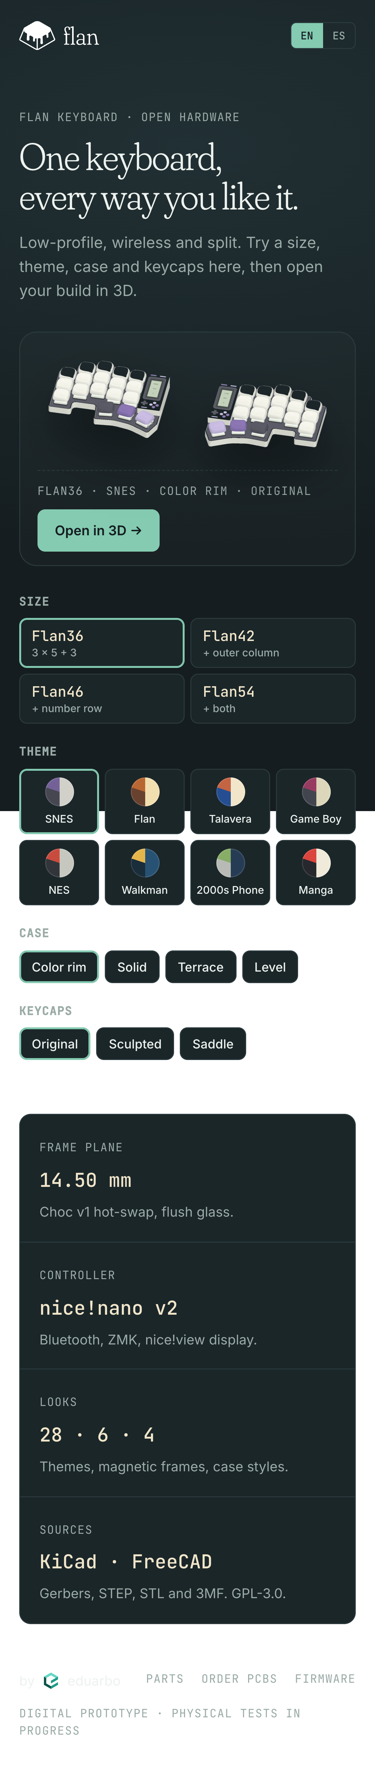
docs/proposals/home-r2/shots/b-phone.png
