eduarbo/flan/components/README.md

# Component models

These models make the assembly easier to inspect. They are **nominal representations**, not a claim of measured fit or manufacturer CAD.

| Part | Geometry and appearance | Evidence / remaining limit |
| --- | --- | --- |
| nice!nano v2 | Black rounded PCB, ENIG contacts, mid-mount USB-C shell and tongue, separate ICs, crystals, passives and LEDs | Official identity, 3.2 mm overall thickness and mid-mount USB. PCB 17.78 × 33.1 mm and total length 34.624 mm use a community drawing. Individual package placement/heights are reconstructed from photographs. |
| nice!view | 14 × 36 × 2.9 mm stack, five contacts, glass and backing; 10.744 × 25.28 mm active image | Official module drawing and Sharp panel specification. Preserve the 14.2 × 36.2 mm V-cut reserve for fit. Glass/flex assembly positions remain nominal. |
| Choc v1 | KiSwitch housing, pins and moving stem; original geometry, recolored | Generic Choc v1 community CAD; not a measured Pro Red specimen. KLP insertion and travel are not physically verified. |
| 36 SOD-123 diodes | Pinned KiCad source geometry, 18 per underside at the actual footprint poses | Nominal package dimensions; solder thickness remains unmeasured. |
| PCM12 / TL3342 | KiCad STEP geometry and original face materials | Registered to the existing KiCad footprints. Library models, not toleranced manufacturer assemblies. |
| Choc hotswap socket | 36 pinned KiSwitch sockets, registered to the actual footprint bores and solder-contact planes | Nominal bottom Z1.95 mm, 0.55 mm above the floor. The relieved internal H3 support has a measured K30 gap of 0.2500001 mm on both halves; minimum material around its pilot is 1.336281 mm left / 1.247739 mm right. [Clearance evidence](../validation/revI-socket-clearance.json). Actual KiCad STEP registration and native collisions are checked. Purchased variant, solder thickness and physical fit remain unqualified. |
| Batteries, MCU sockets and leads | Nominal cell profiles, socket reserves and continuous lead routes | Finished pouch seams, contacts, solder, wire diameter, terminations and strain relief still require measurement. |
| JST PH connector | Dimensioned side-entry header and mated housing envelope | Original reconstruction from the public catalog; internal mating and supplied plug dimensions are unmeasured. |

The right half uses the **same** commercial nano/display geometry, translated into place. The power switch is rotated to its footprint. Neither module is mirrored.

FreeCAD, the web viewer and the revI KiCad relative STEP models share this nominal geometry. The STEP export is reimported and compared with the native solids at each existing footprint datum; relative model references are preserved. The slim update changes J1 and moves the reset to the underside; actual KiCad STEP exports verify the resulting registration. [Readback](../validation/revI-pcb-component-models.json).

The controller support has scalloped upper ledges. These keep clear of a 1.05 mm radius reserve around the underside pads. They do not establish solder tolerance or retention force.

The nice!view PCB sits **7.00 mm above the main PCB**, using the **5 mm socket and 2 mm header supplied with the display**. Its PCB underside is **Z12.40 mm**, glass top **Z14.30 mm**, and frame/Level roof **Z14.50 mm**. The contact row follows the official 1.3 mm end offset. Free display solder tails are limited to 0.30 mm above the PCB with a 0.50 mm solder envelope; mating posts stay intact. Free socket tails remain within 1.00 mm below the main PCB. Actual solder tolerances and printed fit require assembly inspection. The earlier 6.09 mm Samtec SLW/TLW study was superseded because its square-post/finished-hole tolerance was not established. [Stack dimensions and history](../docs/level-stack.md).

The selected controller connectors are **four 12-contact sections cut from one Mill-Max 315-43-164-41-003000 64-position strip**, plus **48 installed 3320-0-00-15-00-00-03-0 round pins** (50 purchased). Sacrificial contacts at each cut preserve the retained socket bodies. The printed support holds the nice!nano PCB underside at **Z8.20 mm**, 2.80 mm above the main PCB, before soldering; the loose pin's 6.35 mm length does not set this separation. [Exact parts and assembly orientation](../docs/parts.md#removable-connectors).

Nominal nice!nano v2 reconstruction in the explorer

## Sources

- [nice!nano product specifications](https://nicekeyboards.com/nice-nano/) and [official v2 pinout, both faces](https://nicekeyboards.com/docs/nice-nano/pinout-schematic/).
- [Jordan Banasik / Woovie nominal v2 drawing](https://github.com/Woovie/nicenano-v2-model/tree/88099bcecdf2b60a0ec73131b132a182da03302b), CC0. Used as a dimensional reference; no recolored Pro Micro model is used.
- [nice!view mechanical drawing](https://nicekeyboards.com/docs/nice-view/pinout-schematic/) and [Sharp LS011B7DH03 catalogue](https://global.sharp/products/device/catalog/pdf/sharp_device202109_e.pdf).
- [KiSwitch source revision](https://github.com/kiswitch/kiswitch/tree/aefcf65038d48d2666ff14530d482be3c350fa6e), under its [MIT option](sources/KiSwitch-MIT.txt).
- [KiCad library license and exception](https://www.kicad.org/libraries/license/). Imported STEP files are CC-BY-SA-4.0 with the library exception. Original colors are preserved; only placement changes.

Exact asset URLs, hashes and licenses: [sources.json](sources.json). Official photographs are references, not images relicensed by this project. Parametric reconstruction: [components.py](../tools/freecad/components.py).

### PH battery connector

The slim stack uses an original nominal reconstruction of a **JST S2B-PH-K-S**
side-entry header and **PHR-2** housing. The public [JST PH catalog](https://www.jst-mfg.com/product/pdf/eng/ePH.pdf)
gives the side-entry mated assembly reserve as **9.6 mm long × 4.8 mm high**, with
2 mm pin pitch. The header body is 5.9 × 7.6 × 4.8 mm and the housing is
5.8 × 6.85 × 4.5 mm. Internal engagement, wire-port positions, plastic tolerances
and the purchased battery polarity remain unmeasured. No downloaded JST CAD is
redistributed. See `tools/freecad/slim_stack.py` and the bundled original footprint.
