eduarbo/flan/mechanical/revI/left-assembly.step

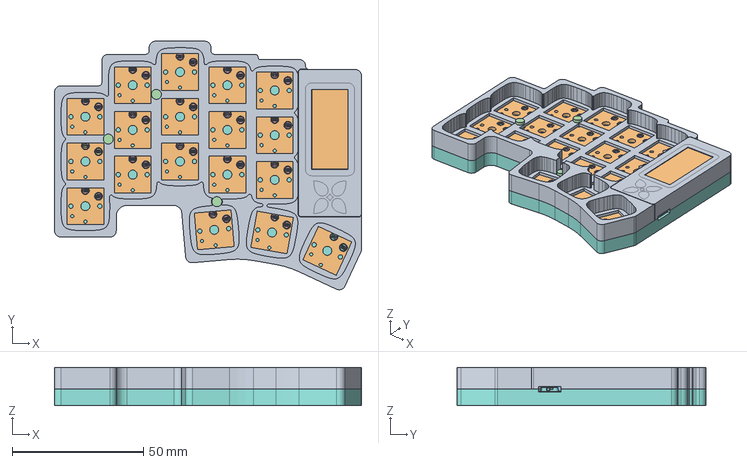
[picture p183: CAD file, 2026-10-12]
mechanical/revI/left-assembly.step
116.8 x 94.6 x 14.5 mm
