eduarbo/flan/docs/explore/assets/build/ccd732a7fb45d346d82a944c30918c84b2ca5eb4f17398a64a77de1ae7f62d0e.stl

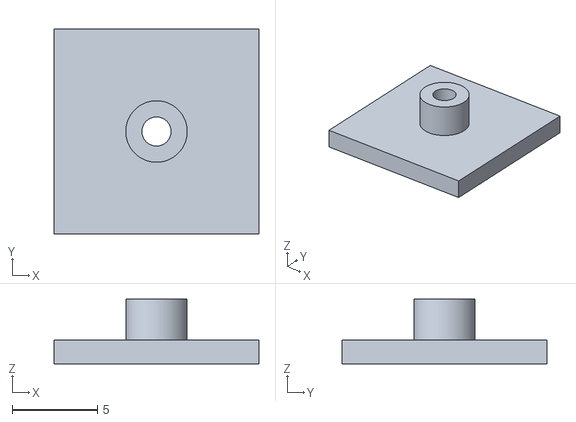
[picture p184: CAD file, 2026-11-12]
docs/explore/assets/build/ccd732a7fb45d346d82a944c30918c84b2ca5eb4f17398a64a77de1ae7f62d0e.stl
12.0 x 12.0 x 3.80
