eduarbo/flan/hardware/flan42/models/left-display.step

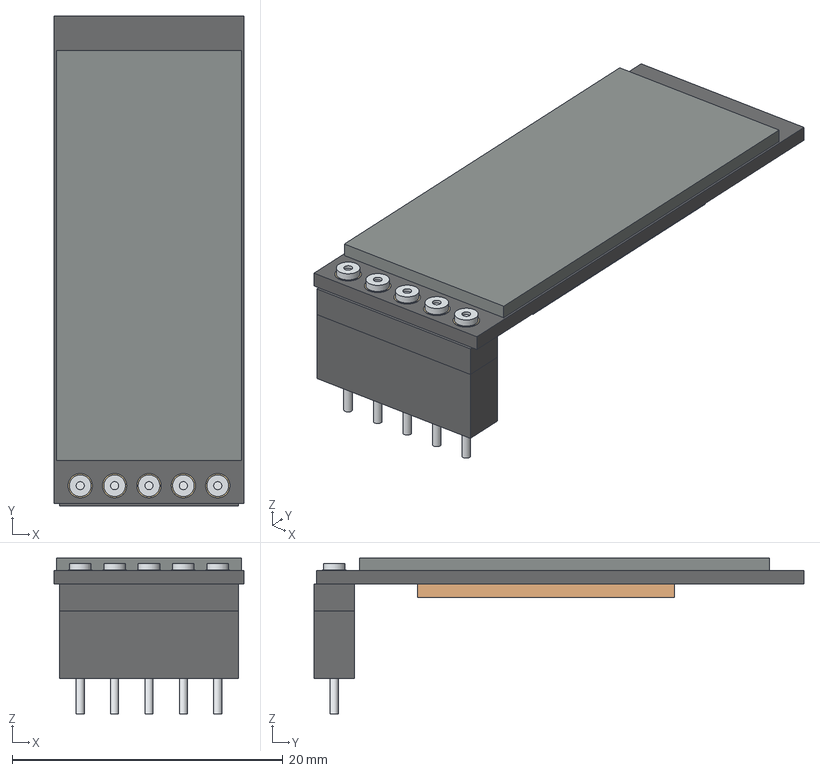
[picture p185: CAD file, 2026-10-18]
hardware/flan42/models/left-display.step
14.0 x 36.2 x 11.5 mm
