eduarbo/flan/hardware/revI/models/choc-envelope.step

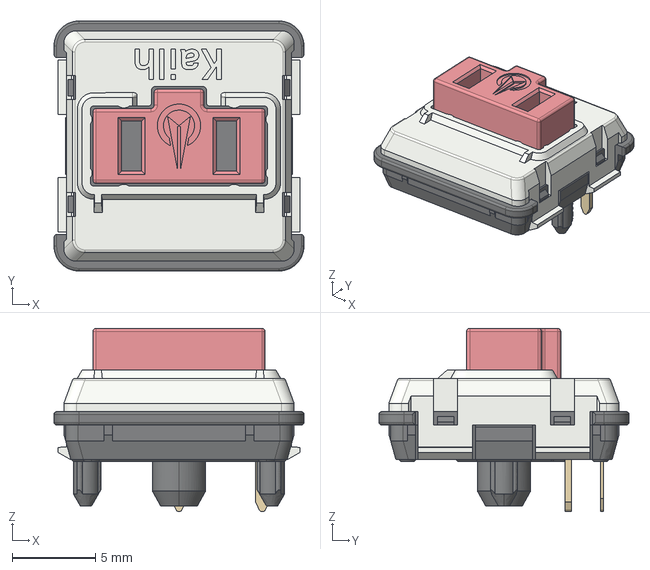
[picture p186: CAD file, 2026-10-11]
hardware/revI/models/choc-envelope.step
15.0 x 15.0 x 11.0 mm
