eduarbo/flan/mechanical/flan42/left-pcb.stl

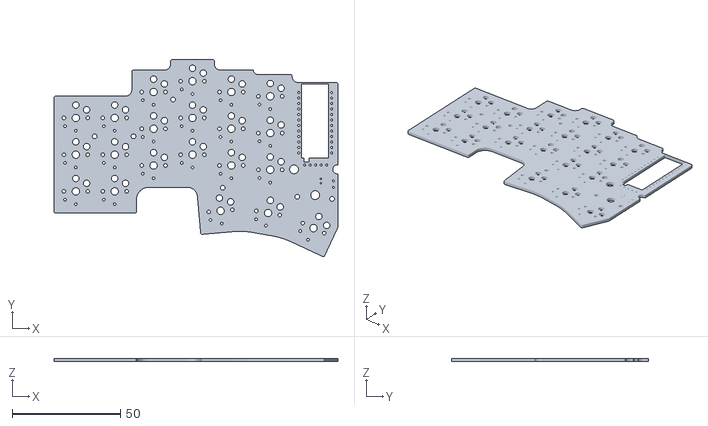
[picture p187: CAD file, 2026-10-19]
mechanical/flan42/left-pcb.stl
131.5 x 91.3 x 1.60
