eduarbo/flan/mechanical/flan46/right-pcb.stl

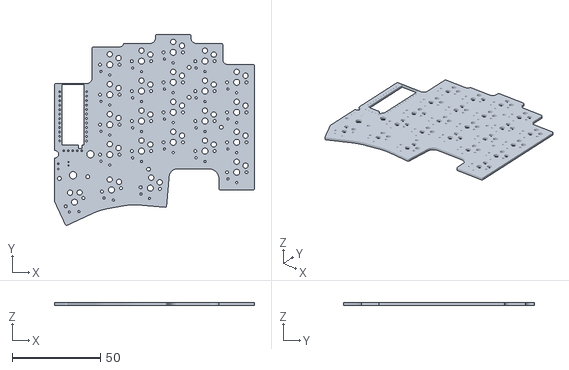
[picture p188: CAD file, 2026-10-19]
mechanical/flan46/right-pcb.stl
113.5 x 108.3 x 1.60
