eduarbo/flan/mechanical/flan54/right-pcb.stl

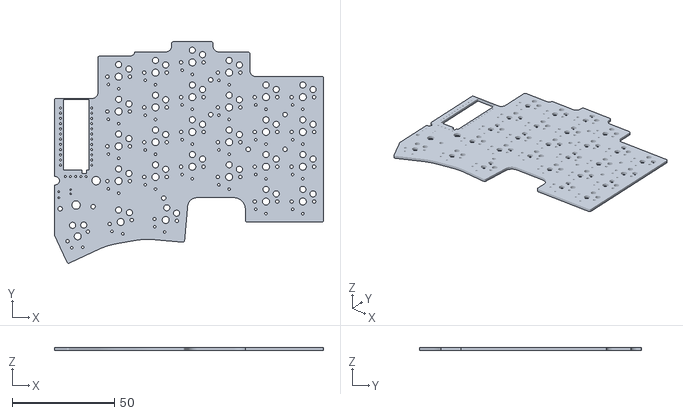
[picture p189: CAD file, 2026-10-19]
mechanical/flan54/right-pcb.stl
131.5 x 108.3 x 1.60
