eduarbo/flan/mechanical/revI/common-m2/right-frame-ipod-body.stl

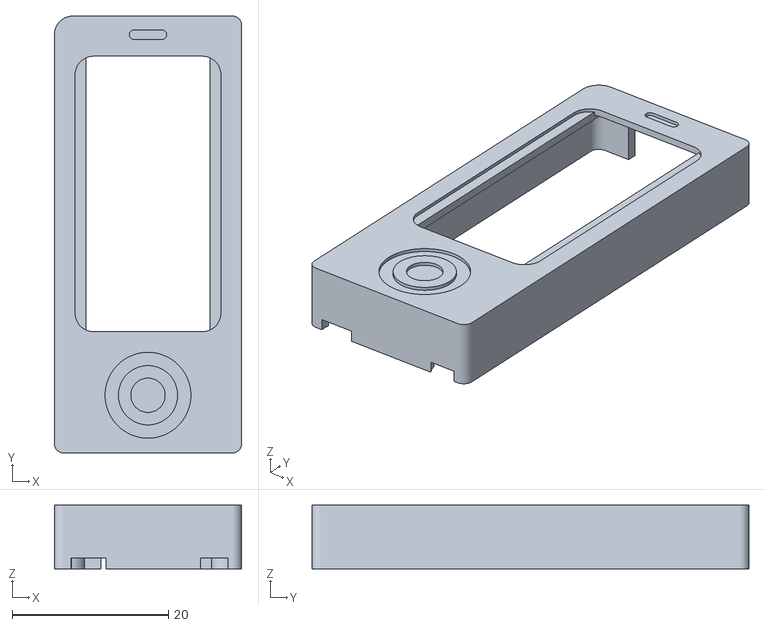
[picture p190: CAD file, 2026-11-13]
mechanical/revI/common-m2/right-frame-ipod-body.stl
24.0 x 56.0 x 8.20
