eduarbo/flan/hardware/revI/models/left-mcu.step

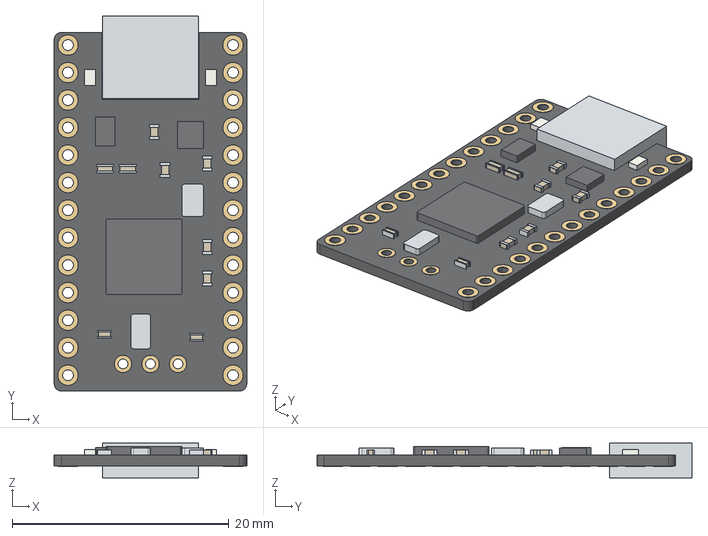
[picture p191: CAD file, 2026-10-11]
hardware/revI/models/left-mcu.step
17.8 x 34.6 x 3.20 mm
