eduarbo/flan/hardware/flan42/models/right-slider.step

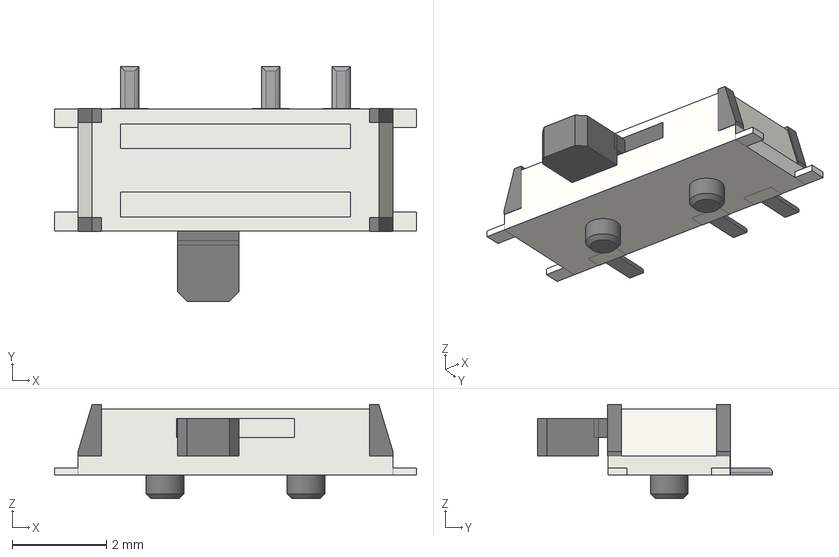
[picture p192: CAD file, 2026-10-18]
hardware/flan42/models/right-slider.step
7.70 x 5.00 x 2.00 mm
