eduarbo/flan/mechanical/flan46/left-case-terrace-base.step

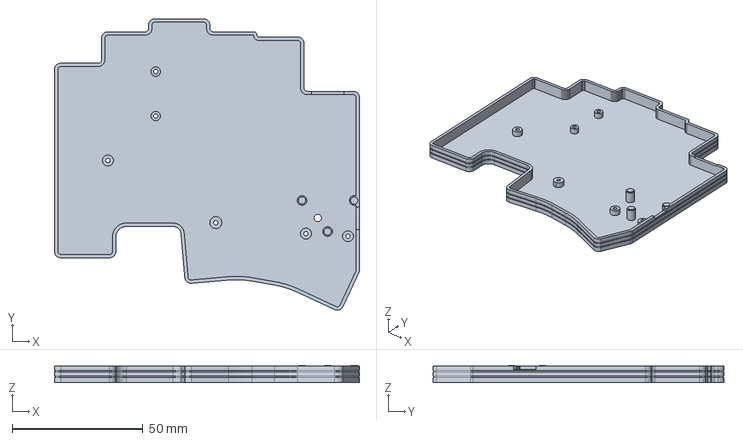
[picture p194: CAD file, 2026-10-18]
mechanical/flan46/left-case-terrace-base.step
116.8 x 111.6 x 6.60 mm
