eduarbo/flan/mechanical/flan54/right-case-terrace-base.step

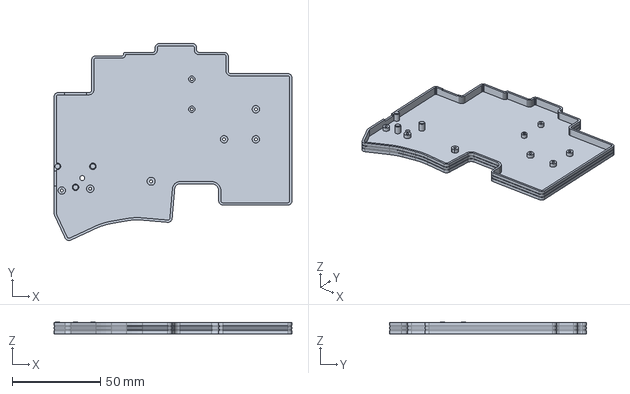
[picture p195: CAD file, 2026-10-18]
mechanical/flan54/right-case-terrace-base.step
134.8 x 111.6 x 6.60 mm
