eduarbo/flan/mechanical/revI/left-frame-gameboy.step

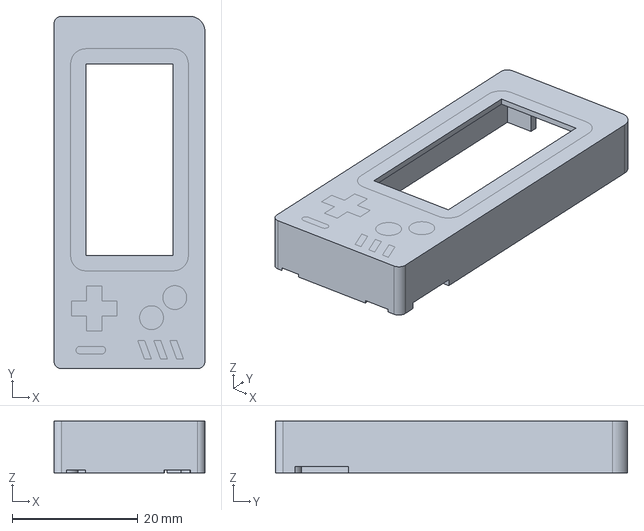
[picture p196: CAD file, 2026-10-12]
mechanical/revI/left-frame-gameboy.step
24.0 x 56.0 x 8.20 mm
