eduarbo/flan/hardware/flan42/models/right-jst.step

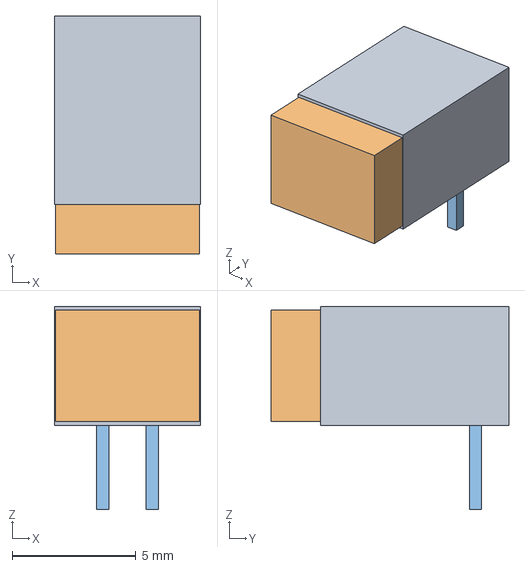
[picture p197: CAD file, 2026-10-18]
hardware/flan42/models/right-jst.step
5.90 x 9.60 x 8.20 mm
