eduarbo/flan/hardware/revI/models/right-reset.step

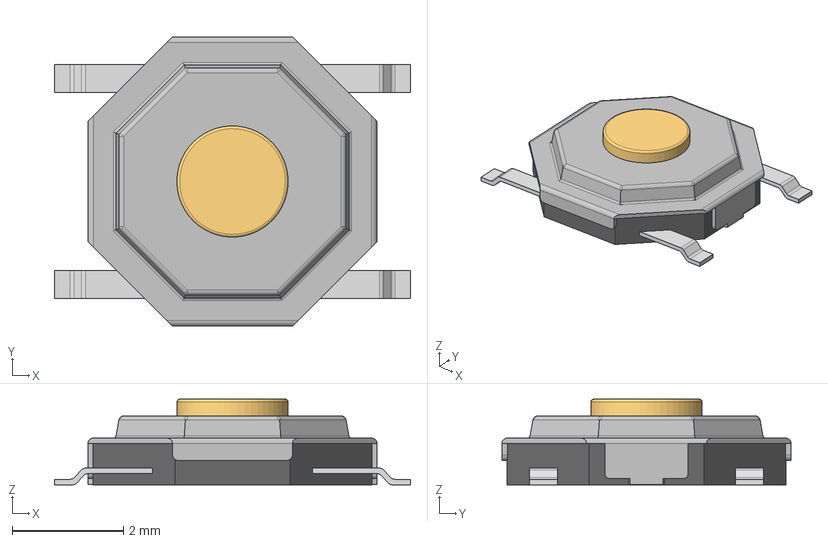
[picture p198: CAD file, 2026-10-11]
hardware/revI/models/right-reset.step
6.40 x 5.20 x 1.54 mm
