eduarbo/flan/mechanical/flan46/left-case-level-base.step

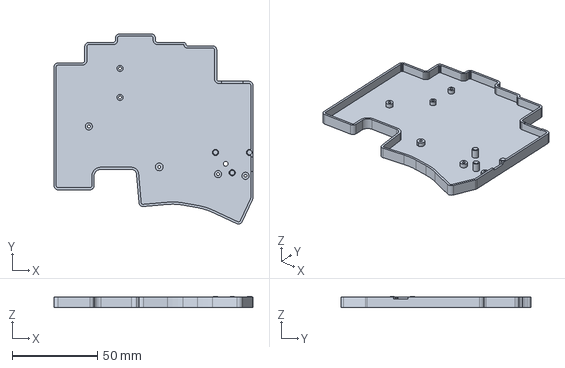
[picture p199: CAD file, 2026-10-18]
mechanical/flan46/left-case-level-base.step
116.8 x 111.6 x 6.60 mm
