eduarbo/flan/mechanical/revI/common-m2/left-case-level-plate.stl

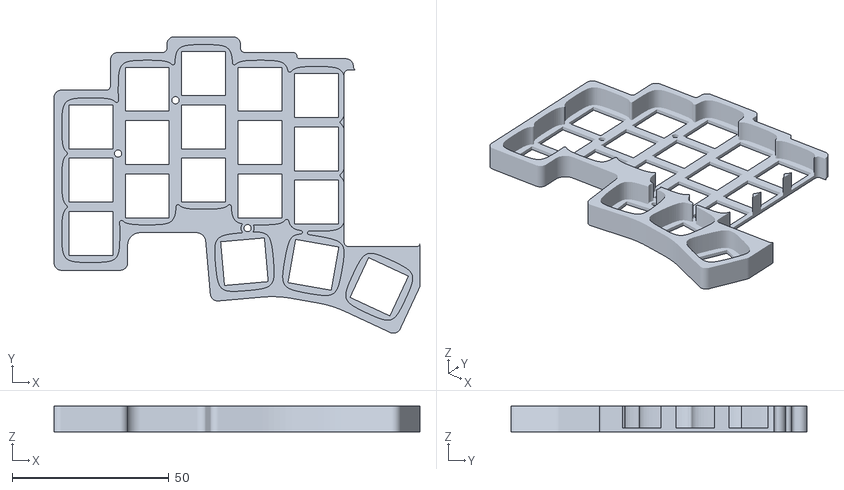
[picture p200: CAD file, 2026-11-13]
mechanical/revI/common-m2/left-case-level-plate.stl
116.8 x 94.6 x 8.20
