eduarbo/flan/mechanical/revI/left-case-terrace-plate.step

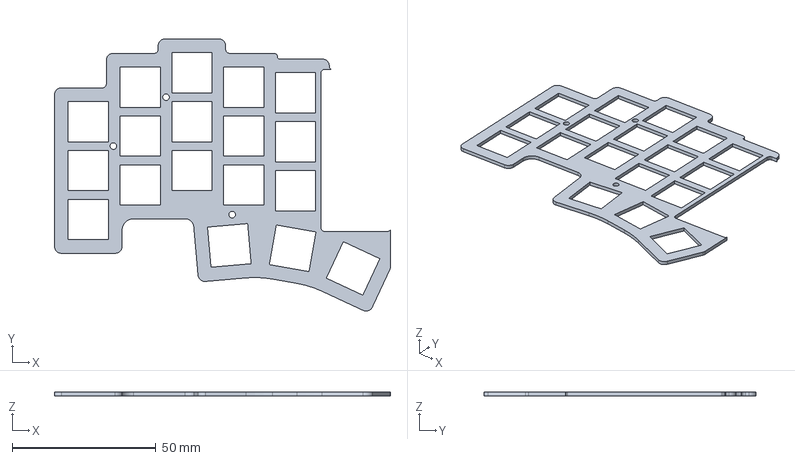
[picture p201: CAD file, 2026-10-12]
mechanical/revI/left-case-terrace-plate.step
116.8 x 94.6 x 1.30 mm
