eduarbo/flan/mechanical/flan42/left-case-terrace-plate.step

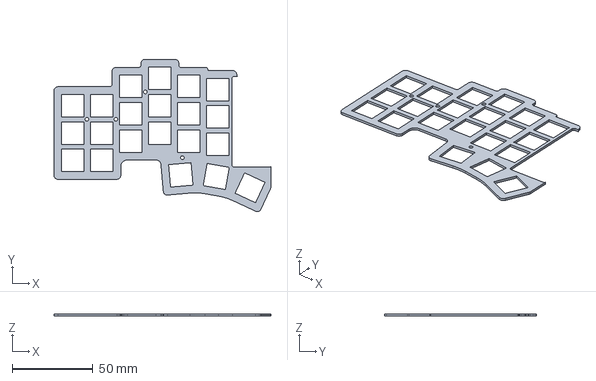
[picture p202: CAD file, 2026-10-18]
mechanical/flan42/left-case-terrace-plate.step
134.8 x 94.6 x 1.30 mm
