eduarbo/flan/mechanical/flan46/right-case-rim-base.step

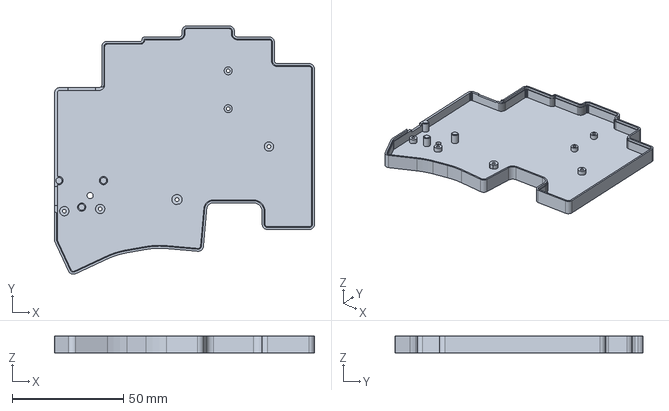
[picture p203: CAD file, 2026-10-18]
mechanical/flan46/right-case-rim-base.step
116.8 x 111.6 x 7.60 mm
