eduarbo/flan/mechanical/flan54/left-case-rim-base.step

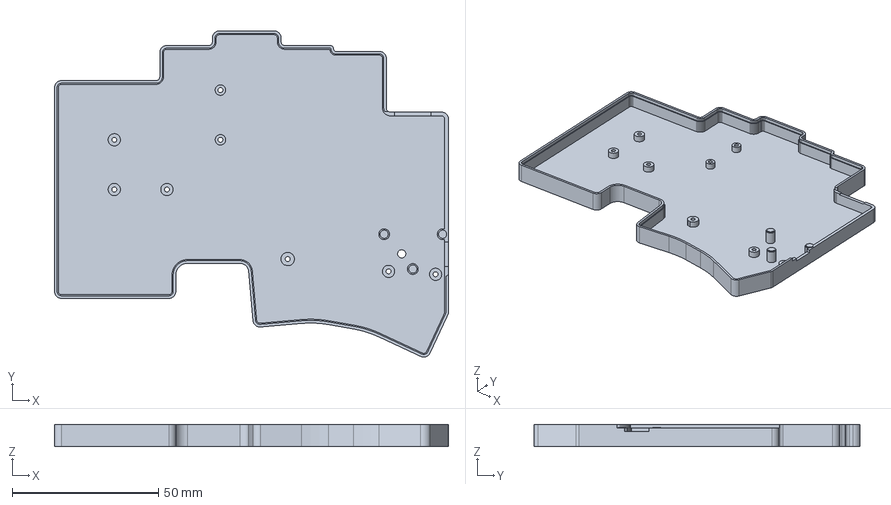
[picture p204: CAD file, 2026-10-18]
mechanical/flan54/left-case-rim-base.step
134.8 x 111.6 x 7.60 mm
