eduarbo/flan/mechanical/revI/right-frame-tape-body.step

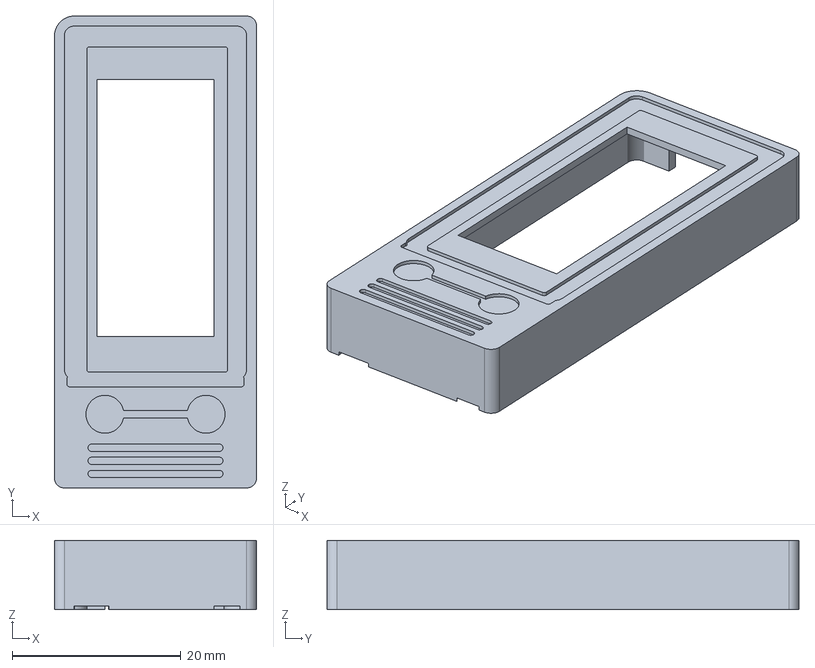
[picture p205: CAD file, 2026-10-12]
mechanical/revI/right-frame-tape-body.step
24.0 x 56.0 x 8.20 mm
