eduarbo/flan/mechanical/flan42/right-case-solid-base.step

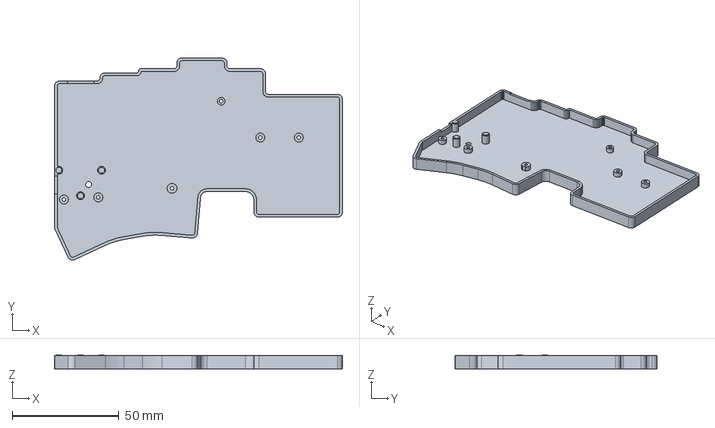
[picture p206: CAD file, 2026-10-18]
mechanical/flan42/right-case-solid-base.step
134.8 x 94.6 x 6.60 mm
