eduarbo/flan/mechanical/flan54/right-case-rim-plate.step

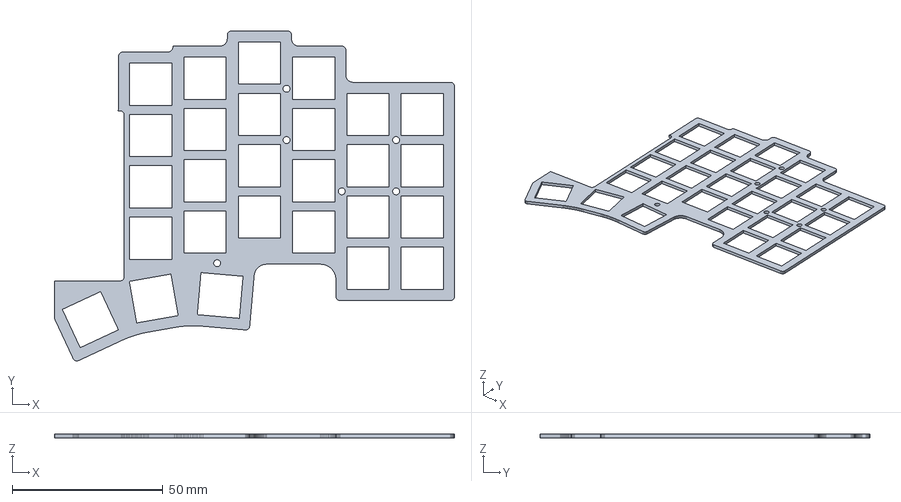
[picture p207: CAD file, 2026-10-18]
mechanical/flan54/right-case-rim-plate.step
132.6 x 109.4 x 1.30 mm
