eduarbo/flan/mechanical/flan42/left-case-rim-base.step

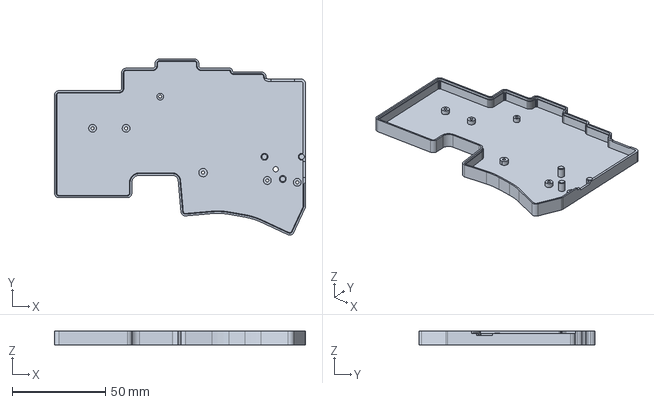
[picture p208: CAD file, 2026-10-18]
mechanical/flan42/left-case-rim-base.step
134.8 x 94.6 x 7.60 mm
