eduarbo/flan/mechanical/flan46/right-case-terrace-plate.step

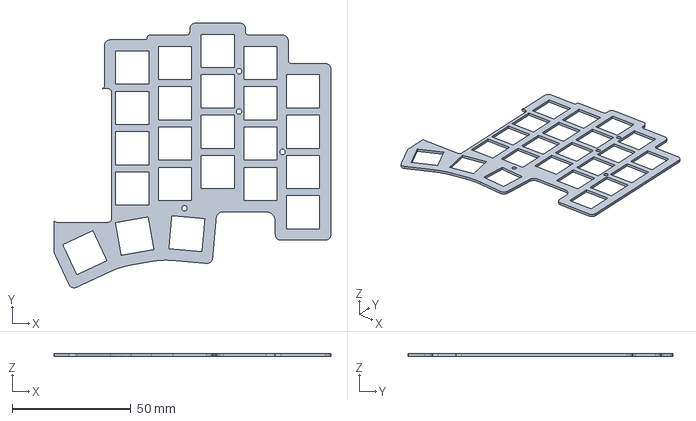
[picture p209: CAD file, 2026-10-18]
mechanical/flan46/right-case-terrace-plate.step
116.8 x 111.6 x 1.30 mm
