eduarbo/flan/mechanical/flan54/right-case-solid-plate.step

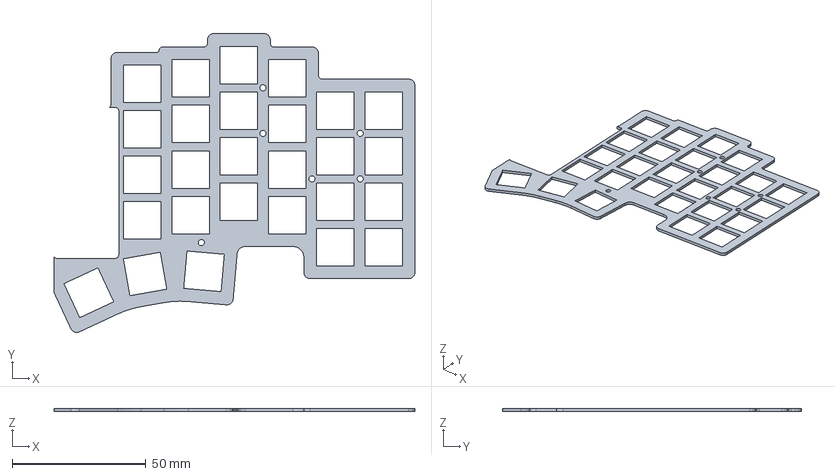
[picture p210: CAD file, 2026-10-18]
mechanical/flan54/right-case-solid-plate.step
134.8 x 111.6 x 1.30 mm
