eduarbo/flan/mechanical/revI/right-case-rim-plate.step

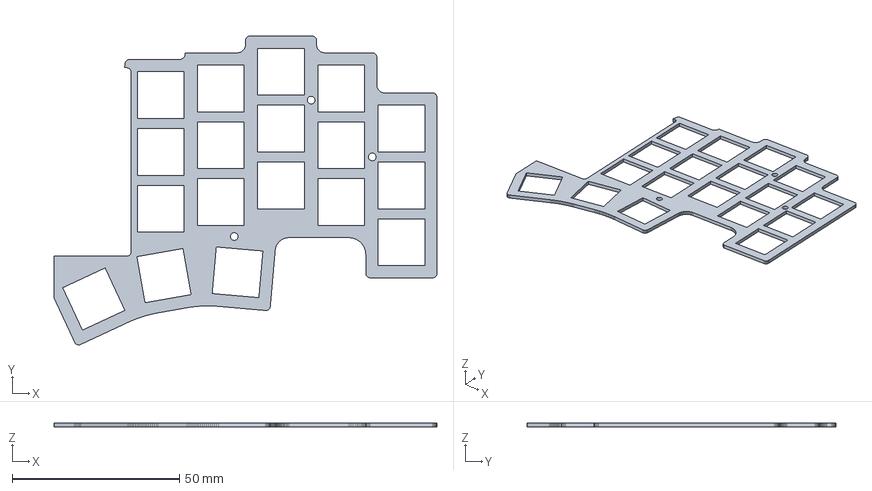
[picture p211: CAD file, 2026-10-12]
mechanical/revI/right-case-rim-plate.step
114.6 x 92.4 x 1.30 mm
