eduarbo/flan/mechanical/revI/right-frame-flan-body.step

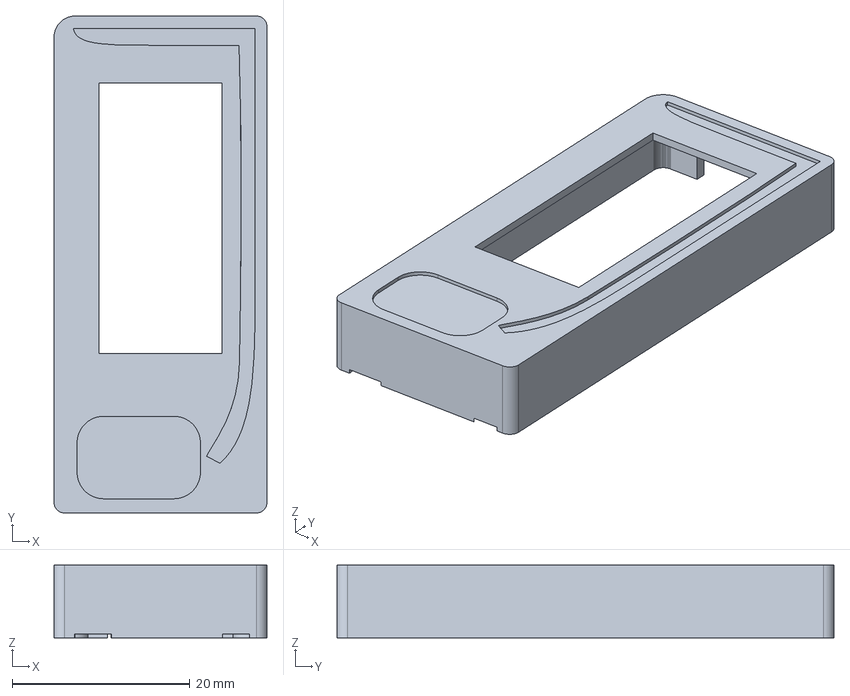
[picture p212: CAD file, 2026-10-12]
mechanical/revI/right-frame-flan-body.step
24.0 x 56.0 x 8.20 mm
