eduarbo/flan/mechanical/flan46/right-case-rim-plate.step

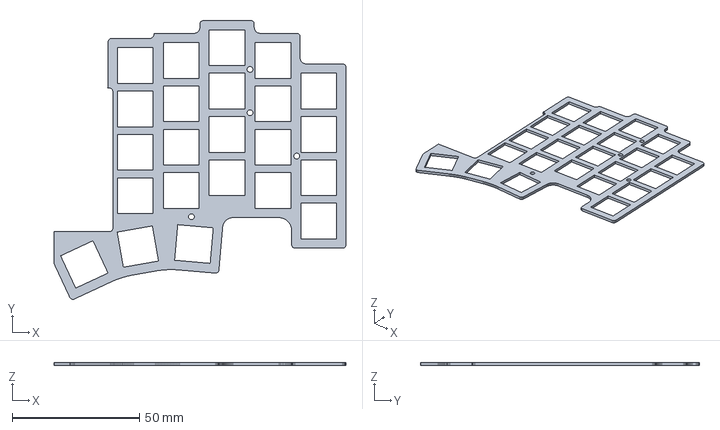
[picture p213: CAD file, 2026-10-18]
mechanical/flan46/right-case-rim-plate.step
114.6 x 109.4 x 1.30 mm
