eduarbo/flan/mechanical/flan54/right-case-level-plate.step

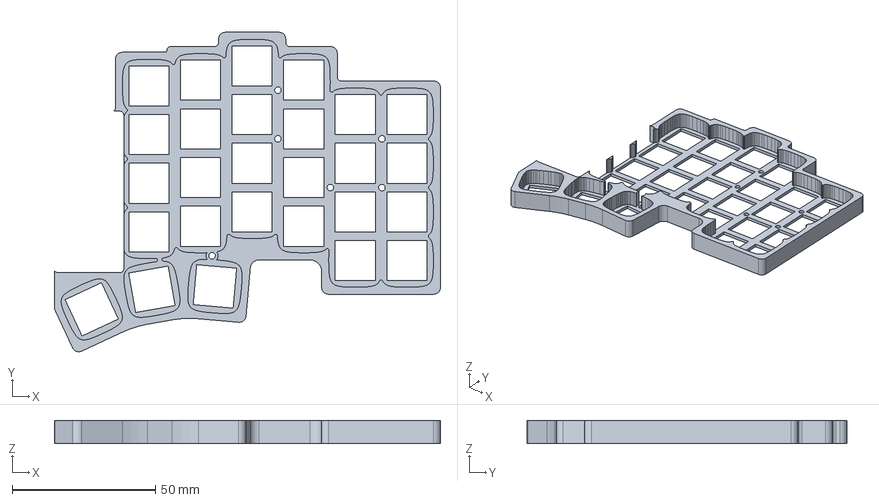
[picture p214: CAD file, 2026-10-18]
mechanical/flan54/right-case-level-plate.step
134.8 x 111.6 x 8.20 mm
