eduarbo/flan/mechanical/flan42/right-case-level-plate.step

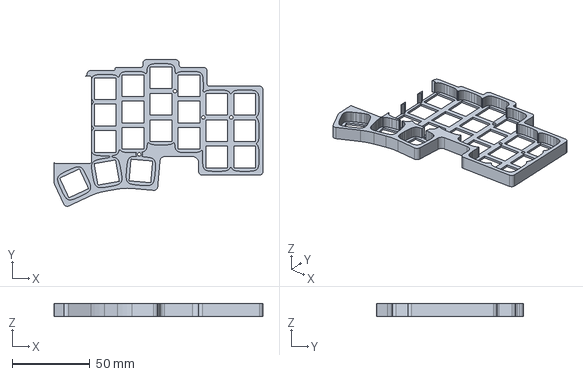
[picture p215: CAD file, 2026-10-18]
mechanical/flan42/right-case-level-plate.step
134.8 x 94.6 x 8.20 mm
