eduarbo/flan/mechanical/flan42/left-case-rim-plate.step

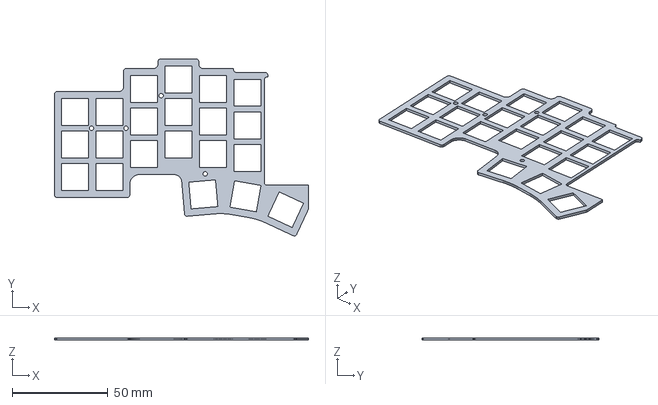
[picture p216: CAD file, 2026-10-18]
mechanical/flan42/left-case-rim-plate.step
132.6 x 92.4 x 1.30 mm
