eduarbo/flan/mechanical/flan46/left-case-level-plate.step

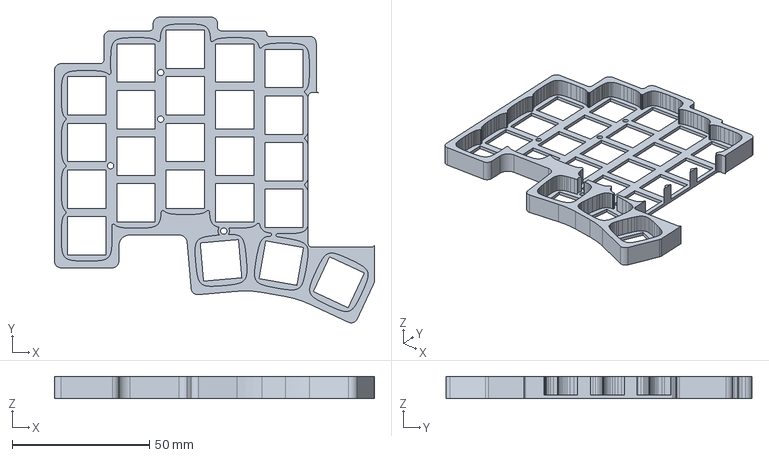
[picture p217: CAD file, 2026-10-18]
mechanical/flan46/left-case-level-plate.step
116.8 x 111.6 x 8.20 mm
