eduarbo/flan/mechanical/revI/right-cradle.step

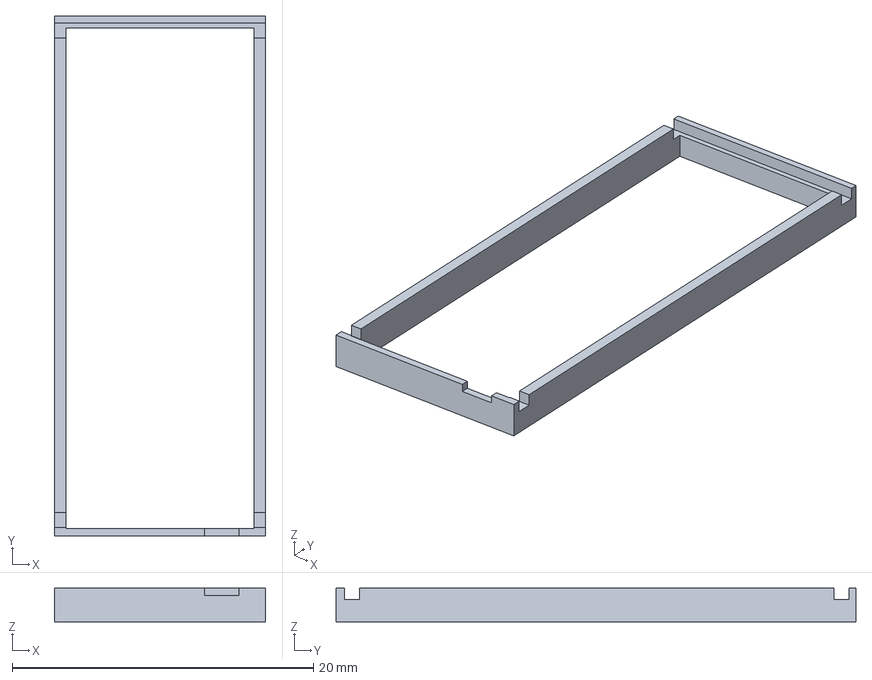
[picture p218: CAD file, 2026-10-12]
mechanical/revI/right-cradle.step
14.0 x 34.5 x 2.25 mm
