eduarbo/flan/mechanical/revI/right-mcu-riser.step

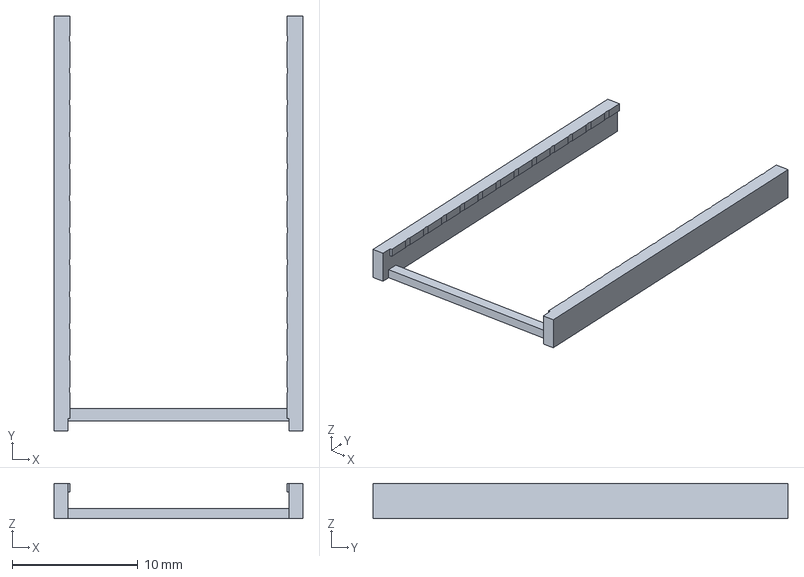
[picture p219: CAD file, 2026-10-12]
mechanical/revI/right-mcu-riser.step
19.8 x 33.0 x 2.80 mm
