eduarbo/flan/(list of files, cad)

Other CAD files:
mechanical/revI/right-assembly.step
mechanical/revI/right-frame-phone-body.step
hardware/flan42/models/right-display.step
mechanical/flan42/right-pcb.stl
mechanical/flan46/left-pcb.stl
mechanical/flan54/left-pcb.stl
mechanical/revI/common-m2/right-frame-talavera-body.stl
mechanical/revI/right-frame-ipod-body.step
hardware/revI/models/right-mcu.step
mechanical/revI/common-m2/left-frame-snes-body.stl
mechanical/flan42/left-case-terrace-base.step
mechanical/flan54/right-case-solid-base.step
hardware/flan42/models/left-slider.step
hardware/revI/models/left-jst.step
mechanical/revI/common-m2/left-frame-ipod.stl
hardware/flan42/models/left-reset.step
mechanical/flan46/left-case-rim-base.step
mechanical/revI/common-m2/right-frame-hanafuda.stl
mechanical/revI/left-frame-flan.step
mechanical/flan54/left-case-solid-base.step
mechanical/revI/common-m2/right-frame-gameboy.stl
mechanical/revI/right-frame-ipod.step
mechanical/flan42/left-case-solid-plate.step
mechanical/flan46/left-case-solid-base.step
mechanical/revI/common-m2/right-frame-ipod.stl
mechanical/flan42/left-case-solid-base.step
mechanical/flan46/right-case-level-base.step
mechanical/flan54/right-case-level-base.step
mechanical/revI/common-m2/left-frame-gameboy-body.stl
mechanical/flan42/right-case-level-base.step
mechanical/revI/common-m2/left-frame-snes.stl
mechanical/revI/right-frame-walkman.step
mechanical/flan46/left-case-terrace-plate.step
mechanical/flan54/right-case-rim-base.step
mechanical/revI/common-m2/right-frame-talavera.stl
mechanical/revI/left-frame-ipod.step
mechanical/flan54/left-case-level-base.step
mechanical/revI/common-m2/right-case-solid-plate.stl
mechanical/revI/left-electronics-lid.step
mechanical/flan42/right-case-rim-plate.step
mechanical/flan46/right-case-terrace-base.step
mechanical/flan54/left-case-terrace-base.step
mechanical/revI/common-m2/right-frame-gameboy-body.stl
mechanical/revI/left-frame-tape.step
mechanical/flan42/left-case-level-plate.step
mechanical/flan46/right-case-solid-base.step
mechanical/flan54/left-case-terrace-plate.step
mechanical/revI/common-m2/left-frame-gameboy.stl
mechanical/revI/right-frame-hanafuda.step
mechanical/flan42/right-case-terrace-plate.step
mechanical/flan46/right-case-level-plate.step
mechanical/flan54/left-case-level-plate.step
mechanical/revI/common-m2/right-frame-phone.stl
mechanical/revI/left-frame-nes.step
mechanical/flan42/right-case-rim-base.step
mechanical/flan46/left-case-rim-plate.step
mechanical/flan54/left-case-solid-plate.step
mechanical/revI/common-m2/left-case-rim-plate.stl
mechanical/flan42/left-case-level-base.step
mechanical/flan46/left-case-solid-plate.step
mechanical/flan54/right-case-terrace-plate.step
mechanical/revI/common-m2/right-frame-hanafuda-body.stl
mechanical/revI/right-frame-talavera-body.step
mechanical/flan42/right-case-solid-plate.step
mechanical/flan46/right-case-solid-plate.step
mechanical/flan54/left-case-rim-plate.step
mechanical/revI/common-m2/left-case-terrace-plate.stl
mechanical/revI/left-frame-manga.step
mechanical/revI/common-m2/left-frame-talavera-body.stl
mechanical/revI/right-frame-orbit.step
mechanical/revI/common-m2/right-frame-phone-body.stl
mechanical/revI/left-frame-phone-body.step
mechanical/revI/common-m2/left-frame-phone.stl
mechanical/revI/left-frame-walkman-body.step
mechanical/revI/common-m2/right-frame-snes-body.stl
mechanical/revI/Flan36.FCStd
mechanical/revI/common-m2/left-frame-talavera.stl
mechanical/revI/right-frame-gameboy-body.step
mechanical/revI/common-m2/right-frame-snes.stl
mechanical/revI/right-frame-phone.step
mechanical/revI/common-m2/right-case-level-plate.stl
mechanical/revI/common-m2/left-frame-ipod-body.stl
mechanical/revI/left-frame-talavera.step
mechanical/revI/common-m2/right-case-rim-plate.stl
mechanical/revI/common-m2/left-frame-hanafuda-body.stl
mechanical/revI/common-m2/left-frame-phone-body.stl
mechanical/revI/right-frame-manga.step
mechanical/revI/common-m2/left-frame-hanafuda.stl
mechanical/revI/left-case-solid-plate.step
mechanical/revI/right-frame-manga-body.step
mechanical/revI/left-case-rim-plate.step
mechanical/revI/left-frame-gameboy-body.step
mechanical/revI/right-frame-hanafuda-body.step
mechanical/revI/left-frame-nes-body.step
mechanical/revI/right-frame-tape.step
mechanical/revI/left-frame-orbit.step
mechanical/revI/right-electronics-lid.step
mechanical/revI/left-frame-tape-body.step
mechanical/revI/left-frame-orbit-body.step
mechanical/revI/right-frame-walkman-body.step
mechanical/revI/left-frame-phone.step
mechanical/revI/left-frame-manga-body.step
mechanical/revI/right-frame-nes.step
mechanical/revI/right-frame-snes-body.step
mechanical/revI/right-case-solid-plate.step
mechanical/revI/right-frame-talavera.step
mechanical/revI/right-case-terrace-plate.step
mechanical/revI/right-frame-snes.step
mechanical/revI/right-frame-flan.step
mechanical/revI/right-frame-nes-body.step
mechanical/revI/left-frame-hanafuda.step
mechanical/revI/left-frame-walkman.step
mechanical/revI/left-frame-flan-body.step
docs/explore/assets/build/c48717505265c6e0d932de1b4983b829a6a16640fe0531f9f70e6939c205a8d4.stl
mechanical/flan42/left-case-level-plate.stl
mechanical/flan42/left-case-rim-base.stl
mechanical/flan42/left-case-rim-plate.stl
mechanical/flan42/left-case-solid-base.stl
mechanical/flan42/left-case-solid-plate.stl
mechanical/flan42/left-case-terrace-base.stl
mechanical/flan42/right-case-level-plate.stl
mechanical/flan42/right-case-rim-base.stl
mechanical/flan42/right-case-rim-plate.stl
mechanical/flan42/right-case-solid-base.stl
mechanical/flan42/right-case-solid-plate.stl
mechanical/flan42/right-case-terrace-base.stl
mechanical/flan46/left-case-level-base.stl
mechanical/flan46/left-case-level-plate.stl
mechanical/flan46/left-case-rim-base.stl
mechanical/flan46/left-case-rim-plate.stl
mechanical/flan46/left-case-solid-plate.stl
mechanical/flan46/left-case-terrace-base.stl
mechanical/flan46/right-case-level-base.stl
mechanical/flan46/right-case-level-plate.stl
mechanical/flan46/right-case-rim-base.stl
mechanical/flan46/right-case-rim-plate.stl
mechanical/flan46/right-case-solid-plate.stl
mechanical/flan46/right-case-terrace-base.stl
mechanical/flan54/left-case-level-base.stl
mechanical/flan54/left-case-level-plate.stl
mechanical/flan54/left-case-rim-base.stl
mechanical/flan54/left-case-rim-plate.stl
mechanical/flan54/left-case-terrace-base.stl
mechanical/flan54/left-case-terrace-plate.stl
mechanical/flan54/right-case-level-base.stl
mechanical/flan54/right-case-level-plate.stl
mechanical/flan54/right-case-rim-base.stl
mechanical/flan54/right-case-rim-plate.stl
mechanical/flan54/right-case-terrace-base.stl
mechanical/flan54/right-case-terrace-plate.stl
mechanical/revI/left-case-level-plate.step
mechanical/revI/left-display-sled.step
mechanical/revI/left-display-sled.stl
mechanical/revI/left-display-socket-visual-0.stl
mechanical/revI/left-display-socket-visual-1.stl
mechanical/revI/left-display-socket.stl
mechanical/revI/left-display-visual-0.stl
mechanical/revI/left-display-visual-1.stl
mechanical/revI/left-display-visual-2.stl
mechanical/revI/left-display-visual-3.stl
mechanical/revI/left-display-visual-4.stl
mechanical/revI/left-display-visual-5.stl
mechanical/revI/left-display-visual-6.stl
mechanical/revI/left-display.stl
mechanical/revI/left-electronics-lid.stl
mechanical/revI/left-frame-flan-accent.step
mechanical/revI/left-frame-flan-accent.stl
mechanical/revI/left-frame-flan-body.stl
mechanical/revI/left-frame-flan-detail.step
mechanical/revI/left-frame-flan-detail.stl
mechanical/revI/left-frame-flan-secondary.step
mechanical/revI/left-frame-flan-secondary.stl
mechanical/revI/left-frame-flan.stl
mechanical/revI/left-frame-gameboy-accent.step
mechanical/revI/left-frame-gameboy-accent.stl
mechanical/revI/left-frame-gameboy-body.stl
mechanical/revI/left-frame-gameboy-detail.step
mechanical/revI/left-frame-gameboy-detail.stl
mechanical/revI/left-frame-gameboy-secondary.step
mechanical/revI/left-frame-gameboy-secondary.stl
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
