eduarbo/flan/docs/themes-printing.md

# Make it yours

Open [the 3D explorer](https://flankbd.com/explore/) and pick a swatch under **Design → Theme**. Thirty-one presets coordinate the case, frame and keycaps; **Per half** applies one to a single half.

All five finger columns share the same base color. Each thumb gets its own coordinated accent, mirrored between halves. In **Caps → Colors**, eight independent palettes follow the same approach: **Sunset rows** colors whole finger rows and **Arcade thumbs** puts its bright accents on the three thumbs. **Original** keeps matching green thumbs.

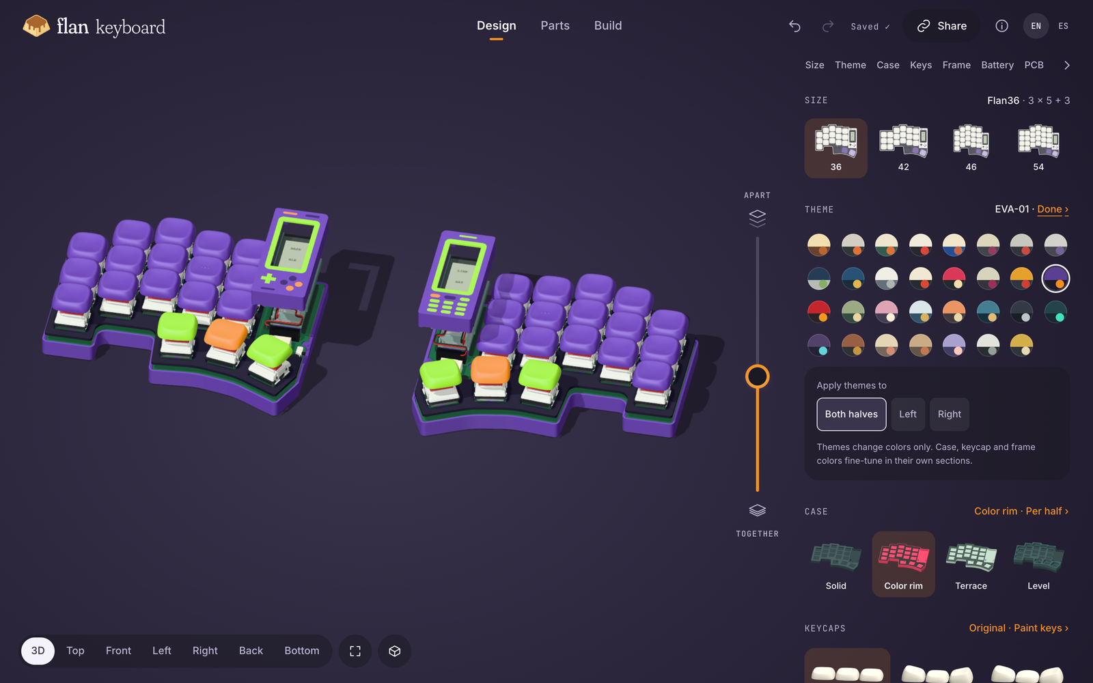
[picture p220: docs/images/revI-themes.png]
Design → Theme in the explorer, with Per half open


1. Choose **Both halves**, **Left** or **Right**.
2. Pick a theme. It changes colors while preserving shapes, keycap geometry and installed covers.
3. In **Base**, edit the base/rim and key plate. In **Frame**, edit the body and flush inlays. Every color also has a HEX field and **Copy** button.
4. Enable **Match frame and rim** for continuous color. Editing either linked color updates the other; with Level, the upper shell joins the linked base and frame color.
5. Use **Build → Print the parts → Download print kit**; the complete kit also carries your keycaps.

The [six installed approved frames](frames-extra.md) have four solid-color regions. Talavera is the default. Each design has a matching global palette; **Restore design colors** restores the selected frame palette.

Changing shapes preserves customized colors. An untouched original design adopts the new shape's original palette. Frame and theme changes preserve cover visibility and the current inspection.

## Keep your configuration

Selections save automatically on this device. **Save configuration** downloads JSON for another browser or the FreeCAD configuration macro. JSON carries explicit colors, shapes and cover installation, so a preset name never changes an old saved design. Legacy JSON still loads.

To update an existing design to these colors, select its theme or cap palette again. Custom colors remain editable per key, row or column.

The [current collection checks](../validation/revI-approved-selection.json) cover native material exports, configuration migration and viewer behavior. The earlier [thumb-palette receipt](../validation/revI-thumb-themes.json) records the previous palette set.

Eye, Solo, camera and exploded views are inspection controls. They do not remove parts from the print kit. Unchecking **Printed display cover** does remove that cover and its three frame magnets from the selected assembly.

## Printable parts and joining

**Shells** exports each selected case, key plate and installed frame. For Level, the switch-retaining plate and raised upper shell export as one removable part. The **Complete kit**, the default, also includes the open-bottom battery locator, cage, controller support and display support, and a printed washer for each M2 × 6 fastener: three per half on Flan36, one or three more on the larger sizes. It carries your keycaps too: each KLP Lamé file the design uses, unchanged, with `Keycaps/plan.csv` and a per-color list in the READ-ME. The online explorer fetches those files when you download; the offline copy lists them with a repository link instead. Commercial parts are excluded; [keycap fit guidance](customize.md#klp-lamé) remains separate.

The [historical support study](slim-mount-study.md) includes experimental plates with integrated washers and bases with integrated saddles. These reduce loose parts, not height. They predate the current floor-mounted battery and Level shell; their separate downloads are comparison geometry, not replacements in the current print kit.

- The structural case uses three M2 × 6 and two M2 × 4 screws per half. Tap the 1.7 mm pilot holes to M2.
- Each installed frame uses three captive Ø2 × 4 mm axial magnets, paired with three Ø2 × 3 mm axial magnets retained in its base. Use existing stock; each extra pair of frames needs six more Ø2 × 4 mm magnets.
- Check every pair's attraction in its final assembled orientation before capture; a frame printed upside down reverses the printing orientation. Follow the [polarity and heat checks](build.md#magnetic-frame-and-service).
- Cavities, guides and screw holes belong to the CAD geometry. Plan insertion pauses for captive hardware before slicing.
- There is no clip variant yet. A color or theme does not change the joining method.

The ZIP includes the selected geometry, JSON and a manifest with quantities, source hashes, units, colors and joining details. STL coordinates are the unchanged native assembly coordinates, in millimetres. Prepare orientation, supports, tolerances and your actual filament in the slicer.

This is prototype geometry. Print [fit coupons](cases.md) before a complete set. Neither magnets, tapped threads nor the whole assembly have physical acceptance yet.

## Color 3MF status

Decorated frames export as **multipart 3MF assemblies**: one recessed shell and separate closed volumes for the three inlay colors. All parts share one transform, so the inlays stay registered to their pockets. All colors finish at the **14.50 mm** roof. The five approved R4 frames use 0.4 mm surface inlays with 1.0 mm backing outside the display relief, a 0.865 mm through-color collar and a 0.4 mm through-color pin cover. Rejected shapes are excluded from the active viewer and its print kit. Hanafuda uses its exact approved R8 paths with the same construction. See the [construction rules](frames-extra.md).

These are complementary volumes for **co-printing**, not separately printed press-fit inserts. Use compatible colors of the same material and qualify their bonding on a small sample. The kit also includes the original aligned material STLs and a fused single-material STL. The fused file has a plain surface and cannot reproduce the color pattern by geometry alone.

The generic files contain no printer or process profile. The manifest records the common bed translation, colors, material roles and source hashes.

**Check the filament assignments in Bambu Studio.** Map **body, detail, accent and secondary** to the manifest colors and keep the material volumes together as one multipart object. Automatic palette assignment and slicer GUI save/reopen remain unverified. Inspect the sliced inlay layers before printing.

Keycaps are included in global themes. For independent colors, row/column patterns and portable personal palettes, use [Caps → Colors](customize.md#keycap-colors). Selecting another keycap shape preserves its assigned color.
