eduarbo/flan/docs/marketing/faq.md

# Preguntas y respuestas · EN / ES

**Estado al 13 de noviembre de 2026:** piezas del primer Flan36 encargadas, según Eduardo. Renders del diseño y archivos de prototipo disponibles. Armado, encaje y pruebas de funcionamiento físico pendientes.

| Pregunta | Respuesta ES | Answer EN |
|---|---|---|
| ¿Se puede comprar? | Hoy se comparten archivos para construir prototipos. No hay kit terminado, preventa ni fecha de venta anunciada. | Today the prototype files are available to build yourself. There is no finished kit, preorder or announced sale date. |
| ¿Ya funciona? | Hay archivos de PCB comprobados digitalmente y firmware compilado. Todavía no he ensamblado y probado el primer Flan físico. | The PCB files have digital checks and the firmware has been compiled. I have not assembled and tested the first physical Flan yet. |
| ¿Cuánto cuesta? | El costo depende de componentes, impresión, cantidad mínima de PCB, destino e impuestos. La lista de piezas es pública; falta un costo final medido y no hay precio de kit. | Cost depends on parts, printing, PCB minimum quantities, destination and taxes. The parts list is public; a final measured build cost and kit price are not available. |
| ¿Qué tamaños hay? | Flan36: 3×5+3 por mitad. Flan42 añade la columna exterior; Flan46 añade fila numérica; Flan54 añade ambas. El primer armado será Flan36. | Flan36: 3×5+3 per half. Flan42 adds the outer column; Flan46 adds a number row; Flan54 adds both. The first build is Flan36. |
| ¿Qué switches usa? | Diseñado para Kailh Choc v1 y sockets hot-swap. No afirmar compatibilidad con MX o Choc v2. | Designed for Kailh Choc v1 and hot-swap sockets. MX or Choc v2 compatibility is not claimed. |
| ¿Es inalámbrico? | Diseñado alrededor de nice!nano v2 y ZMK para BLE. Conexión, reconexión, reposo y autonomía siguen pendientes de medición. | Designed around nice!nano v2 and ZMK for BLE. Connection, reconnection, sleep and runtime still need hardware measurements. |
| ¿Cuánto dura la batería? | Todavía no hay una medición. La publicaré con tamaño de batería, firmware, uso y condiciones de la prueba. | There is no measurement yet. A future result should include battery size, firmware, usage and test conditions. |
| ¿Mejorará dolor o ergonomía? | Es un diseño dividido y escalonado por columnas. No tengo evidencia clínica ni una promesa de comodidad; la experiencia depende de la persona y su configuración. | It is split and column-staggered. I have no clinical evidence or comfort guarantee; the experience depends on the person and their setup. |
| ¿Qué hace distinto a Flan? | Combina tamaños, carcasas y marcos magnéticos intercambiables con un explorador para personalizar colores e inspeccionar/descargar el diseño. | It combines size, case and magnetic-frame choices with an explorer for choosing colors, inspecting the design and downloading files. |
| ¿Necesito soldar e imprimir? | Sí: es un proyecto DIY. Hot-swap se refiere a cambiar los switches después del montaje, no a que todo el teclado se arme sin soldadura. | Yes: this is a DIY project. Hot-swap means replacing switches after assembly, not that the entire keyboard is solder-free. |
| ¿Qué muestran las pantallas? | El diseño usa nice!view. Los dibujos de pantalla de los renders son ilustrativos; no son una prueba ni una vista exacta del firmware final. | The design uses nice!view. Screen artwork in the renders is illustrative; it is not a test or exact preview of the final firmware. |
| ¿Es abierto? | Las fuentes del proyecto usan GPL-3.0-or-later, junto con licencias de terceros documentadas. El nombre y los logos tienen una política de marca separada. | Project sources use GPL-3.0-or-later alongside documented third-party licenses. The name and logos have a separate trademark policy. |
| ¿Puedo usar estas imágenes? | Para hablar del proyecto, conserva el crédito, la marca de render/prototipo y las atribuciones aplicables. Consulta LICENSE, ATTRIBUTION.md y TRADEMARKS.md; no implica aval de un producto propio. | For project coverage, preserve the credit, render/prototype label and applicable attributions. See LICENSE, ATTRIBUTION.md and TRADEMARKS.md; it does not imply endorsement of your own product. |
| ¿Cómo ayudo? | Prueba el explorador, describe la configuración y reporta un problema reproducible en GitHub. Si construyes uno, comparte revisión, medidas y resultados de las pruebas. | Try the explorer and report reproducible problems with the configuration on GitHub. If you build one, share the revision, measurements and test results. |

## Respuestas breves

**ES · “Se ve caro / complicado”:** «Es un proyecto DIY y el montaje sí exige herramientas y soldadura. La lista de piezas está disponible para evaluar si te interesa; no lo presento como una compra lista para usar.»

**EN · “Looks expensive / complicated”:** “It is a DIY project and assembly does require tools and soldering. The parts list lets you judge whether it fits your project; I’m not presenting it as a ready-to-use purchase.”

**ES · “Solo es un render”:** «Sí, por ahora. Ya encargué las piezas y este material muestra el diseño que voy a probar. El siguiente paso es documentar el armado real, también si algo falla.»

**EN · “It is just a render”:** “Yes, for now. I’ve ordered the parts and this shows the design I’m going to test. The next step is documenting the real build, including anything that fails.”

**ES · “¿Es copia de Piantor?”:** «Flan36 conserva sus posiciones de teclas y lo acredita. Las PCB inalámbricas, carcasas y marcos de Flan están en sus fuentes; los créditos y términos de cada componente están en ATTRIBUTION.md.»

**EN · “Is it a Piantor copy?”:** “Flan36 follows its key positions and credits that source. Flan’s wireless PCBs, cases and frames are in the source files; component credits and terms are documented in ATTRIBUTION.md.”

No contestar ataques con anuncios repetidos. Corregir una afirmación falsa con el dato verificable; si falta una medición, decir qué falta sin inventarla.
