eduarbo/flan/(list of files, drawings)

Other design files:
design/pcb-options.json
validation/pcb-identity.json
validation/pcb-viewer.json
