eduarbo/flan/hardware/flan46/flan46-left.kicad_pcb

## KiCad design hardware/flan46/flan46-left.kicad_pcb (2026-11-13)

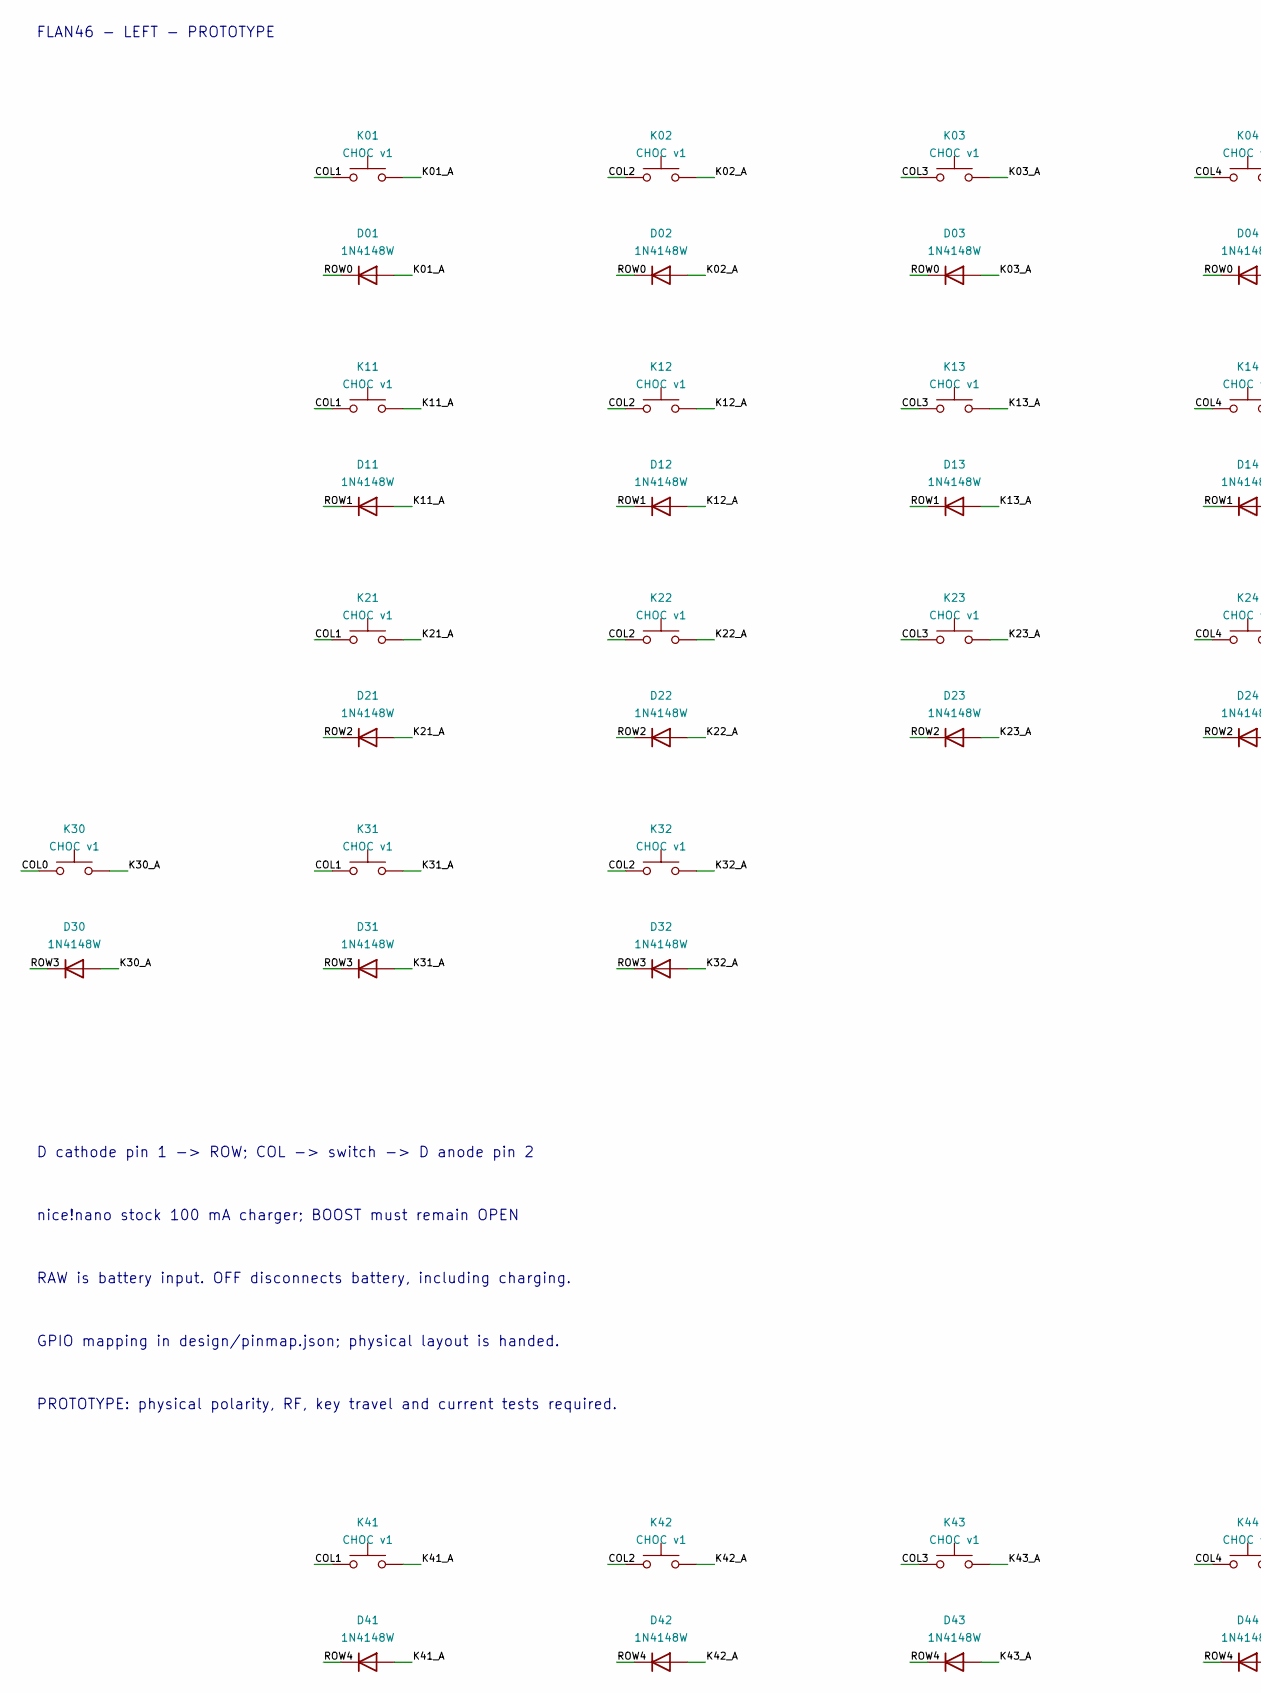
[picture p221: schematic flan46-left.kicad_sch, part in row 1, column 1]

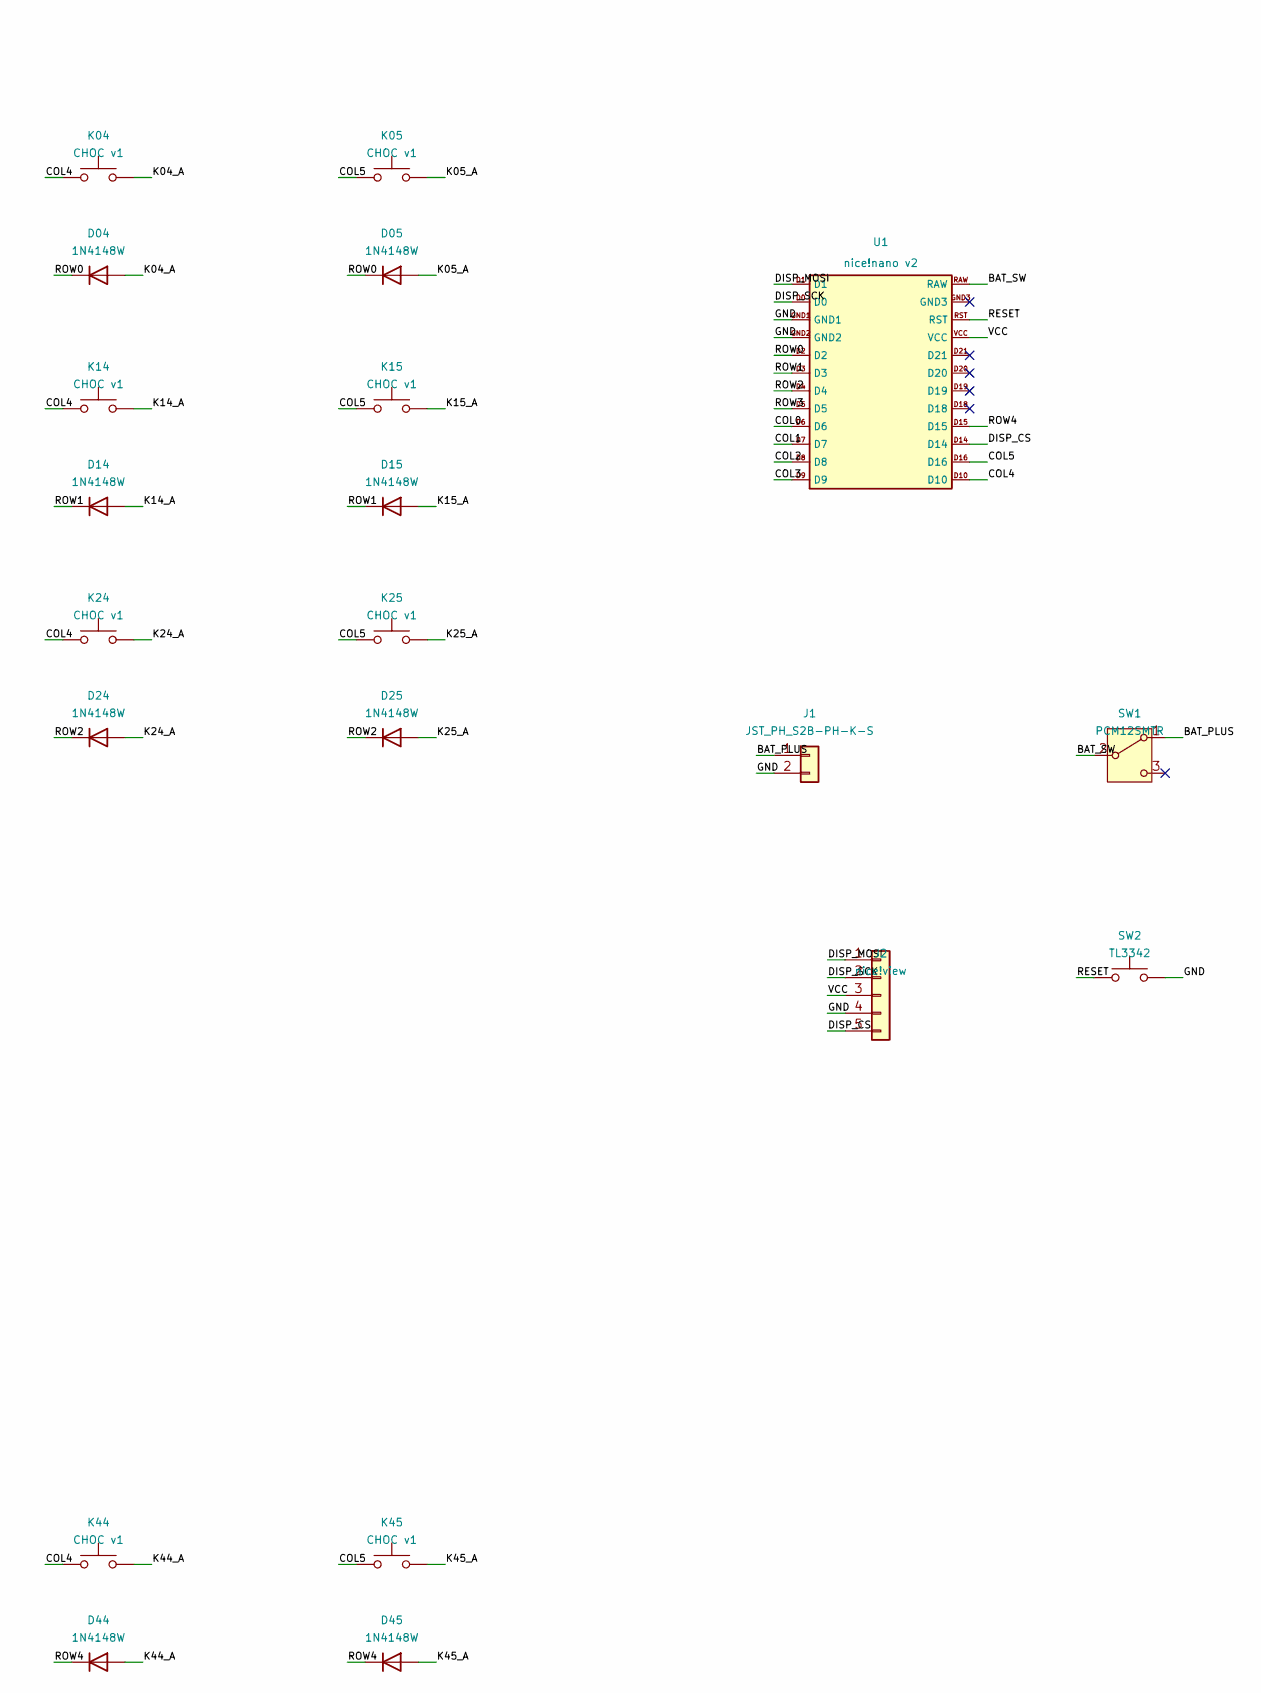
[picture p222: schematic flan46-left.kicad_sch, part in row 1, column 2]

Parts:
D01, D02, D03, D04, D05, D11, D12, D13, D14, D15, D21, D22, D23, D24, D25, D30, D31, D32, D41, D42, D43, D44, D45: 1N4148W; D_SOD-123
J1: JST_PH_S2B-PH-K-S; JST_PH_S2B-PH-K_1x02_P2.00mm_Horizontal
J2: nice!view; nice_view_5pin
K01, K02, K03, K04, K05, K11, K12, K13, K14, K15, K21, K22, K23, K24, K25, K30, K31, K32, K41, K42, K43, K44, K45: CHOC v1; Kailh_socket_PG1350_optional
SW1: PCM12SMTR; SW_SPDT_PCM12
SW2: TL3342; SW_SPST_TL3342
U1: nice!nano v2; nice_nano_v2_standard_edge

Connections:
/BAT_PLUS: J1.1, SW1.1 (A)
/BAT_SW: SW1.2 (B), U1.RAW
/COL0: K30.1, U1.D6
/COL1: K01.1, K11.1, K21.1, K31.1, K41.1, U1.D7
/COL2: K02.1, K12.1, K22.1, K32.1, K42.1, U1.D8
/COL3: K03.1, K13.1, K23.1, K43.1, U1.D9
/COL4: K04.1, K14.1, K24.1, K44.1, U1.D10
/COL5: K05.1, K15.1, K25.1, K45.1, U1.D16
/DISP_CS: J2.5, U1.D14
/DISP_MOSI: J2.1, U1.D1
/DISP_SCK: J2.2, U1.D0
/GND: J1.2, J2.4, SW2.2, U1.GND1, U1.GND2
/K01_A: D01.2 (A), K01.2
/K02_A: D02.2 (A), K02.2
/K03_A: D03.2 (A), K03.2
/K04_A: D04.2 (A), K04.2
/K05_A: D05.2 (A), K05.2
/K11_A: D11.2 (A), K11.2
/K12_A: D12.2 (A), K12.2
/K13_A: D13.2 (A), K13.2
/K14_A: D14.2 (A), K14.2
/K15_A: D15.2 (A), K15.2
/K21_A: D21.2 (A), K21.2
/K22_A: D22.2 (A), K22.2
/K23_A: D23.2 (A), K23.2
/K24_A: D24.2 (A), K24.2
/K25_A: D25.2 (A), K25.2
/K30_A: D30.2 (A), K30.2
/K31_A: D31.2 (A), K31.2
/K32_A: D32.2 (A), K32.2
/K41_A: D41.2 (A), K41.2
/K42_A: D42.2 (A), K42.2
/K43_A: D43.2 (A), K43.2
/K44_A: D44.2 (A), K44.2
/K45_A: D45.2 (A), K45.2
/RESET: SW2.1, U1.RST
/ROW0: D01.1 (K), D02.1 (K), D03.1 (K), D04.1 (K), D05.1 (K), U1.D2
/ROW1: D11.1 (K), D12.1 (K), D13.1 (K), D14.1 (K), D15.1 (K), U1.D3
/ROW2: D21.1 (K), D22.1 (K), D23.1 (K), D24.1 (K), D25.1 (K), U1.D4
/ROW3: D30.1 (K), D31.1 (K), D32.1 (K), U1.D5
/ROW4: D41.1 (K), D42.1 (K), D43.1 (K), D44.1 (K), D45.1 (K), U1.D15
/VCC: J2.3, U1.VCC

Notes on the sheet:
FLAN46 - LEFT - PROTOTYPE
D cathode pin 1 -> ROW; COL -> switch -> D anode pin 2
nice!nano stock 100 mA charger; BOOST must remain OPEN
RAW is battery input. OFF disconnects battery, including charging.
GPIO mapping in design/pinmap.json; physical layout is handed.
PROTOTYPE: physical polarity, RF, key travel and current tests required.

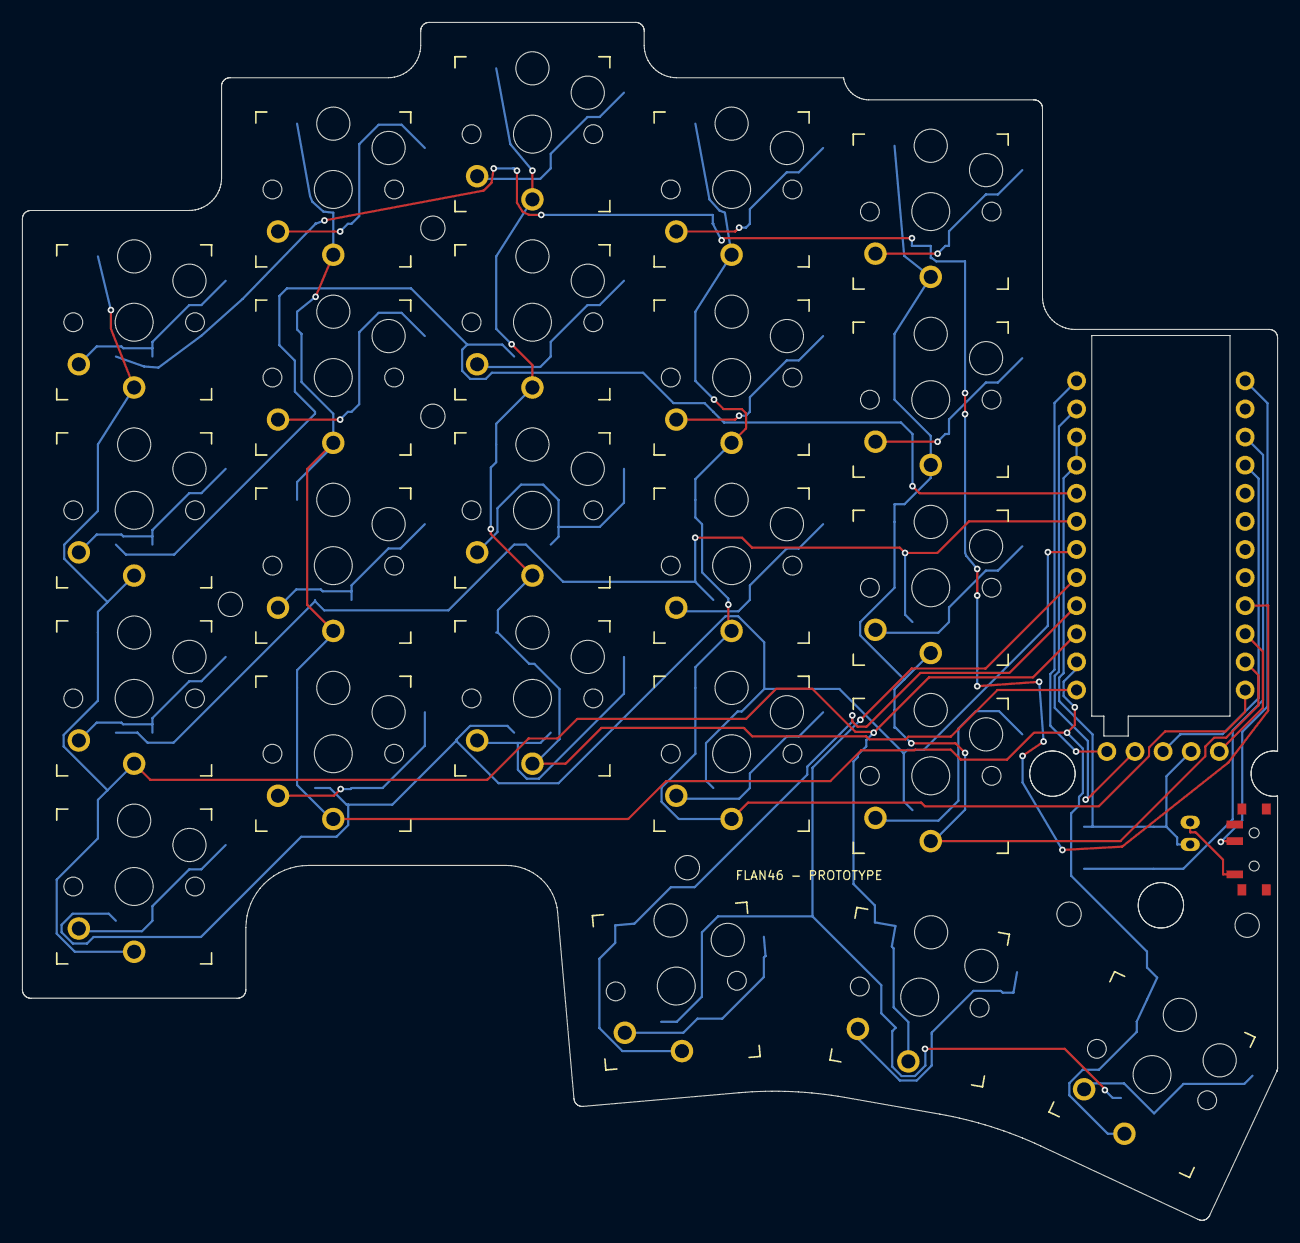
[picture p223: board flan46-left.kicad_pcb from above]

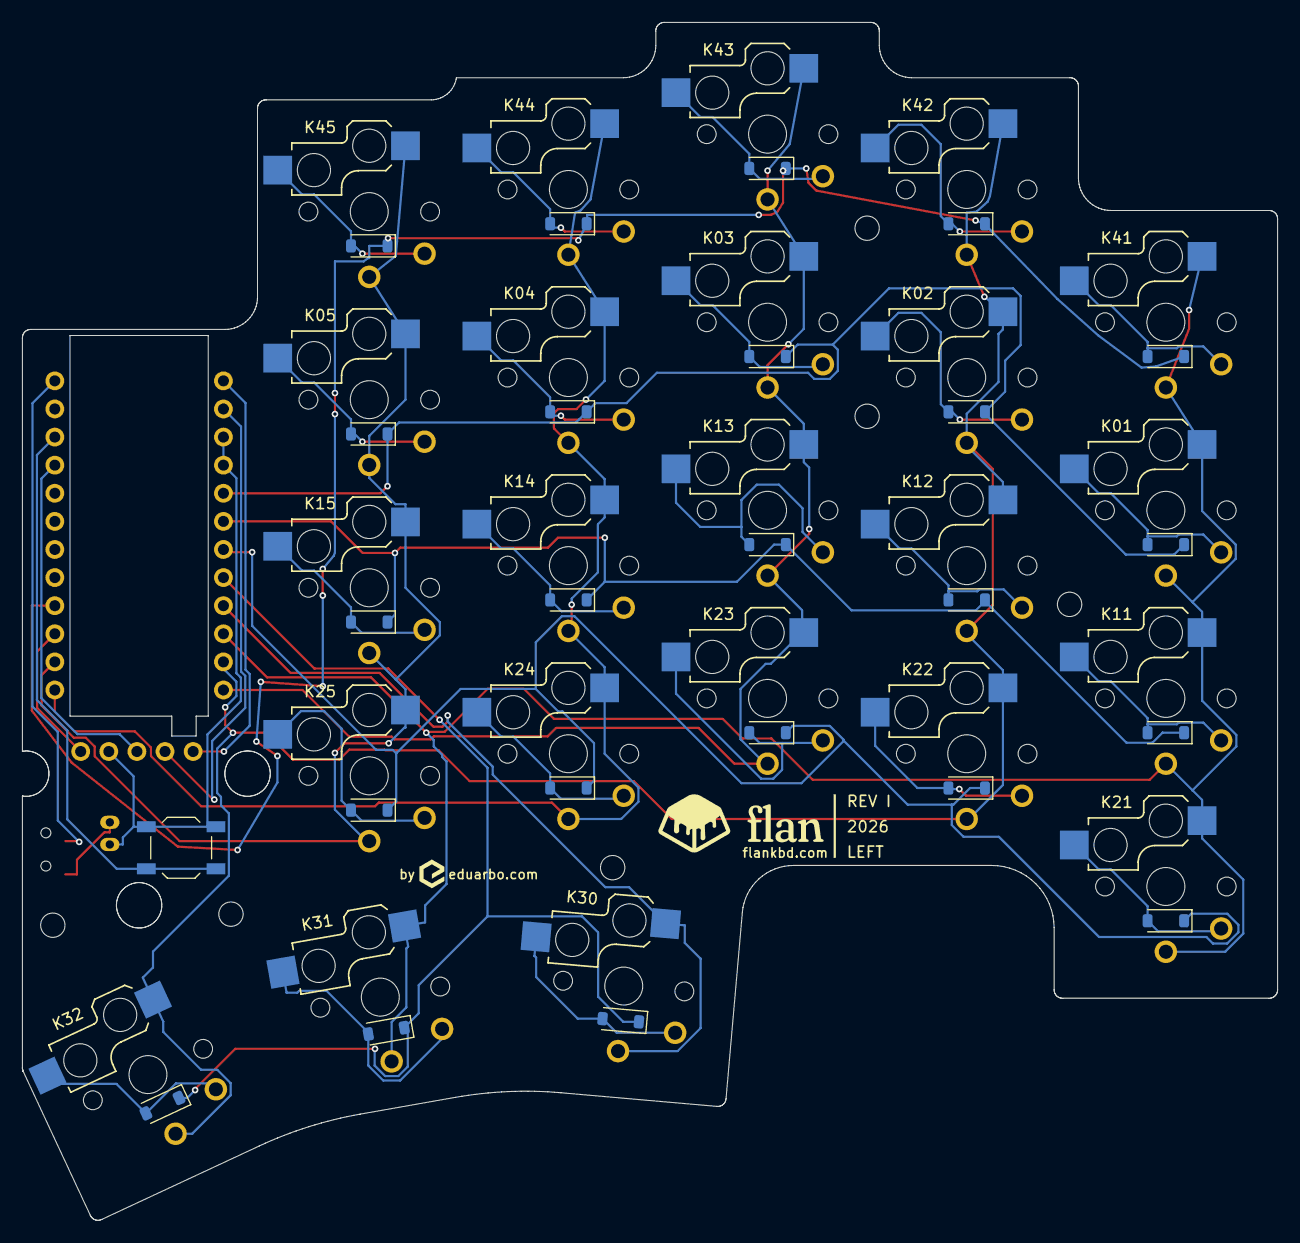
[picture p224: board flan46-left.kicad_pcb from below]

Board: 2 copper layers, 113.4 x 108.3 mm, 57 parts (24 on the bottom side), 42 nets.

Other parts of the board:
H1, H2, H3, H4, H5, H7: MountingHole_2.2mm_M2
