eduarbo/flan/tools/build_viewer_revI.py

#!/usr/bin/env python3
"""Pack unchanged revI meshes for the interactive viewer. Millimetres throughout.
SPDX-License-Identifier: GPL-3.0-or-later
"""
import base64
import hashlib
import json
from pathlib import Path
import numpy as np
import vtk
from vtk.util.numpy_support import vtk_to_numpy
from viewer_frame_selection import selected_catalog, selected_preset

ROOT = Path(__file__).resolve().parents[1]
model = json.loads((ROOT/'design/revI.json').read_text())
magnetic = json.loads((ROOT/'design/revI-magnets.json').read_text())
base_magnet_size = f'Ø{magnetic["magnet_diameter"]:g} × {magnetic["magnet_height"]:g} mm'
frame_magnet_size = f'Ø{magnetic["frame_magnet_diameter"]:g} × {magnetic["frame_magnet_height"]:g} mm'
layout = json.loads((ROOT/'design/layout.json').read_text())
scene = {'revision':'I', 'units':'mm', 'geometries':{}, 'parts':[], 'sources':[], 'batteryLeadProfiles':{}}
scene['frameArtwork']=model.get('frame_artwork',{'mode':'historical-mirrored'})
catalog=json.loads((ROOT/'keycaps/catalog.json').read_text())
frame_finishes=json.loads((ROOT/'design/frame-finishes.json').read_text())
selection=json.loads((ROOT/'design/frame-selection.json').read_text())
catalog=selected_catalog(catalog,frame_finishes,selection)
cfg=catalog['default_configuration'];variants={v['id']:v for v in catalog['variants']}
decorated_styles=set(frame_finishes['styles'])
frame_variants=model.get('frameVariants',{})
scene['catalog']=catalog
scene['presets']={p.stem:selected_preset(json.loads(p.read_text()),catalog,frame_finishes) for p in (ROOT/'design/configurations').glob('*.json')}
for p in sorted((ROOT/'design/configurations').glob('*.json')):
    scene['sources'].append({'path':p.relative_to(ROOT).as_posix(),'sha256':hashlib.sha256(p.read_bytes()).hexdigest()})
groups = {
    'tray':('Base', 'base', '#253639',0),
    'key-plate':('Plate', 'plate','#34494a',9),
    'electronics-lid':('Electronics cover','lid','#304d4e',72),
    'pcb':('PCB · routed prototype','pcb','#22664c',3),
    'diodes':('18 × SOD-123 diodes · underside','pcb','#34383b',3),
    'battery':('Battery · two profiles','battery','#b8c1bf',20),
    'mcu':('nice!nano v2 · nominal model','mcu','#1b433b',36),
    'display':('nice!view · nominal model','display','#172c2a',52),
    'cradle':('Open-bottom battery locator','supports','#78908a',20),
    'battery-retainer':('PCB-captured cage','supports','#78908a',24),
    'mcu-riser':('Controller support','supports','#647d78',36),
    'display-sled':('Display support','supports','#526e67',52),
    'mcu-sockets':('Controller sockets','connectors','#273631',3),
    'display-socket':('Display socket · retained on PCB','connectors','#273631',3),
    'jst':('Battery connector · envelope','connectors','#d9d3bc',3),
    'reset':('E-Switch TL3342','connectors','#545e58',3),
    'slider':('C&K PCM12','connectors','#45514a',3),
}


def digest(path):
    return hashlib.sha256((ROOT/path).read_bytes()).hexdigest()


def pack(array, dtype):
    return base64.b64encode(np.asarray(array,dtype=dtype).tobytes()).decode('ascii')


CAD_MESHES=('mechanical/revI/','mechanical/flan')   # FreeCAD exports: y up becomes z, mirrored


def mesh(path,store=None):
    store=scene['geometries'] if store is None else store
    if path in store:return path
    reader=vtk.vtkSTLReader();reader.SetFileName(str(ROOT/path));reader.Update()
    normals=vtk.vtkPolyDataNormals();normals.SetInputData(reader.GetOutput())
    normals.SetFeatureAngle(45);normals.ConsistencyOn();normals.AutoOrientNormalsOn();normals.Update()
    data=normals.GetOutput()
    points=vtk_to_numpy(data.GetPoints().GetData()).copy()[:,[0,2,1]]
    ns=vtk_to_numpy(data.GetPointData().GetNormals()).copy()[:,[0,2,1]]
    if path.startswith(CAD_MESHES):
        points[:,2]*=-1; ns[:,2]*=-1
    cells=vtk_to_numpy(data.GetPolys().GetData()).reshape(-1,4)
    assert np.all(cells[:,0]==3)
    # CAD (x,y,z) -> viewer (x,z,y) reflects handedness; reverse every triangle.
    indices=cells[:,[1,2,3] if path.startswith(CAD_MESHES) else [1,3,2]].reshape(-1)
    store[path]={'positions':pack(points,'<f4'),'normals':pack(ns,'<f4'),
                             'indices':pack(indices,'<u4'),'triangles':len(cells),
                             'bounds_mm':[points.min(axis=0).tolist(),points.max(axis=0).tolist()]}
    scene['sources'].append({'path':path,'sha256':digest(path)})
    return path


def colored_mesh(parent,visuals):
    positions=[];normals=[];indices=[];groups=[];colors=[];vertex=0;offset=0
    for v in visuals:
        source=scene['geometries'][mesh(v['path'])]
        a=lambda key,dtype:np.frombuffer(base64.b64decode(source[key]),dtype=dtype)
        p=a('positions','<f4');n=a('normals','<f4');i=a('indices','<u4')
        positions.append(p);normals.append(n);indices.append(i+vertex)
        groups.append({'start':offset,'count':len(i),'materialIndex':len(colors)});colors.append(v['color']);vertex+=len(p)//3;offset+=len(i)
    ident=parent+'#materials';ps=np.concatenate(positions)
    scene['geometries'][ident]={'positions':pack(ps,'<f4'),'normals':pack(np.concatenate(normals),'<f4'),'indices':pack(np.concatenate(indices),'<u4'),'triangles':offset//3,'groups':groups,'bounds_mm':[ps.reshape(-1,3).min(0).tolist(),ps.reshape(-1,3).max(0).tolist()]}
    return ident,colors


def frame_materials(side,style):
    """Use native volume boundaries, never triangle-centroid surface painting."""
    ident=f'{side}-frame-{style}'
    parts=frame_variants.get(f'{side}-{style}',{}).get('material_parts',[])
    if style in decorated_styles and not parts:
        raise ValueError(f'Missing native flush materials for {ident}; regenerate CAD exports')
    if not parts:return []
    roles=[part['role'] for part in parts]
    assert 'body' in roles and len(roles)==len(set(roles)),(ident,'missing/duplicate roles')
    positions=[];normals=[];indices=[];groups=[];vertex=0;offset=0
    for part in parts:
        assert part['role'] in frame_finishes['roles'],(ident,part['role'])
        filename=part['stl'];assert Path(filename).name==filename,(ident,'expected STL basename')
        source=scene['geometries'][mesh('mechanical/revI/'+filename)]
        unpack=lambda key,dtype:np.frombuffer(base64.b64decode(source[key]),dtype=dtype)
        p=unpack('positions','<f4');n=unpack('normals','<f4');i=unpack('indices','<u4')
        assert len(i)>0 and len(i)%3==0,(ident,part['role'],'empty material')
        positions.append(p);normals.append(n);indices.append(i+vertex)
        groups.append({'start':offset,'count':len(i),'materialIndex':frame_finishes['roles'].index(part['role'])})
        vertex+=len(p)//3;offset+=len(i)
    ps=np.concatenate(positions)
    scene['geometries'][f'mechanical/revI/{ident}.stl']={
        'positions':pack(ps,'<f4'),'normals':pack(np.concatenate(normals),'<f4'),
        'indices':pack(np.concatenate(indices),'<u4'),'triangles':offset//3,'groups':groups,
        'material_parts':[{'role':p['role'],'path':'mechanical/revI/'+p['stl']} for p in parts],
        'bounds_mm':[ps.reshape(-1,3).min(0).tolist(),ps.reshape(-1,3).max(0).tolist()]}
    return parts

def add(name,side,group,color,position,explode,geometry=None,primitive=None,angle=0):
    part={'name':side+' · '+name,'side':side,'group':group,'color':color,
          'position':position,'explode_mm':explode,'angle_deg':angle}
    if geometry:
        part['geometry']=geometry
        if geometry.startswith('mechanical/revI/'):
            part['part_id']=Path(geometry.split('#')[0]).stem
    if primitive:part['primitive']=primitive
    scene['parts'].append(part)


socket_geometry,socket_colors=colored_mesh('choc-hotswap',model['hotswap_model']['visuals'])
switches=json.loads((ROOT/'components/switches.json').read_text());switch_meshes={name:colored_mesh(name,entries) for name,entries in switches.items() if isinstance(entries,list)}

for side,keys in layout['halves'].items():
    offset=0 if side=='left' else 161
    for name,(label,group,color,explode) in groups.items():
        path=f'mechanical/revI/{side}-{name}.stl';visuals=model['parts'][side+'-'+name].get('visuals',[])
        if name=='electronics-lid':
            path=f'mechanical/revI/{side}-frame-{cfg["frames"][side]["style"]}.stl';visuals=[]
        geometry,colors=colored_mesh(path,visuals) if visuals else (mesh(path),None)
        add(label,side,group,color,[offset,0,0],explode,geometry)
        if colors:scene['parts'][-1]['materials']=colors
    for socket in model['hotswap_model']['instances'][side]:
        position=list(socket['position_mm']);position[0]+=offset
        add('Hot-swap '+socket['reference'],side,'pcb',socket_colors[0],position,3,socket_geometry,angle=socket['angle_deg'])
        scene['parts'][-1]['materials']=socket_colors
    for i in range(1,4):
        add(f'Washer {i}',side,'fasteners','#89918a',[offset,0,0],9,mesh(f'mechanical/revI/{side}-washer-{i}.stl'))
    for style in catalog['case_styles']:
        for group in ['base','plate']:mesh(f'mechanical/revI/{side}-case-{style}-{group}.stl')
    for style in catalog['frame_styles']:
        mesh(f'mechanical/revI/{side}-frame-{style}.stl')
        frame_materials(side,style)
    for key in keys:
        choice=cfg['keycaps'][side][key['ref']];v=variants[choice['variant']]
        add('KLP '+key['ref'],side,'keycaps','#45967b' if key['row']==3 else '#e9dfc6',
            [offset+key['x'],v['seating_z_mm'],key['y']],22,mesh(v['path']),angle=key['angle']+choice['rotation_deg'])
        scene['parts'][-1]['key_ref']=key['ref']
        for name,label in [('choc-body','Choc housing'),('choc-stem','Choc stem')]:
            geometry,colors=switch_meshes[name]
            add(label+' '+key['ref'],side,'switches',colors[0],[offset+key['x'],5.4,key['y']],14,geometry=geometry,angle=key['angle'])
            scene['parts'][-1]['materials']=colors
    for i in range(1,6):add(f'Structural screw {i}',side,'fasteners','#56615b',[offset,0,0],9,mesh(f'mechanical/revI/{side}-screw-{i}.stl'))
    for i in range(3):
        add(f'Captive base magnet {i+1} · {base_magnet_size}',side,'fasteners','#8c9597',[offset,0,0],0,mesh(f'mechanical/revI/{side}-magnet-{i}.stl'))
        add(f'Captive frame magnet {i+1} · {frame_magnet_size}',side,'lid','#899193',[offset,0,0],72,mesh(f'mechanical/revI/{side}-frame-target-{i}.stl'))
    for i in range(2):
        profile=model['batteryLeadProfiles'][f'{side}-{cfg["batteries"][side]}']
        lead=next(part for part in profile if part['index']==i)
        add(f'Battery lead {i+1}',side,'connectors',lead.get('color','#ad453d' if i==0 else '#353738'),[offset,0,0],24,mesh(f'mechanical/revI/{side}-battery-lead-{i}.stl'))
        scene['parts'][-1]['battery_lead_index']=i
    for ident in catalog['battery_profiles']:
        mesh(f'mechanical/revI/{side}-battery-{ident}.stl')
        leads=model['batteryLeadProfiles'][f'{side}-{ident}']
        assert sorted(part['index'] for part in leads)==[0,1],(side,ident,'battery lead pair missing')
        scene['batteryLeadProfiles'][f'{side}-{ident}']=[]
        for part in leads:
            filename=f'{side}-battery-lead-{ident}-{part["index"]}.stl'
            assert part['stl']==filename,(side,ident,'unexpected lead filename')
            path=mesh('mechanical/revI/'+filename)
            scene['batteryLeadProfiles'][f'{side}-{ident}'].append({'index':part['index'],'geometry':path,
                'color':part.get('color','#ad453d' if part['index']==0 else '#353738')})
    for i,(x,y) in enumerate([(26,26),(57,15),(28,70),(125,83)]):
        add(f'Foot {i+1}',side,'fasteners','#29352e',[offset+(x if side=='left' else 160-x),-.6,y],0,
            primitive={'kind':'cylinder','radius':3,'height':1.2})
    display_bounds=model['parts'][side+'-display']['bounds_mm']
    cx=(display_bounds[0]+display_bounds[3])/2
    add('LCD · illustrative content',side,'display','#c5d1ba',[offset+cx,model['parameter_values_mm']['DisplayBottom']+1.92,33.9],52,
        primitive={'kind':'screen','size':[10.744,.025,25.28],'text':'BASE / BLE / L' if side=='left' else 'LINK / BAT / R'})

for v in catalog['variants']:
    if v['qualified_reference_positions']:mesh(v['path'])

# Flan family. Each built variant brings its own case and PCB meshes and printable case STLs,
# loaded on demand (viewer/build.mjs defers them like the print kit). Its added keys and
# fasteners are parts shown only on the variants that have them: copies of the template
# key's keycap, switch and hot-swap, and of H1's screw and washer, at the variant's centres.
family=json.loads((ROOT/'design/variants.json').read_text())
scene['variants']={}
scene['sources'].append({'path':'design/variants.json','sha256':digest('design/variants.json')})
added_parts={}
for vid,v in family['variants'].items():
    entry={'id':vid,'title':v['title'],'grid':v['grid_per_half'],'keys_total':v['keys_total'],
           'case_size_mm':v['case_size_mm'],'added':v['added_per_half'],'built':vid=='flan36',
           'drawing':'data:image/svg+xml;base64,'+base64.b64encode((ROOT/f'docs/images/variants/{vid}.svg').read_bytes()).decode()}
    receipt=ROOT/f'validation/{vid}-case.json'
    if vid!='flan36' and receipt.exists():
        case=json.loads(receipt.read_text())
        entry.update(built=True,printing={},meshes={},fasteners={})
        scene['sources'].append({'path':f'validation/{vid}-case.json','sha256':digest(f'validation/{vid}-case.json')})
        for side in ['left','right']:
            for style in catalog['case_styles']:
                for group in ['base','plate']:
                    path=f'mechanical/{vid}/{side}-case-{style}-{group}.stl'
                    assert digest(path)==case['halves'][side]['cases'][style][group]['stl_sha256'],(path,'stale variant case')
                    scene['sources'].append({'path':path,'sha256':digest(path)})
                    name=f'{side}-case-{style}-{group}'
                    entry['printing'][name]={'id':name,'path':path,'sha256':digest(path),'stl':base64.b64encode((ROOT/path).read_bytes()).decode()}
            # one exact copy of each STL: the viewer builds its render mesh from it
            path=f'mechanical/{vid}/{side}-pcb.stl'
            entry['meshes'][path]=base64.b64encode((ROOT/path).read_bytes()).decode();scene['sources'].append({'path':path,'sha256':digest(path)})
            entry['fasteners'][side]=case['halves'][side].get('fasteners',{})
        # its silkscreen editions, when build_silkscreen_textures.py has rasterized its packages
        vt=json.loads((ROOT/'build/silkscreen-textures/manifest.json').read_text()).get('variants',{}).get(vid)
        if vt:
            entry['silkscreen']={'bounds':vt['bounds'],'textures':{},'thumbnails':{}}
            for edition,halves in vt['textures'].items():
                for half,t in halves.items():
                    assert digest(t['source']['package'])==t['source']['sha256'] and digest(t['path'])==t['sha256'],(vid,edition,half,'stale silkscreen texture')
                    entry['silkscreen']['textures'].setdefault(edition,{})[half]=base64.b64encode((ROOT/t['path']).read_bytes()).decode()
                    scene['sources'].append({'path':t['source']['package'],'sha256':t['source']['sha256']})
            for edition,t in vt['thumbnails'].items():
                entry['silkscreen']['thumbnails'][edition]='data:image/webp;base64,'+base64.b64encode((ROOT/t['path']).read_bytes()).decode()
        zips={s:f'hardware/{vid}/fabrication/{vid}-{s}-prototype.zip' for s in ('left','right')}
        if all((ROOT/z).exists() for z in zips.values()):entry['gerbers']=zips
        keys={side:{k['ref']:k for k in v['keys'][side]} for side in ['left','right']}
        for side in ['left','right']:
            offset=0 if side=='left' else 161
            for ref in v['added_per_half']:
                k=keys[side][ref];tref='K01' if ref=='K40' else (f"K{k['row']}1" if k['col']==0 else f"K0{k['col']}")
                t=keys[side][tref];added_parts.setdefault((side,ref),{'k':k,'t':t,'variants':[]})['variants'].append(vid)
            for n,f in entry['fasteners'][side].items():
                added_parts.setdefault((side,n),{'fastener':f,'variants':[]})['variants'].append(vid)
    scene['variants'][vid]=entry
sockets={side:{s['reference']:s for s in model['hotswap_model']['instances'][side]} for side in ['left','right']}
h1={side:next(m for m in json.loads((ROOT/'design/revI-mounts.json').read_text())['left'] if m['id']=='H1')['xy'] for side in ['left','right']}
for (side,ref),a in sorted(added_parts.items()):
    offset=0 if side=='left' else 161
    first=len(scene['parts'])
    if 'fastener' in a:
        x,y=a['fastener']['xy_mm'];hx,hy=h1[side]
        if side=='right':hx=160-hx
        add(f'Structural screw {ref[1:]}',side,'fasteners','#56615b',[offset+x-hx,0,y-hy],9,mesh(f'mechanical/revI/{side}-screw-1.stl'))
        add(f'Washer {ref[1:]}',side,'fasteners','#89918a',[offset+x-hx,0,y-hy],9,mesh(f'mechanical/revI/{side}-washer-1.stl'))
    else:
        k,t=a['k'],a['t'];choice=cfg['keycaps'][side][t['ref']];cap=variants[choice['variant']]
        add('KLP '+ref,side,'keycaps','#e9dfc6',[offset+k['x'],cap['seating_z_mm'],k['y']],22,mesh(cap['path']),angle=k['angle']+choice['rotation_deg'])
        scene['parts'][-1]['key_ref']=ref
        for name,label in [('choc-body','Choc housing'),('choc-stem','Choc stem')]:
            geometry,colors=switch_meshes[name]
            add(label+' '+ref,side,'switches',colors[0],[offset+k['x'],5.4,k['y']],14,geometry=geometry,angle=k['angle'])
            scene['parts'][-1]['materials']=colors
        sock=sockets[side][t['ref']];position=list(sock['position_mm'])
        position[0]+=offset+k['x']-t['x'];position[2]+=k['y']-t['y']
        add('Hot-swap '+ref,side,'pcb',socket_colors[0],position,3,socket_geometry,angle=sock['angle_deg'])
        scene['parts'][-1]['materials']=socket_colors
    for part in scene['parts'][first:]:
        part['variants']=a['variants'];part.pop('part_id',None)
        if 'k' in a:part['template_ref']=a['t']['ref']
# Exact native bytes; never derive printable parts from the presentation scene.
printing={'assets':{},'supports':['cradle','battery-retainer','mcu-riser','display-sled','washer-1','washer-2','washer-3'],
 'joining':{'case':'3 M2x6 + 2 M2x4 per half; tap the 1.7 mm pilots to M2',
 'installed_frame':f'Per half: 3 captive base magnets {base_magnet_size} and 3 captive frame magnets {frame_magnet_size}; all axially magnetized',
 'polarity':'Opposite poles must face each other in the final assembly. Mark the mating faces and check attraction at every station before embedding. Keep the same base orientation and matching frame orientation across interchangeable frames. When printing a frame upside down, use its final mating face, not the face pointing upward on the printer.',
 'capture':'For both base and frame magnets, inspect the sliced cavities and pause before closure. Confirm every insert remains below the next nozzle path. Qualify capture, actual thermal exposure and removal cycles with the actual magnets and filament; use the temperature limit for those magnets, not an assumed grade.',
 'clips':False,'acceptance':'Physical fit, thread strength, retention force and insertion process untested'}}
for side in ['left','right']:
    names=[f'{side}-case-{style}-{group}' for style in catalog['case_styles'] for group in ['base','plate']]
    names += [f'{side}-frame-{style}' for style in catalog['frame_styles']]
    names += [f'{side}-{name}' for name in printing['supports']]
    for name in names:
        path=f'mechanical/revI/{name}.stl'
        if name.split(side+'-')[1] in printing['supports']:assert model['parts'][name]['prototype_part']
        printing['assets'][name]={'id':name,'path':path,'sha256':digest(path),'stl':base64.b64encode((ROOT/path).read_bytes()).decode()}
        if name.startswith(side+'-frame-'):
            style=name[len(side+'-frame-'):]
            material_parts=frame_variants.get(f'{side}-{style}',{}).get('material_parts',[])
            if material_parts:
                printing['assets'][name]['material_parts']=[]
                for part in material_parts:
                    material_path='mechanical/revI/'+part['stl']
                    printing['assets'][name]['material_parts'].append({'role':part['role'],
                        'path':material_path,'sha256':digest(material_path),
                        'stl':base64.b64encode((ROOT/material_path).read_bytes()).decode()})
scene['printing']=printing
# Optional screw profiles: the default kit's plates and frames with other head pockets. Exact native
# exports bound to their delivery receipt; viewer/build.mjs defers them like a variant's files.
fastener_profiles=json.loads((ROOT/'design/fastener-profiles.json').read_text())
scene['fasteners']={'default':fastener_profiles['default'],'profiles':{}}
scene['sources'].append({'path':'design/fastener-profiles.json','sha256':digest('design/fastener-profiles.json')})
for ident,profile in fastener_profiles['profiles'].items():
    if 'meshes' not in profile:continue
    receipt=json.loads((ROOT/profile['receipt']).read_text());folder=profile['meshes']
    assert receipt['spec']['sha256']==digest(profile['spec']),(ident,'specification changed after its receipt')
    assert receipt['native']['source_sha256']==digest('mechanical/revI/Flan36.FCStd'),(ident,'default CAD changed after the profile was exported; install and adopt it again')
    def native(path):
        """The profile's export of a default file, or that file where the profile leaves it unchanged."""
        candidate=f'{folder}/{Path(path).name}'
        if candidate in receipt['files']:
            assert digest(candidate)==receipt['files'][candidate],(candidate,'stale profile mesh')
            scene['sources'].append({'path':candidate,'sha256':digest(candidate)});return candidate
        assert receipt['unchanged'].get(Path(path).stem)==digest(path),(path,'not covered by the profile receipt')
        return path
    packed=lambda path:{'path':path,'sha256':digest(path),'stl':base64.b64encode((ROOT/path).read_bytes()).decode()}
    entry={'id':ident,'variants':profile['variants'],'spec':json.loads((ROOT/profile['spec']).read_text()),
           'joining_case':profile['joining_case'],'long_head_gap_mm':receipt['long_heads']['gap_mm'],'printing':{}}
    for name,asset in printing['assets'].items():
        if not (name.endswith('-plate') or '-frame-' in name):continue
        path=native(asset['path']);assert path!=asset['path'],(name,'the profile does not change this printable')
        entry['printing'][name]={'id':name,**packed(path)}
        if 'material_parts' in asset:
            entry['printing'][name]['material_parts']=[{'role':part['role'],**packed(native(part['path']))} for part in asset['material_parts']]
    for path in (profile['spec'],profile['receipt']):scene['sources'].append({'path':path,'sha256':digest(path)})
    scene['fasteners']['profiles'][ident]=entry
top_key=min(k['y']-8.244852066 for k in layout['halves']['left'] if k['row']==0)
adjacent=next(k for k in layout['halves']['left'] if k['ref']=='K05')['y']-8.244852066
hood_min=min(p[1] for p in model['halves']['left']['electronics_cover'])
frame_top=model['parameter_values_mm']['FrameTop']
scene['measurements']={'bay_width_mm':24,'plate_top_mm':7.6,'cover_top_mm':frame_top,'themed_relief_top_mm':frame_top,
                       'decoration_relief_mm':0,'frame_materials':'Native recessed co-print volumes; flush top',
                       'cover_ahead_of_top_cap_mm':round(max(0,top_key-hood_min),3),
                       'cover_ahead_of_adjacent_cap_mm':round(max(0,adjacent-hood_min),3)}
for path in ['design/revI.json','design/revI-magnets.json','design/layout.json','tools/build_viewer_revI.py','tools/viewer_frame_selection.py','design/frame-selection.json','design/frame-finishes.json','components/switches.json','components/sources.json','keycaps/catalog.json']:
    scene['sources'].append({'path':path,'sha256':digest(path)})
scene['limits']=['Commercial representations combine documented nominal dimensions, licensed community CAD and inferred package detail; see components/README.md', 'Routed PCB candidate; physical electrical, connector and RF qualification pending',
                 'Nominal lead-storage paths; actual terminations, insulation and finished-pack tolerances unverified', 'PCB aperture 12.5 mm; both nominal cells fit. Magnetic force, print-in capture/temperature and physical fit need coupons',
                 'Generic Choc v1 source model; purchased switch fit, keycap seating and travel unmeasured. Hot-swap sockets are registered to nominal PCB datums; purchased-part fit remains unqualified. Feet illustrative; nominal screws do not prove thread strength',
                 'Exploded positions are a viewing aid, not a validated extraction path']
# Back-silkscreen editions: textures rasterized from the committed Gerber packages
# (tools/build_silkscreen_textures.py); the viewer lays them under each PCB.
editions=json.loads((ROOT/'design/pcb-options.json').read_text())
textures=json.loads((ROOT/'build/silkscreen-textures/manifest.json').read_text())
pcb=np.frombuffer(base64.b64decode(scene['geometries']['mechanical/revI/left-pcb.stl']['positions']),dtype=np.float32).reshape(-1,3)
scene['silkscreen']={'default':editions['default_edition'],'default_mask':editions['default_mask'],'masks':editions['masks'],'masks_source':editions['masks_source'],'bottom_mm':round(float(pcb[:,1].min()),4),'bounds':textures['bounds'],
    'editions':[{k:e[k] for k in ('id','title','description','packages','variants') if k in e} for e in editions['editions']],'textures':{}}
for e in editions['editions']:
    for half,package in e['packages'].items():
        t=textures['textures'][e['id']][half]
        assert t['source']['package']==package and t['source']['sha256']==digest(package),(e['id'],half,'stale silkscreen texture')
        assert digest(t['path'])==t['sha256'],(e['id'],half,'texture changed after its manifest')
        scene['silkscreen']['textures'].setdefault(e['id'],{})[half]=base64.b64encode((ROOT/t['path']).read_bytes()).decode()
        scene['sources'].append({'path':package,'sha256':t['source']['sha256']})
scene['silkscreen']['thumbnails']={e['id']:'data:image/webp;base64,'+base64.b64encode((ROOT/textures['thumbnails'][e['id']]['path']).read_bytes()).decode() for e in editions['editions']}
scene['sources'].append({'path':'design/pcb-options.json','sha256':digest('design/pcb-options.json')})
(ROOT/'build').mkdir(exist_ok=True)
(ROOT/'build/viewer-scene.json').write_text(json.dumps(scene,separators=(',',':'))+'\n')
print(f'Packed {len(scene["parts"])} objects, {len(scene["geometries"])} unchanged meshes; 36 keycaps.')
