eduarbo/flan/(commit log)

2026-10-11 Complete supplied display connector and build purchasing package
2026-10-11 Constrain plate checksum exceptions and verify secret detection controls
2026-10-11 Use paired magnets for removable frames
2026-10-12 Refine connector openings and deliver final viewer controls
2026-10-12 Polish camera view icons and responsive spacing
2026-10-17 Propose circuit-language silkscreen designs for revI boards
    Add three front-side concepts (Caramelo, Contorno, Barrido) and a shared
    back maker's plate for both routed revI halves, with a reproducible
    generator. Each concept is checked against pads, holes, edge and existing
    legends, injected into scratch board copies, passes KiCad DRC with no
    violations and reads back exactly. The routed PCBs and fabrication
    packages are unchanged pending a choice.
2026-10-17 Propose all-over circuit silkscreen patterns for revI backs
    Add seven one-ink patterns (Campo, Aislamiento, Ruteo, Meandro, Vias,
    Bus, Senal) drawn as one continuous composition across both halves seen
    from below, clipped around pads, holes, legends and part bodies, with
    the maker's plate in a cleared cartouche. All 14 scratch boards pass
    KiCad DRC with no violations and read back exactly. R1 accent designs
    are marked superseded; routed PCBs and fabrication packages unchanged.
2026-10-17 Install Campo back silkscreen on both revI boards
    Add the R2 Campo pattern and the Flan36 plate to B.SilkS of both routed
    boards as one "silkscreen-art" group, via a new installer that refuses
    stale art or a second install and records validation/revI-silkscreen.json.
    The routing check (pads, poses, outline, DRC/ERC/parity) passes and the
    regenerated Gerber packages differ only in B_Silkscreen; copper, mask,
    outline and drill data are unchanged apart from export dates. Proposal
    generators now refuse boards that already carry installed art.
2026-10-17 Record public readback of Campo silkscreen fabrication packages
2026-10-17 Propose kumiko and wagara silkscreen patterns (R3)
    Add Asanoha and Kikko kumiko panels drawn by slat outline with via
    joints and a halftone of inserted pieces, the Sayagata fret as a
    continuous meander, Seigaiha with via stitching and Shippo with via
    nodes; Meandro and Vias are carried from R2. All 14 scratch boards,
    checked on the routed boards with the installed Campo removed, pass
    KiCad DRC and read back exactly.
    The spacing filter now trims clipped strokes locally and requeues split
    pieces instead of dropping whole components, art is repaired without
    losing area, the R2 pipeline is reusable, and the installer can replace
    an installed pattern after verifying the routed base.
    Co-Authored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
2026-10-17 Propose names and logos for the keyboard family (naming R1)
    Record four candidates (Kumi, Telar, Nopal, Seda) with rationale and a
    web/GitHub/QMK collision check, the family rule <Name> <keys> for the
    36/42/46/54 variants, and font-free monoline lettering and marks drawn
    in code. SVG masters are in millimetres for silkscreen or relief. The
    project keeps the Flan36 identity until a name is chosen.
2026-10-17 Propose elegant name identities (naming R2)
    Replace R1's code-drawn lettering with three identities: Kumi (asanoha
    kumiko, with a split alternate), Seda (seigaiha crest) and Telar
    (diagonal weave). Marks are exact fine-line geometry with a display and
    a small construction for the PCB plate or relief, exported as closed
    millimetre outlines; wordmarks are set in OFL typefaces. Nopal is
    dropped as the least elegant. The project keeps Flan36 until a choice.
2026-10-17 Propose logo variants for Kumi, Telar and Flan (naming R3)
    Add mark variants in the fine-line system: Kumi split, key (mitsukude
    cube) and mon; Telar keycap and warp; and four Flan marks, including a
    Choc keycap in profile read as a flan. Each mark has display and small
    constructions exported as millimetre outlines. The comparison page lets
    the owner combine mark, typeface and layout per name, next to the
    current Outline symbol. Nothing is renamed yet.
2026-10-17 Record Flan as the name and redraw tecla-flan marks (naming R4)
    The owner chose Flan. Redraw the keycap-as-flan idea with one shared
    cap built from tangent arcs and a caramel glaze whose teardrop drips
    join through real fillets, in six variants: glaseado, solido, patitas,
    un-trazo, iso and linea. Each has a display and a small construction
    for the 6-10 mm silkscreen plate, exported as millimetre outlines. The
    logo is still to be chosen; nothing is installed.
2026-10-17 Adopt the Flan logo, sign the boards and ship silkscreen editions
    Build the Flan logo kit: the three-quarter tecla-flan mark beside
    "flan" in Fraunces (OFL) outlined with HarfBuzz, in display and
    silkscreen constructions. Install it on the back of both routed revI
    boards as the flan-signature group with REV I, 2026, the half and
    eduarbo.com, removing the Campo pattern. Routing, DRC/ERC/parity and
    the base fabrication packages are re-verified.
    Export six back-silkscreen editions (Asanoha, Kikko, Sayagata,
    Seigaiha, Meandro, Vias) as separate Gerber packages, each composed
    across both halves around the signature. Every edition and half passes
    DRC with schematic parity, reads back exactly and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
2026-10-17 Point sources and pages at the renamed repository eduarbo/flan
    The repository was renamed from eduarbo/flan36 to eduarbo/flan (same
    id 1380608588) to hold the whole Flan family. Replace only exact
    repository URLs and slugs in current sources, docs and the generated
    viewer pages, with a byte proof that each changed line differs only in
    those URLs; model identifiers and historical receipts are unchanged.
    The old Pages address no longer resolves; GitHub redirects repository,
    git and raw links.
2026-10-18 Add a PCB tab to pick silkscreen edition and solder mask colour
    The viewer's Design → PCB tab lists the base board and the six silkscreen
    editions, turns the model to the underside and links the matching Gerber
    ZIPs. A second row offers JLCPCB's seven solder-mask colours, with the
    silkscreen ink each one gets. Both choices are saved in the design JSON
    (pcb_edition, pcb_mask) and checked by the JS and Python config loaders.
    The back-silkscreen textures are rasterized from the fabrication ZIPs
    themselves (tools/build_silkscreen_textures.py) and deferred like the print
    kit. The Bottom view now looks up with the rear edge at the top, so the
    silkscreen reads correctly, and a fill light from be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
2026-10-18 Refresh README images from the current viewer
    The README hero and case captures predated the current design, and all four
    cases rendered in the default cream. viewer/capture-readme.cjs now renders
    them from docs/offline.html: the default design (Level), Solid, Color rim and
    Terrace each loaded as a design JSON with its suggested finish, and the
    Asanoha edition on a black mask from below. Images are trimmed to the model;
    hashes go to validation/revI-readme-images.json.
    README shows the three other cases and the PCB underside and points to the
    Design → PCB tab; docs/viewer.md documents the tab, the Bottom view and how
    to regenerate the images and silkscreen textures.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
2026-10-18 Sign the boards by eduarbo and set the signature into each pattern
    The back signature now credits "by", the eduarbo cube and "eduarbo" instead
    of eduarbo.com. The cube comes from eduarbo.com's favicon; in one ink three
    thin cuts keep its faces apart (tools/branding/eduarbo.py).
    Editions no longer clear a rounded box around the signature. The pattern
    stops along the signature's own outline (closed over 0.9 mm, 0.8 mm halo)
    and calms down within 6 mm of it (Canvas.quiet): Vías dots shrink and are
    never cut, Asanoha and Kikkō keep their jigumi and drop spokes, Meandro runs
    straight, Seigaiha fans lose inner arcs and Sayagata its centre vias.
    Without a quiet zone every pattern draws as before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
2026-10-18 Give individual parts eye, Solo and All controls
    A part's detail page now lists its pieces with the same eye toggle and Solo
    button as the component directory. While a part or piece is isolated its
    button reads All and brings the assembly back. The viewer and README
    underside capture are rebuilt with the new signature textures.
2026-10-18 Add Visible, Solo and All controls to the selected part view
    A selected part's page now has a three-way switch under its description:
    Visible hides or shows every piece of that selection without touching the
    rest, Solo shows only it, and All shows every installed part. Each state is
    highlighted. Piece rows keep their eye and Solo; Solo keeps its label and
    a second press restores the assembly.
2026-10-18 Publish only the current viewer assets
    docs/assets kept every print kit and silkscreen texture ever built (about
    72 MB of superseded files). build.mjs now removes deferred assets that the
    current build does not reference; earlier ones remain in Git history. The
    viewer pages are unchanged.
2026-10-18 Generate the Flan family layouts, matrices and outlines
    Flan42 adds the outer pinky column at the pinned Piantor K00/K10/K20
    centres, Flan46 a number row one 17 mm pitch above each column (K41-K45,
    matrix row 4) and Flan54 both. Every Flan36 key, the thumbs and the bay
    stay put. tools/build_variants.py writes design/variants.json and the
    drawings in docs/images/variants/, and checks that new keys keep Flan36's
    own finger-key spacing, that halves mirror exactly, that the Flan36 outline
    equals the revI control vertices and that its matrix transform equals the
    shipped firmware.
    The revI outline rule moves to tools/outline.py, shared with the variants;
    build_revI_profiles.py reproduces design/r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
2026-10-18 Build the routed Flan42 left and right PCBs
    Derive hardware/flan42 from the routed, signed revI boards. Each half
    adds K00/K10/K20 (Choc v1 hot-swap, copies of K01/K11/K21) at the
    variant centres and D00/D10/D20 (SOD-123), wired col2row on ROW0-2 and
    COL0 with no new GPIO, plus H6, an M2 hole one column outward from H1
    that restores Flan36's worst key-side fastener distance (41.65 mm,
    52.54 mm without it). The outline applies revI's board rule to the
    Flan42 case outline; every revI footprint, track, via, hole, the bay,
    battery opening and cutouts stay unchanged.
    Each new key copies its row neighbour's routing translated 18 mm; the
    grid router links the rows and COL0 and smooth_routes.py str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
2026-10-18 Bring the viewer browser checks in line with the current UI
    The checks still drove the pre-redesign controls (#half, #view,
    #annotations, #isolate-selection, #case-cover, per-key shape selects,
    leader lines). They now open Design tabs, Parts rows with eye and Solo,
    part pages with Visible / Solo / All, and the installed-frame toggles.
    - Reset is camera-only, so a full reset is Show all plus Reset; Undo is
    reached from Design; nav buttons are opened idempotently.
    - Fit and fill checks measure the region Fit reserves beside the
    floating camera views and stage tools, and assert the model stays
    clear of them; canvas captures hide the drawer edge.
    - The per-key variant is set through a des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
2026-10-18 Build ZMK firmware for Flan42
    tools/build_variant_firmware.py generates each variant's shield, keymap
    and conf from design/variants.json: Flan36's pins, display and settings,
    plus the added keys. Flan42's outer column uses matrix column 0, already
    wired for thumb K30, so it needs no new pin; its keymap adds Tab, Ctrl
    and Shift on the left and Backspace, ' and Esc on the right. Number-row
    variants are skipped until their row-4 pin is recorded in pinmap.json.
    build_firmware.sh, firmware_inputs.py and check_firmware.py accept
    <variant>-<part> builds and --keyboard. Rebuilding Flan36 with them gives
    byte-identical UF2 files; its receipt now also lists the new sources.
    Flan42 passes the same dev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
2026-10-18 Let HEX fields handle Escape and keep the hidden-selection note current
    The editor's Escape listener ran in the capture phase and stopped the
    event, so a HEX field never restored its last valid value. It now runs
    in the bubble phase and yields to fields that consume Escape; a field
    with nothing to revert lets the next Escape close the editor.
    The part page's visibility note was only rewritten when the highlight
    stamp changed, and hovering a Parts row then selecting it produce the
    same stamp. The note now tracks the selection and the visibility
    revision on its own.
    Rebuild the viewer; all twelve browser checks, including hex-check,
    pass against docs/offline.html 218f32fd.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
2026-10-18 Share revI libraries and models for Flan42 and rebuild it
    The variant projects now point their library tables and footprint 3D
    models at ${KIPRJMOD}/../revI/ instead of carrying copies, so
    hardware/flan42/libraries and models are gone. Flan42 is rebuilt,
    rerouted, signed, checked and exported with the current tools: KiCad
    10.0.6 DRC, ERC and schematic parity stay at 0 violations and 0
    unconnected items per half, the negative controls still reject their
    mutations, and the Gerber/drill readback still matches 676 outline
    segments and every hole. The router's link order follows DRC, so a few
    added links differ slightly from the previous routing.
    Tool changes for the family: the build receipt re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
2026-10-18 Build the routed Flan46 left and right PCBs
    hardware/flan46 adds the number row to the revI boards: K41-K45 copy
    the top-row key of their column one 17 mm pitch up, with D41-D45, wired
    col2row on matrix row 4. ROW4 goes to D15 on the left and D6 on the
    right, recorded in design/pinmap.json under "variants" with revI's pins
    unchanged. Every free pin was routed; the lowest gave the shortest ROW4
    (left 188.09 mm against up to 198.22, right 178.58 against up to
    188.69).
    The left free pins sit in the nice!nano's RAW-side channel, which at
    revI's 0.2/0.2/0.5 mm rules already holds three tracks per layer past
    D10; a seventh signal misses by 0.02 mm. The left number-row board
    therefore leaves U1 GN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
2026-10-18 Build the routed Flan54 left and right PCBs
    hardware/flan54 combines Flan42's outer pinky column with the number
    row: K00/K10/K20 copy column 1, K40 copies K01 and K41-K45 the top row,
    all wired col2row, ROW4 on D15 left and D6 right as for Flan46, with U1
    GND3 released on the left to make room in the RAW-side channel.
    Fasteners H6, H7 and H8 (H1 one column out, H2 one row up, H1 out and
    up) keep every key-side edge point within Flan36's own fastener
    distance.
    KiCad 10.0.6 DRC, ERC and schematic parity: 0 violations, 0 unconnected
    per half; 349 pads and 27 matrix keys read; negative controls reject a
    wrong pad net, a disconnected row and a moved key; the Gerber/drill
    readback matches 676 ou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
2026-10-18 Build ZMK firmware for Flan46 and Flan54
    The number row is matrix row 4 on D15 (left) and D6 (right), the pins the
    Flan46 and Flan54 PCBs route (design/pinmap.json → variants). Their
    keymaps add 1-0 on the base layer and F1-F10 on Numbers; Flan54 also
    carries Flan42's outer column, with ` and - on the number row and F11/F12
    on Numbers.
    pinmap.json is a firmware input, so every keyboard was rebuilt: Flan36 and
    Flan42 come out byte-identical to the published UF2 files, and all four
    pass the devicetree, GPIO, role, display, sleep and UF2 checks (36, 42, 46
    and 54 positions).
2026-10-18 Export the six silkscreen editions for Flan42, Flan46 and Flan54
    export_editions.py takes --variant: each pattern follows the variant
    board's own outline and keys around its signature, and every edition
    and half passes revI's print checks, DRC with schematic parity, a
    saved-board readback and a byte comparison showing that only
    B_Silkscreen differs from the base package. Packages go to
    hardware/<variant>/fabrication/editions/, receipts to
    validation/<variant>-editions.json and 16-colour previews to
    docs/images/editions/<variant>/.
    components_merge() now tests stroke halos pairwise. Counting fused
    halos also changed when a buffer artefact split one tiny stroke's halo
    (Flan46 Asanoha, right: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
2026-10-18 Prove one GND net without GND3 on the number-row left boards
    check_routed_pcb now joins every GND pad, track and via wherever their
    copper meets on a shared layer, independently of DRC, and requires one
    island holding J1 pad 2 on Flan46 and Flan54. The left halves keep 6 GND
    pads (U1 GND1/GND2, J1, J2, SW2) in one net with U1 GND3 no-connect;
    the right halves 7 with GND3. A new negative control cuts J1's GND link
    and is rejected; the variant mutations are now made as text, because
    removing items through pcbnew corrupts later cases.
    design/pinmap.json keeps "variants" to the firmware reader's shape
    (flan46/flan54 -> left/right -> row4); the pin choice rationale stays
    in docs/variants.md, whi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
2026-10-18 List variant edition ZIPs and rasterize their silkscreen textures
    design/pcb-options.json gives every edition a "variants" map with the
    left and right ZIPs of Flan42, Flan46 and Flan54 (the base edition uses
    each variant's prototype package); revI's "packages" are unchanged.
    build_silkscreen_textures.py renders each edition through one function:
    revI into build/silkscreen-textures/ exactly as before, and each variant
    into build/silkscreen-textures/<variant>/ from that variant's KiCad
    outline, listed in the manifest under "variants" with bounds, textures
    and thumbnails. revI's 14 textures and 7 thumbnails come out byte
    identical to the original script's (gerbonara 1.5.0, rsvg-convert
    2.62.3,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
2026-10-18 Refresh firmware receipts for the final pin map
    design/pinmap.json lost its explanatory row4_choice key, and it is a
    firmware input. All twelve builds were repeated against it: every UF2 is
    byte-identical to the published file, and Flan36, Flan42, Flan46 and Flan54
    pass the firmware checks again.
2026-10-18 Build the four case styles for Flan42, Flan46 and Flan54
    tools/freecad/build_variant_case.py derives each variant's case from the
    revI document, so the stack, bay, frames, magnets, batteries, ports and
    every Flan36 feature stay identical. It checks that each outline sketch
    holds exactly the revI profile it stands for, then writes the variant's
    profile, derived with build_revI_profiles.py's offsets; the runtime must
    first reproduce revI's profiles. Added keys copy their template key's
    switch cut, switch, hot-swap and keycap, spliced into the plate chain.
    Added fasteners copy their source fastener's pillar, pilot, seat, drills,
    washer, screw and Level driver access. The Level cap openings are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
2026-10-18 Offer the Flan family sizes in the viewer
    Design → Case → Keyboard size switches between Flan36 and every variant
    whose case is built. A variant loads on demand from one deferred
    container: its exact case and PCB STL files, each stored once, plus its
    silkscreen textures. The viewer builds render meshes from those STL
    files, creased at 45° like the scene builder, so the print kit's files and
    the model are the same bytes. The offline viewer embeds every container
    and stays at 81 MiB.
    Added keys and fasteners are scene parts shown only on the variants that
    have them; an added key follows the key beside it (cap, rotation, colour).
    The PCB tab shows each variant's own editions and Gerber li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
2026-10-18 Propose three home page directions
    docs/proposals/home-r1/ has three home pages for Flan, in English with
    a Spanish switch: A Quiet product (warm, editorial), B Blueprint (dark,
    measured) and C Choose first (four large tiles). Each shows the logo, the
    keyboard's capabilities and a size picker that leads to the viewer, with
    desktop and phone screenshots and an index with the implementation plan.
    The renders are real viewer captures of every size (3D and top) on a
    transparent background, made by viewer/capture-home.cjs.
2026-10-18 Load a design's variant whenever it names one
    A loaded design file, undo/redo or a startup design that names a built
    variant not loaded yet now brings that variant in and shows it, instead
    of drawing Flan36 geometry under a Flan42 design. This replaces the
    startup-only special case.
2026-10-18 Propose a home page with a live configurator
    docs/proposals/home-r2/ has two directions, Studio (light) and Night
    (dark), for "Flan Keyboard". In both, the hero is a configurator: size,
    theme, case and keycaps swap instantly between real viewer renders. It
    opens on Flan36, SNES, Color rim and Original keycaps, in English with a
    Spanish switch. The swap cross-fades, takes only the latest request and
    prefetches the views one change away.
    viewer/capture-showcase.cjs renders the 384 views (4 sizes, 8 themes with
    their own frames, 3 keycap shapes, 4 cases) with the viewer's own config
    and theme code, one camera and crop per size, so swaps never move the
    keyboard. It can resume and split sizes ac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
2026-10-18 Mock up a home page around a live 3D keyboard
    design/proposals/home-r3/ holds image mockups, not a site: the hero is the
    real 3D model, arriving assembled, lifting into its layers and settling
    into a slow standby turn that any drag, scroll or slider move takes over.
    The controls stay in view and are visual: real size silhouettes, theme
    swatches, case-section and keycap-profile icons, and a layers slider with
    a reset. Three layouts (Dock, Rail, Immersive), a load-animation
    storyboard and a phone view, with "flan keyboard" as the lockup.
    The frames are viewer captures in SNES, Color rim and Original keycaps;
    src/ has the compositions and the capture and render scripts.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
2026-10-18 Mock up an immersive home with a right rail and frame browser
    Page colors follow the theme; the rail has no outline and real viewer
    previews for size, theme, case, keycaps and the six frames. Layers use a
    vertical slider. Adds a frame browser, a theme transition storyboard,
    a phone view and an enthusiast spec sheet.
2026-10-18 State Piantor's key layout provenance and add a trademark policy
    Flan keeps Piantor's 36 key centres and angles (and Flan42/54 its
    outer column), which the previous "inspired the key count" wording
    understated. ATTRIBUTION, README and the build guide now say so,
    while keeping the PCBs, case outline, cases, frames and firmware
    credited as original work.
    TRADEMARKS.md reserves the Flan names and marks under GPL-3.0
    section 7(e): anyone may build and sell from the files, but products
    sold under the Flan name need a license, and official kits come only
    from Eduardo or listed sellers.
2026-10-18 Open the site on a live home page and move the explorer to /explore/
    The root is now the Flan Keyboard home from the approved R4 design: a
    live model that eases its layers apart and idles with a slow turn, a
    vertical layers slider, and a right rail for size, theme, case, keycaps
    and the six frames, with live thumbnails in the current colours. Page
    colours follow the theme, including dark pages for dark themes. A frame
    browser previews on the model before applying, per half or both. English
    by default with Spanish, a spec sheet, and the maker credit in the footer.
    The model comes from the viewer scene: welded, simplified within stated
    errors with meshoptimizer, quantized and meshopt-encoded,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
2026-10-18 Credit Piantor's key layout in the viewer and add a Ko-fi link
    The explorer's credits and GLB attribution still said Piantor only
    inspired the key count. They now match ATTRIBUTION.md: inspired by
    Piantor and keeping its key positions and angles; PCBs, case
    outline, cases, frames and firmware original. The explorer is
    rebuilt.
    reliability-check opened the site root, which became the home page
    in 1ba4918; it now targets /explore/ and its assets, and asserts
    the new attribution. It passes through the GLB step; its later
    storage-recovery step and viewer/check.cjs time out on navigation
    clicks, which HEAD's published explorer also does.
    .github/FUNDING.yml adds the Ko-fi sponsor link.
    Co-Auth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
2026-10-19 Raise the home model and illustrate every spec
    The hero title becomes a tagline, since the lockup already names Flan
    Keyboard (kept for screen readers). The model is fitted by every part's
    projected corners and centred on what is seen, so it sits higher and
    larger, and the rail is compact enough to keep its button on screen at
    about 770 px tall, with the R4 spacing on taller screens.
    Each spec card gets an illustration rendered from the same model in the
    current colours: the profile and key pitch with dimensions measured from
    the meshes, the controller, the display, the four sizes, the separated
    electronics stack, the six frames and the PCB. They render when the sheet
    nears the screen.
    Co-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
2026-10-19 Make the home model smooth: instancing, one frame per tick, async thumbnails
    Measured on the real GPU at retina desktop sizes, a drag ran at 11-15 fps
    and a theme change froze for over a second. Causes and fixes:
    - A controls 'change' during the tick scheduled a second frame, so every
    frame of a drag rendered twice. One tick per frame now.
    - Switch housings, stems and sockets drew once per key and material
    (about 420 calls). They are instanced: about 130 calls in all.
    - Thumbnails used a second WebGL context with synchronous readback. They
    now render into a target of the same renderer, read back asynchronously,
    encode off the main thread, and run one at a time while the model is
    s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
2026-10-19 Propose colour flan marks and test them as favicons
    The one-colour mark fades at 16 px and almost disappears on dark tabs.
    Six colour proposals fill the same three-quarter geometry: lit and
    shaded custard faces, a glossy caramel top running darker down the
    front, with an outline, on a plate, in two flat inks, and on cream and
    caramel tiles for favicons and app icons. The review sheet shows each in
    real browser tabs, light and dark, and pixel by pixel at 16 and 32 px.
    flankey.iso_regions() exposes the mark's parts; iso() is unchanged.
2026-10-19 Add a real favicon tester with softer colour marks
    R1 read as clip art. R2 returns to the selected Caramel concept: pastel
    custard, milky caramel and two large drips, with or without a caramel
    outline, the current mark filled in, and the current mark in one caramel
    ink. Outlines and the single ink lighten under a dark browser theme.
    docs/proposals/favicon/ sets each option as the page's actual favicon,
    so it shows in the reader's own tab at real size and in their theme; each
    option opens in its own tab for side-by-side comparison.
2026-10-19 Propose keycap-like takes on the colour mark in the favicon tester
    Eduardo kept "La marca, a color" and asked for variants that read more
    as a keycap or use another drawing style. R3 keeps its palette and
    outline and varies the cap: Choc low-profile proportions, a dish with
    the homing bar, the Choc cap on its switch, plus a die-cut sticker, a
    fine-line drawing and the flan standing on two red Choc stems.
    iso_regions() takes the cap's proportions and drips as parameters; the
    defaults still produce the current mark exactly.
2026-10-19 Try five different concepts for the colour mark
    R3 read as one design tweaked seven times. R4 changes the concept: the
    cap seen from above with caramel running down all four sides, the F key's
    legend in caramel with a drip and the homing bar, a sculpted cap in
    profile on its red Choc stem, 16 x 16 pixel art, and a two-shape flat
    flan. Same custard and caramel; outlines lighten on dark browser chrome.
    The favicon tester now shows R4 beside "La marca, a color" and the
    current mark.
2026-10-19 Mock up the explorer in the home page's language
    R1 for the 3D explorer: theme-driven page, an outline-free right panel
    with live thumbnails, the vertical layers slider, and three modes
    (Design, Parts, Files). Usual options stay in view; advanced ones open
    in place behind one quiet link per section (per half, colours, key
    painting on the real layout, palettes, installed frames, PCB). Parts
    leads with the selected part; Files adds a share link. Includes a phone
    layout and a map of where every current control goes.
2026-10-19 Let the home's text float over the model
    The canvas now fills the hero behind the copy, rail and controls, and a
    camera view offset keeps the keyboard framed in the stage area, so a
    zoomed or turned model passes under the headline instead of being cut
    off at the stage's edge. The phone strips get room for selection rings.
2026-10-19 Redesign the explorer in the home page's language
    The explorer follows the approved R1 mockups. The page takes its colours
    from the keyboard and the transparent model floats on it with a soft
    shadow under each half. A top bar holds the lockup, the Design, Parts and
    Files modes, undo and redo, the save state, Share and About. Design opens
    beside the model as stacked sections with real thumbnails and theme
    swatches; each section's advanced options open in place behind one quiet
    link. Layers move on the home page's vertical slider and the camera views
    sit in one chip that folds into a menu on narrow scenes. Phones get the
    home page's tabbed sheet, with room for every selection ring.
    Share copi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
2026-10-19 Drill the added keys into the variant viewer PCBs
    The viewer's Flan42, Flan46 and Flan54 boards were revI's board in the
    variant outline, so the outer column and the number row showed blank
    board. Each added key now gets its template key's Choc hot-swap holes
    (the switch, its pegs and the socket pins, seven per key), as the
    routed variant boards place them. --reuse --pcb-only re-exports just
    these meshes from the saved documents and updates their receipts.
2026-10-19 Fix the home's layout art and add Ko-fi support links
    The Layout card now draws every key of the chosen size from above on
    its key plate, the three splayed thumbs included, as its text says.
    It selects keys by their own reference: an added key used to pass as
    the key it copies. Each dimension is tied to real keys with extension
    lines: 17 mm between the outer column's top two keys, 18 mm between
    the two inner columns. The size packs carry the drilled variant PCBs.
    Support links to ko-fi.com/eduarbo: a heart in the nav, a pill in the
    footer (English and Spanish) and a section in the README.
2026-10-19 Draw the spec dimensions on the edges they measure, at 1:1
    The layout card's dimensions ran centre to centre with faint guides, so
    they matched no visible edge, and the 18 mm label met its own tick. They
    now run between key edges: top edge to top edge in the outer column
    (17 mm), left edge to left edge of the two inner columns (18 mm). The
    profile's 14.5 mm runs from the case's lowest edge to the frame plane.
    Labels get measured room, and lines sit on the device pixel grid.
    The layout shows the whole half again, frame and display included, so
    the key plate no longer ends in a hard cut at the bay.
    Each spec art now renders at the size of its box (152 × 84 on a phone,
    at up to 3× density)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
2026-10-19 Let the explorer switch between English and Spanish
    The explorer's top bar ends in EN · ES pills, as in the R1 mockup.
    It translates the same way the home page does: data-t keys, one
    dictionary (viewer/i18n.js), html[lang] and the visitor's choice,
    which the explorer and the home page share (flan.lang). English
    stays the default.
    Spanish covers every label, aria-label, title and placeholder, plus
    what the scripts write: status lines, notes, part names and notes,
    the individual parts list, errors and saved-data messages. A switch
    redraws the scripts' labels in place, and switching back restores
    the exact English. Option names stay as the home page shows them
    (themes, frames, case styles, ke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
2026-10-20 Consolidate the docs and images around the new site
    New README and guide images from the current site. Renders from the
    explorer come out transparent with the contact shadow: the hero with
    its layers apart, the four cases in their suggested finishes and the
    Asanoha underside. Screenshots show the home page, the explorer, Theme
    per half, Paint keys and both pages on a phone.
    viewer/capture-readme.cjs makes them all and records their hashes.
    The README now introduces Flan and its four sizes, as the site does. The
    guides use the explorer's current paths (Design → Size, Theme, Case,
    Keycaps, Frame, Battery and PCB) and flankbd.com links, and spell
    "color" one way. The parts guide adds quantit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
2026-10-20 Lead the explorer from Design to a built keyboard
    Files becomes Build (Construir), and "Build this keyboard →" is pinned
    at the foot of Design, on desktop and in the phone sheet. Build lists
    what the chosen size needs, in five numbered steps:
    - the parts, with switch, socket and diode packs and screws;
    - the PCBs, with the chosen edition's Gerber ZIPs and mask;
    - the print kit;
    - the size's three firmware UF2 files;
    - the build guide.
    Below them, Keep your design holds sharing, JSON, downloads and
    recovery. The Battery and PCB group in Design is now Electronics.
    The complete print kit, now the default, carries the keycaps: each KLP
    Lamé file the design uses, unchanged, fetched from its o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
2026-10-20 Keep the build button in line at the end of Design
    Pinned to the foot of the panel, "Build this keyboard →" covered the
    options above it, the frame thumbnails among them. It now sits in line
    after Electronics, and on a phone below each tab's options. It is still
    where a finished design arrives, and it never covers a control.
2026-11-11 Unify Flan PCB branding and select editions per half
2026-11-12 Select solder mask colors independently for each PCB
2026-11-12 Build shopping lists and assembly guides from the selected keyboard
2026-11-12 Keep design URLs current and illustrate responsive shopping cards
2026-11-13 Export verified assembly files from the physical pads
    KiCad's position export misplaces the hot-swap sockets: their footprint is a
    front-side through-hole footprint centred on the switch, while the part is
    surface-mounted on the back, 5.46 mm away. tools/export_assembly.py derives
    each placement from the physical pads, checks it against the assembler's
    library footprint and writes BOM and placement files per half.
2026-11-13 Add a diodes-only assembly export profile
2026-11-13 Offer common M2 screws as an option in the explorer
    Build > Buy the parts now has a Screws choice for Flan36. Common M2 swaps in
    the plates and frames with deeper head pockets, and the model, link, saved
    design, shopping list, guide, print kit and complete build ZIP follow it.
    The low-head reference stays the default: a design without the new optional
    "fasteners" key opens exactly as before, and other sizes fall back to it.
    The variant's changed exports are adopted with a receipt that binds each file
    to the installer's hash and requires a passed driver-access report for all
    four case styles. They load on demand as one deferred asset.
    Digital checks only; printed fit and thread strength rem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
2026-11-13 Say what the assembly export's PASS covers
2026-11-13 Record long-screw head gaps and surface a failed screw-profile download
    Two independent reviews of the common M2 option found no blocking defect and
    these gaps, now closed:
    - The installer's 0.30 mm clearance rule covers only the pocketed short
    screws. The receipt now records the side gap around a 4 x 2 mm head at the
    long screws. Only Level has a wall nearby, 0.10 mm at the rear screw; the
    explorer says so for that case and the shopping note no longer claims fit.
    - A failed download of the profile stays visible beside the choice, and
    choosing it again retries.
    - The viewer build refuses a profile exported from a different default CAD,
    and unchanged material parts are bound by has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
2026-11-13 Draw the eduarbo cube from its published outlines
    The credit on the back of every board showed the cube with three gaps cut
    between its faces. The gap between the top and the upper right face ended at
    the inner corner and left a notch, and the gaps broke the mark's shape. The
    published logo (eduarbo.com public/favicon.svg) has four paths that touch.
    The mark is now those four paths filled as one outline, with nothing added
    or cut; mark() asserts that every vertex is a published one. All four sizes
    were signed again and their packages and editions exported again: the 56
    packages differ from the previous ones only in B_Silkscreen, and each holds
    the cube as one outline with the published vert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
2026-11-13 Add EVA-00, EVA-01 and EVA-02 themes
    Three themes inspired by the Evangelion units: amber with white keys,
    purple with green and orange, and red with cream, orange and green. They
    follow the existing scheme (one base for the finger columns, three thumb
    accents) and have no dedicated frame. The stated theme count is now 31, and
    the home page reads it from the data.
2026-11-13 Keep the page's lightness away from the case
    The page took a bright tint for every light-bodied design and a dark one
    for dark bodies, so a pale case sat on an equally pale page and its edges
    disappeared: across the 28 themes the case-to-page contrast went as low as
    1.02:1.
    The two inner page tones now stay at least 0.10 of OKLCH lightness from the
    case. A pale case gets a page darker than itself, a mid-tone one keeps the
    bright page, and a near-black one gets a lighter dark page. Muted text and
    the accent are moved along lightness until they read on the new tone.
    viewer/page-colors-check.mjs checks every theme and a sweep of plain case
    colours: the case stays at least 1.34:1 from the page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
2026-11-13 Finish the theme count and note third-party names
    Two mentions of 28 themes were left: the README's themes line and the home
    page's static subtitle, which is what a visitor or crawler sees before the
    script localizes it.
    ATTRIBUTION.md now says that theme and frame names such as Game Boy, iPod or
    the EVA units only describe a palette or a look, with no affiliation and no
    borrowed artwork. The progress log notes that the Evangelion proposal the
    owner rejected earlier was a display frame; the EVA themes are palettes the
    owner asked for.
2026-11-13 Rebuild the site with the corrected cube, EVA themes, page colours and headline
    The explorer and home page are rebuilt from the previous five commits:
    - The PCB textures, thumbnails and hosted packages come from the re-exported
    Gerbers, so the model and every download carry the cube as published. The
    explorer links all 56 current packages; the 56 superseded ones left the
    site in the previous commit, which removed them without saying so.
    - 31 themes, with EVA-00, EVA-01 and EVA-02.
    - The page keeps its lightness away from the case.
    - The headline, the home poster and the share image, which still showed the
    old headline and 28 themes.
    The README and guide images are captured again fr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
2026-11-13 Keep frame artwork visible in every theme
    Twelve themes had a frame inlay colour too close to the frame body, down to
    the same colour, so part of a frame's artwork vanished: the petals of the
    Talavera frame in Tidal, for example.
    Each of those colours keeps its hue and chroma and moves along lightness
    until it stands 1.6:1 from the body. Keycap and case colours are unchanged,
    and a saved design keeps the colours it was saved with.
    page-colors-check now requires every theme's frame inlays to stand at least
    1.5:1 from the frame body.
2026-11-13 Light the model like a studio so parts of one colour stay apart
    With even lighting and no shadows, parts that share a colour ran into each
    other: keys into their neighbours and into the case. The owner tried a lit
    variant behind a link option and asked for it.
    The explorer and the home page's live model now take their light from a
    procedural room, cast soft shadows on themselves and on the floor, use a
    neutral tone curve that keeps theme colours true, and give each kind of
    part its own surface: satin keys, matte case, glossy solder mask, metal
    hardware. A broad lamp straight above darkens the gaps between keys.
    explore/?render=flat keeps the earlier look, and so does a browser without
    hard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
2026-11-13 Apply review findings to the lit look
    Two independent reviews of the previous three commits found no blocking
    defect and these points, now closed:
    - The option thumbnails are drawn by the main renderer, so they were going
    through its new tone curve; the previous commit said they were unchanged.
    They are now drawn without it.
    - The lamp from below was dimmed with the others. It keeps the PCB's mask
    colour true in the Bottom view, and the room is dark underneath, so it
    stays close to its earlier strength.
    - Percentage-closer shadows ignore radius and blur settings in this version
    of the 3D library: they are removed and the comments no longer promise a
    very soft shadow.
    - The home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
2026-11-13 Open the home page on the EVA-01 look
    The owner chose the configuration for introducing Flan: Flan36 in EVA-01,
    Color rim case, Original keycaps, the SNES frame on the left and the Phone
    frame on the right. The home page opens with it, its first paint already
    uses that theme's page colours, and the poster, the share image and the
    README captures show it.
    The share image also carries the four sizes under the headline.
2026-11-13 Recover from a stale page and keep the old offline address working
    Two independent reviews of the previous two commits found no blocking
    - A page cached from before a deploy points at a model file that is gone.
    It now reloads itself once to get the current page, then shows the error.
    - A network failure while fetching a deferred file shows the same message
    as a missing file instead of the browser's raw text.
    - explore/offline.html no longer exists on the site. A not-found page sends
    that address to explore/offline.zip and links home and the explorer.
    reliability-check and loading-check assumed the model was inline: the first
    counted every file fet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
2026-11-13 Rebuild the site: lit model, model file, EVA-01 opening look
    The explorer and home page are rebuilt from the eight commits since the
    last build:
    - The model is lit like a studio and casts shadows, in the explorer and on
    the home page.
    - The explorer page is 1 MB and fetches its model from a hashed file; the
    offline copy is docs/explore/offline.zip.
    - Theme swatches sit eight to a row, and every theme's frame artwork is
    visible.
    - The home page opens on Flan36 in EVA-01 with the SNES and Phone frames.
    The poster, the share image (with the four sizes) and the README captures
    show that look.
    This also restores the offline download, whose link has pointed at a
    removed file since the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
2026-11-13 Apply review findings to the metadata and summaries
    defect. Their points, now closed, with the site rebuilt:
    - llms.txt said the files are free to sell without the trademark limit, and
    named the Game Boy, SNES and iPod frames without saying Flan is not
    affiliated with their owners. Both sentences are added; the Piantor credit
    now covers the outer column of Flan42 and Flan54.
    - The descriptions and link previews say "digital prototype", as the
    positioning notes require where the stage matters.
    - schema.org has no additionalProperty on a creative work: the facts move
    into its description and keywords, and the prod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
2026-11-13 Start the home page lighter and keep its layout still
    On a phone the rail's tabs and options appeared when the script ran, which
    pushed the call to action and the spec sheet down (CLS 0.101 on an emulated
    phone). The build now writes the rail's buttons into the page from
    viewer/home/options.js, so the layout is final at the first paint; the
    script gives them their pictures and actions.
    Another size's pack is fetched when its picture is first wanted: beside the
    model at once, on a phone when Size is opened or the spec sheet's size card
    nears the screen. Packs are inflated by the browser instead of fflate, and
    meshes are decoded and creased a few at a time so the page can paint in
    between.
    E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
2026-11-13 Load the explorer's meshes on demand, one file per option
    Every visit fetched one 38 MB scene file before drawing anything, although
    about 70 % of its geometry belonged to options not on screen. The build now
    publishes a short description of the scene (90 KiB) and 43 mesh files,
    12.5 MiB in all: one for the fixed parts and one per case style, frame,
    keycap shape, battery profile and the PCB. A mesh two options share gets
    its own file.
    - The page fetches the fixed parts and the outside of its design first
    (cases, frames, keycaps: about 2 MB), then the PCB and the batteries with
    their leads, which sit inside the closed case. Another option's meshes
    arrive when its cards come into view o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
2026-11-13 Recover when a mesh file does not arrive; apply review findings
    Two independent reviews of the on-demand meshes found that a mesh fetch
    failing after start left "Loading parts…" up and exports disabled until
    the visitor chose something else.
    - A mesh that does not arrive is asked for again after 4, 15 and 60
    seconds and when the connection returns; the status then says what
    failed instead of "Loading parts…", and an error while applying the
    design again is shown rather than swallowed.
    - Home: a size pack that failed is fetched again the next time it is
    wanted, a look that arrives clears an earlier failure's note, and a
    browser without DecompressionStream (Safari before 16.4) i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
2026-11-13 Rebuild the site: meshes on demand, lighter home start
    Built from 4d77c7a. The explorer's scene description is 90 KiB and its
    meshes are 43 files, 12.54 MiB in all, in place of one 39.4 MB scene file;
    the offline ZIP is 42 MB (68 MB before). Adds the two pictures shown while
    a link to the home page's look loads and the PCB cards' picture file.
    validation/revI-viewer.json lists every mesh file with its hash and the
    largest normal error (0.0047 degrees); positions and triangles were read
    back byte for byte. pcb-check redrew docs/images/revI-pcb-underside.png.
    Checks on this build: 24 pass, including the new meshes-check. check,
    responsive-check, customize-check and stability-check fail as th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
2026-11-13 Show the home page and its poster before the 3D engine
    The page carried three.js inline: about 185 KB of compressed HTML that the
    poster shared a slow line with, compiled on the main thread before anything
    could be used. On a phone the browser also stopped timing the poster as the
    largest picture, because the theme strip scrolled with animation as the page
    opened.
    - The page's own script (rail, language, colours) stays inline. three.js and
    home/model.js become assets/home-engine-<hash>.js, asked for once the poster
    is on screen (the browser's largest-contentful-paint report, or two frames
    after it loaded, or 3 s), together with the look's two mesh packs, which the
    model then reads.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
2026-11-13 Pinch the home model's zoom with two fingers
    On a touch screen the home page's model could not be zoomed: zoom answered
    only to Ctrl/Cmd + wheel, which a trackpad pinch sends and fingers do not,
    although the hint under the model says "pinch to zoom". A second finger also
    swung the model to the fingers' midpoint.
    - Two fingers on the model pinch its zoom. While two or more are down the page
    neither scrolls nor zooms under them and the model does not turn; the finger
    that stays goes on turning it. Counting fingers is passive, so a swipe that
    scrolls the page never waits for the script. The phone layout stops at 2.5x,
    clear of the options under the model; elsewhere 3.6x as before.
    - A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
2026-11-14 Remove prototype labels and add themed Flan cover variants
